craigyjp/Teensy-Hybrid-TDM-Synth/README.md

# A Hybrid 8 voice polyphonic synthesizer that utilizes the Teensy Audio Library for the DCOs, LFO's and envelopes and the analogue filters are Shruthi 4Pole Mission based.

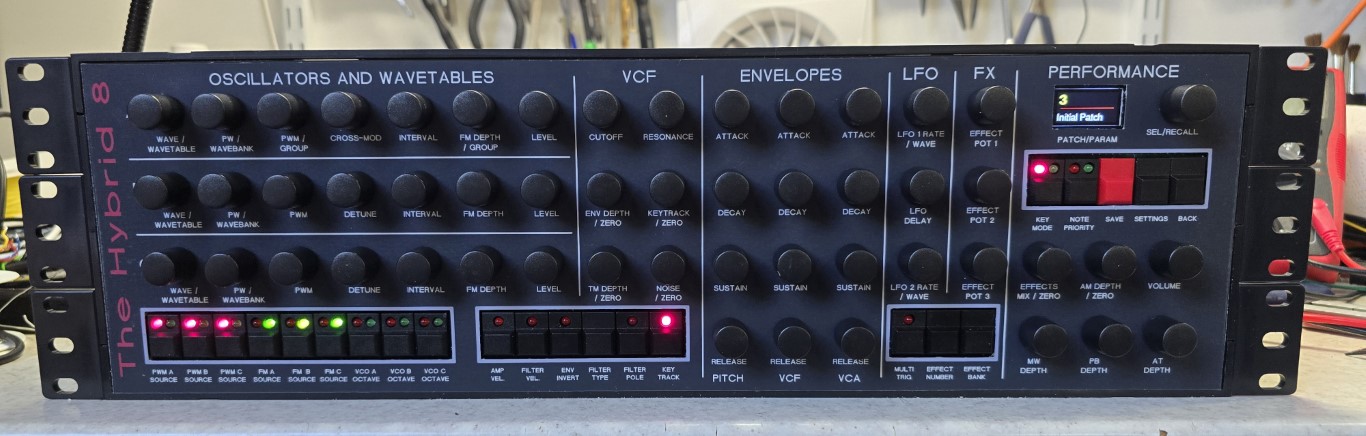
[picture p1: Photos/synth1.jpg]
Synth


I've always wanted to build an oscillator bank that is stable and flexible and has all the usual waveforms of sine, square, triangle, saw and pwm. 

Without a good autoutune the options are limited to Juno 106 style counter DCO's for a polysynth, but seeing how the Teensy Audio Library supports the CS42448 TDM device with 8 outputs. It is possible to build a DCO bank and feed each group of DCOs out of an individual output. These can then feed individual 4 pole analogue filters.

It's early days, but I have an 8 voice, 3 DCO per voice model working with 7 waveforms per DCO, saw, reverse saw, sine, square, triangle, pulse and S&H.

Each DCO has it's own PW and PWM settings and FM depth, interval. The modulation can be from LFO1, Pitch Env and Inverted Pitch Env for FM and LFO2, Pitch Env and Inverted Pitch Env for PWM. These can also be grouped so one set of controls can be used for all 3 DCOs in the voice. Interval is -12 to +12 semitones and this is effectively an octave shift up and down, plus DCOs B & C have a detune. Finally all 3 have a level control as well. There is also a pink and white noise source that can be moved from pink - 0 - white on one encoder.

On top of this if you push the wave encoder button for each VCO then you have access to over 4000 samples of acoustic and electric instruments such as piano etc.

I've made use of the encoder buttons for example, if you push the filter LFO depth encoder it will zero the value and press again it will return to the previous value, same for amplifier LFO depth.  The LFO speed encoders also double as wave selection for the LFOs, so pressing the encoder buttons toggles through the 7 LFO waves.

Also added is a hidden arpeggiator, a press and hold of the Key Mode button switches the synth between arpeggiator and normal operation. Several encoders and buttons are now in charge of the arpeggiator controls, LFO1 rate = Arp rate, LFO Delay = Arp gate time, Amp Velocity = Arp start/stop, Filter Velocity = Arp Hold, VCOB Octave = Arp Range and VCOCOctave = Arp Direction. These settings are stored in patches so you can create arp based patches.

# Features
* 8 voice polyphonic with poly 1, poly 2, mono and unison modes stored in the patch.
* Note priority in Mono and Unison modes, Botton, Top and Last.
* 3 VCOS, with sine, saw up, saw down, square, triangle, pulse (PWM) and random waves.
* PW & PWM per VCO with modulation from LFO2, pitch envelope and inverse (Grouping of parameters)
* FM per VCO with modulation from LFO2, pitch envelope and inverse (Grouping of parameters)
* Cross Modulation from VCO2 to VCO1
* Poly 1, Poly 2, Mono and Unison glide modes.
* Interval settings per VCO with detune on VCO2 & 3
* Volume level setting of each VCO
* Each VCO can be switched to access over 4000 wavetables in 63 banks.
* 4 pole Shruthi filters with pole mixing 16 variations of filter
* Filter Keytrack, filter modulation from LFO1 or LFO2, envelope inversion, filter velocity sensitivity.
* 3 envelopes with full ADSR, pitch envelope for FM and PWM modulation, filter envelope, amplifier envelope.
* VCA with modulation from LFO1 & LFO2
* Dual LFO's with 7 waveforms, Sine, Saw Up, Saw Down, square, triangle, pulse and Sample and hold.
* Delayed LFO upto 10 seconds
* FV1 effects processor with 32 effects algorithms, 3 control pots for variations and an effects mix pot.
* White and pink noise source to the filter.
* Modulation Depth, Aftertouch Depth and Pitchbend Depth controls.
* Full arpeggiator, speed, gate, direction, range and hold.
* MIDI and USB connectivity.
* Full MIDI CC control of parameters

# Things to do

* Maybe add MIDI Clock to the arpeggiator
