craigyjp/Teensy-Hybrid-TDM-Synth/Photos/20250813_210241.jpg

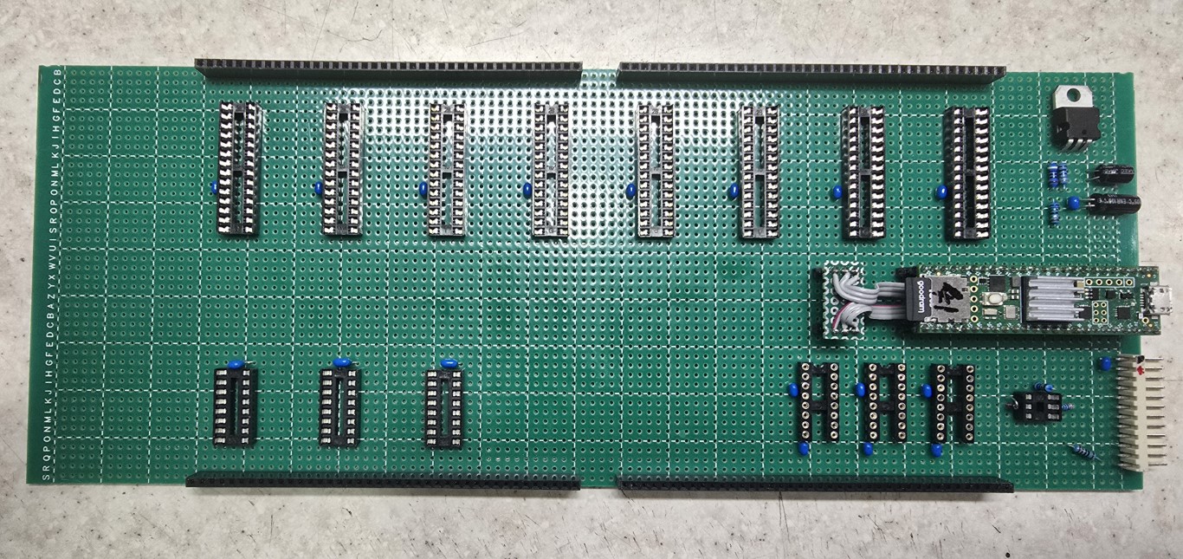
Photos/20250813_210241.jpg
