craigyjp/Teensy-Hybrid-TDM-Synth/Photos/20250813_210249.jpg

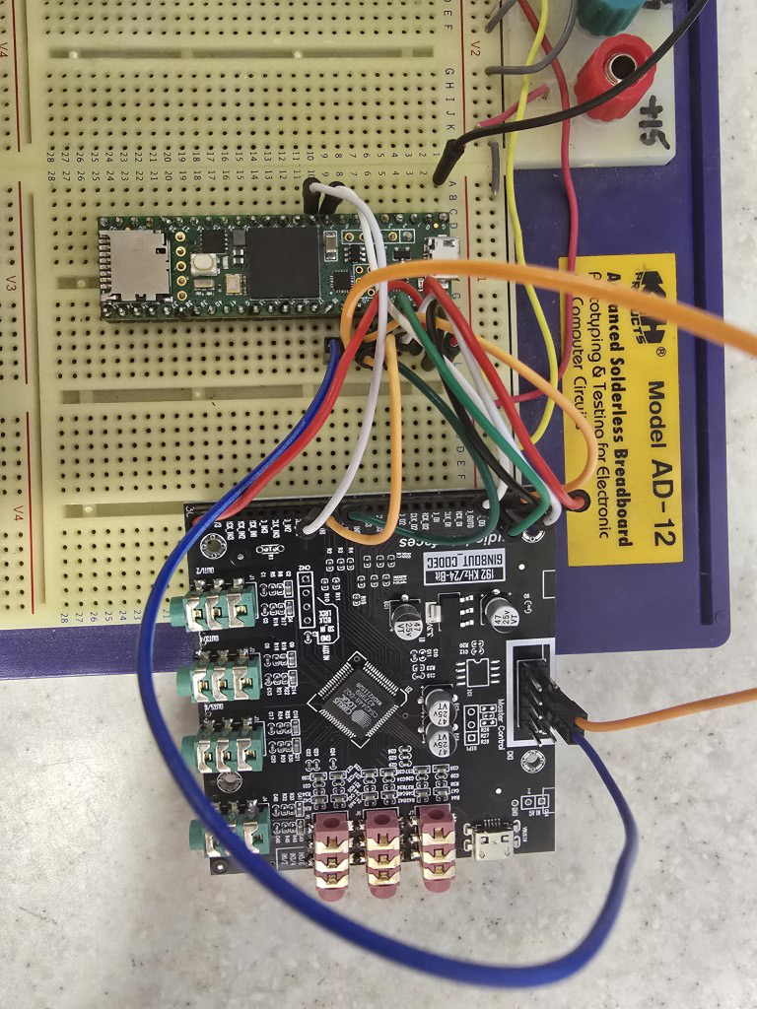
Photos/20250813_210249.jpg
