craigyjp/Teensy-Hybrid-TDM-Synth/Schematics/filter_CV_and_res.pdf

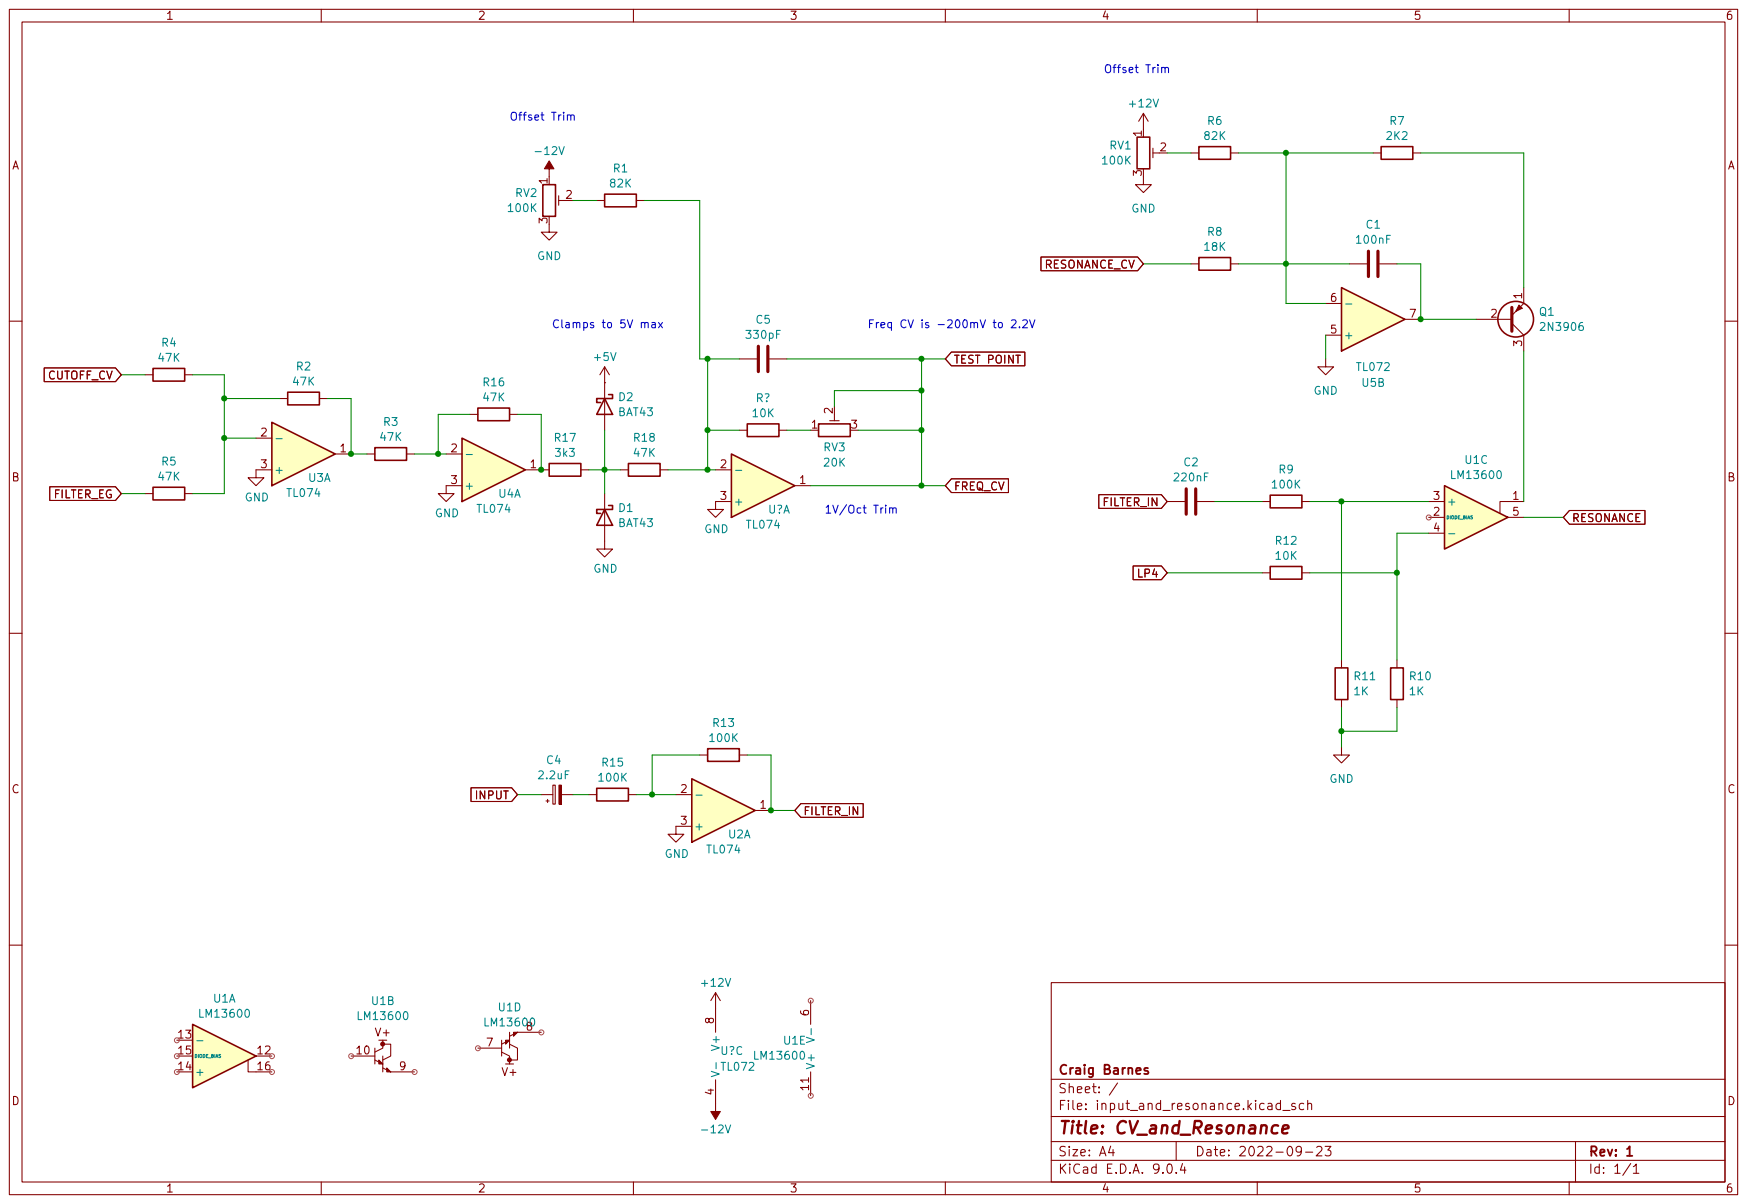
[picture p4: page 1]
