craigyjp/Teensy-Hybrid-TDM-Synth/Schematics/AS2164_core.pdf

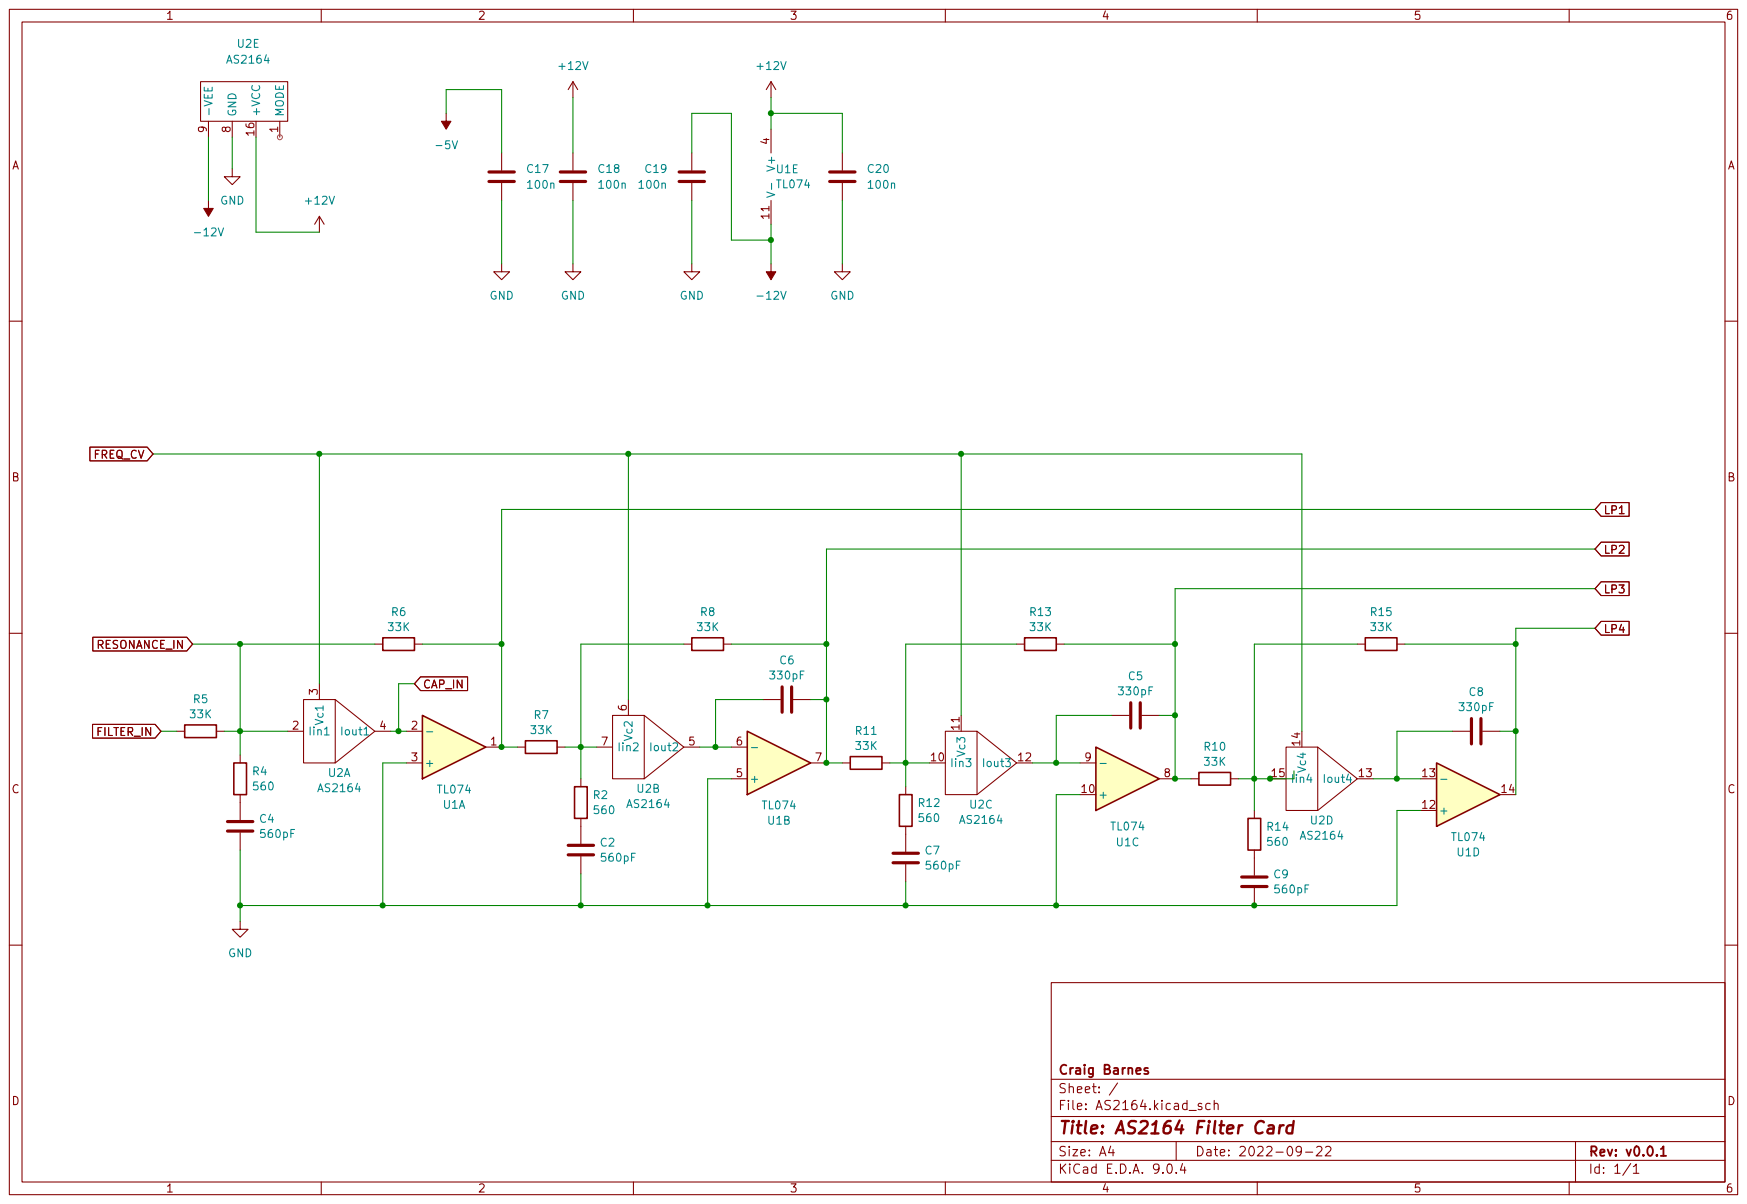
[picture p5: page 1]
