craigyjp/Teensy-Hybrid-TDM-Synth/Schematics/Filter_control_and_EG.pdf

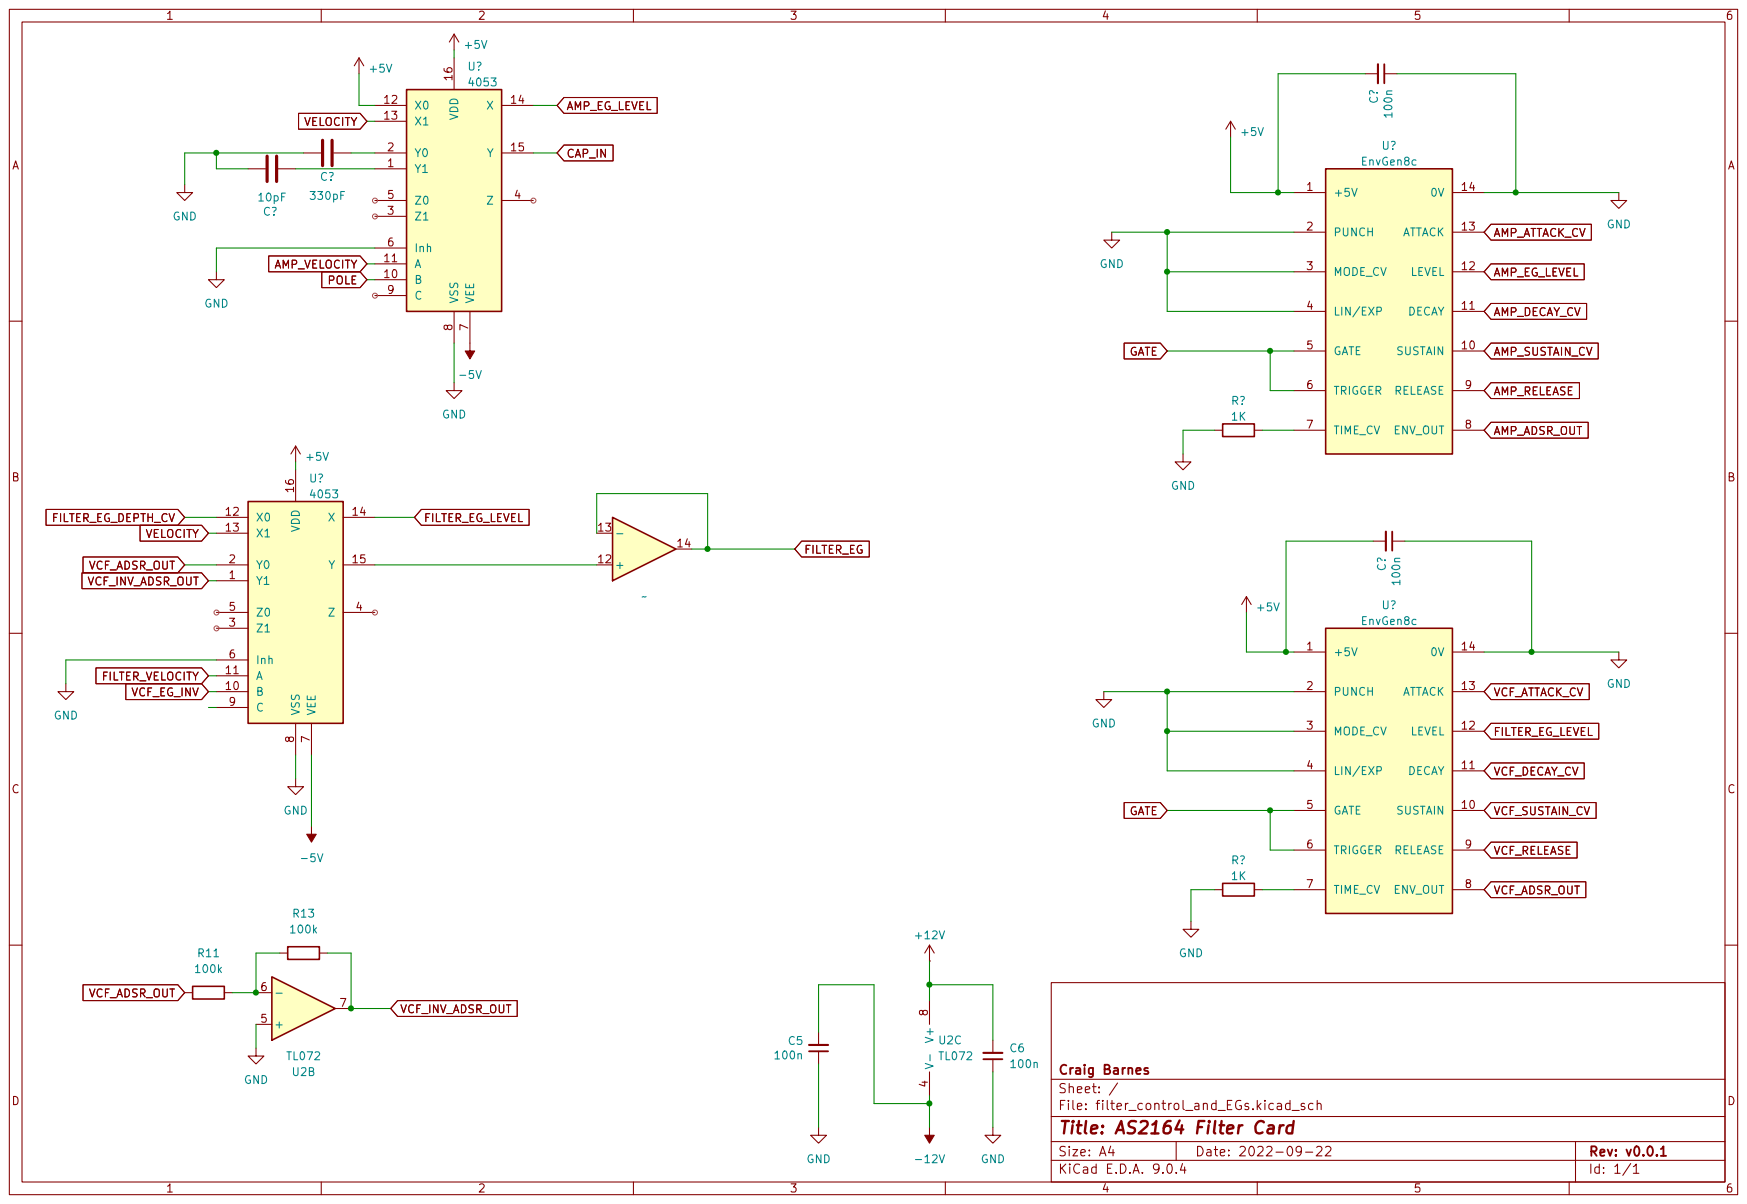
[picture p6: page 1]
