craigyjp/Teensy-Hybrid-TDM-Synth/Schematics/TDMSynth_Logic1.pdf

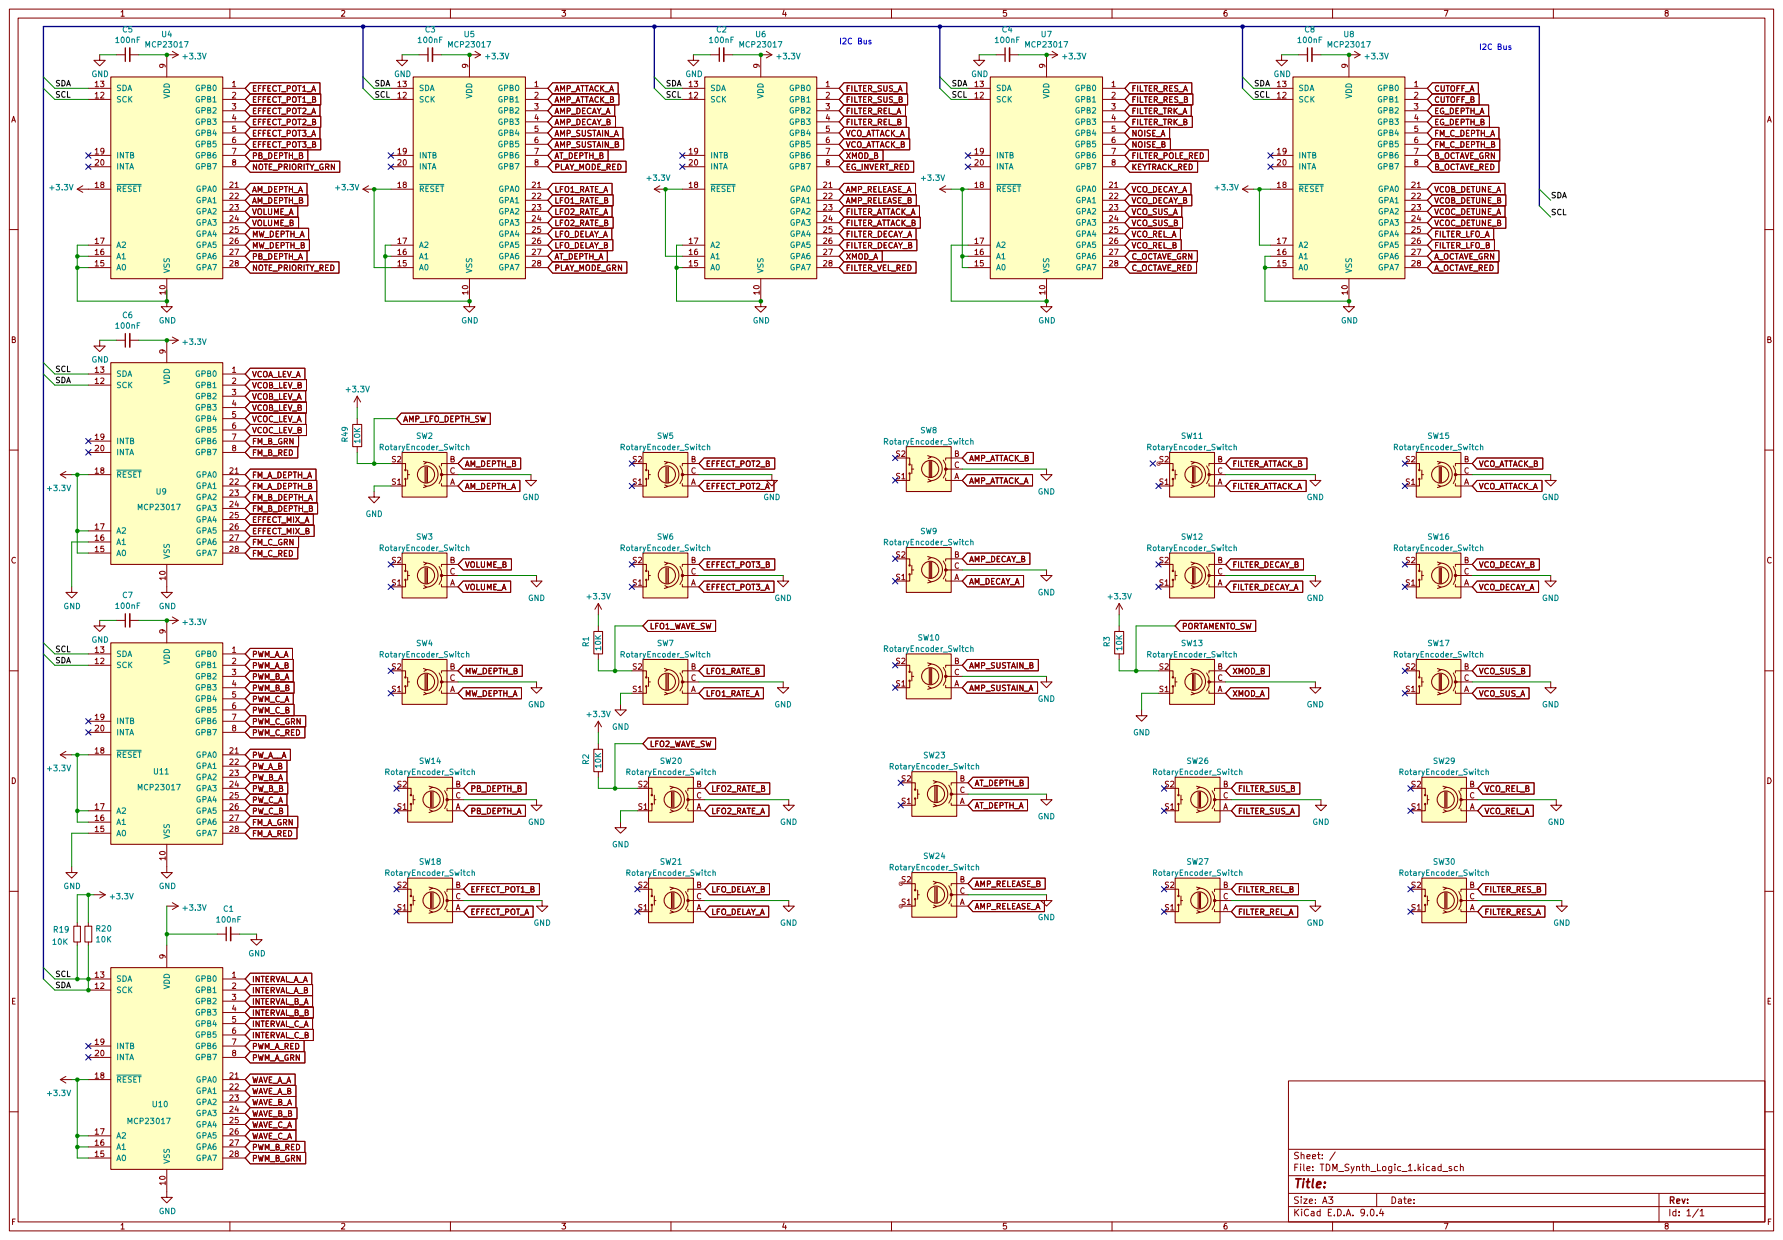
[picture p7: page 1]
