craigyjp/Teensy-Hybrid-TDM-Synth/Schematics/TDMSynth_Logic2.pdf

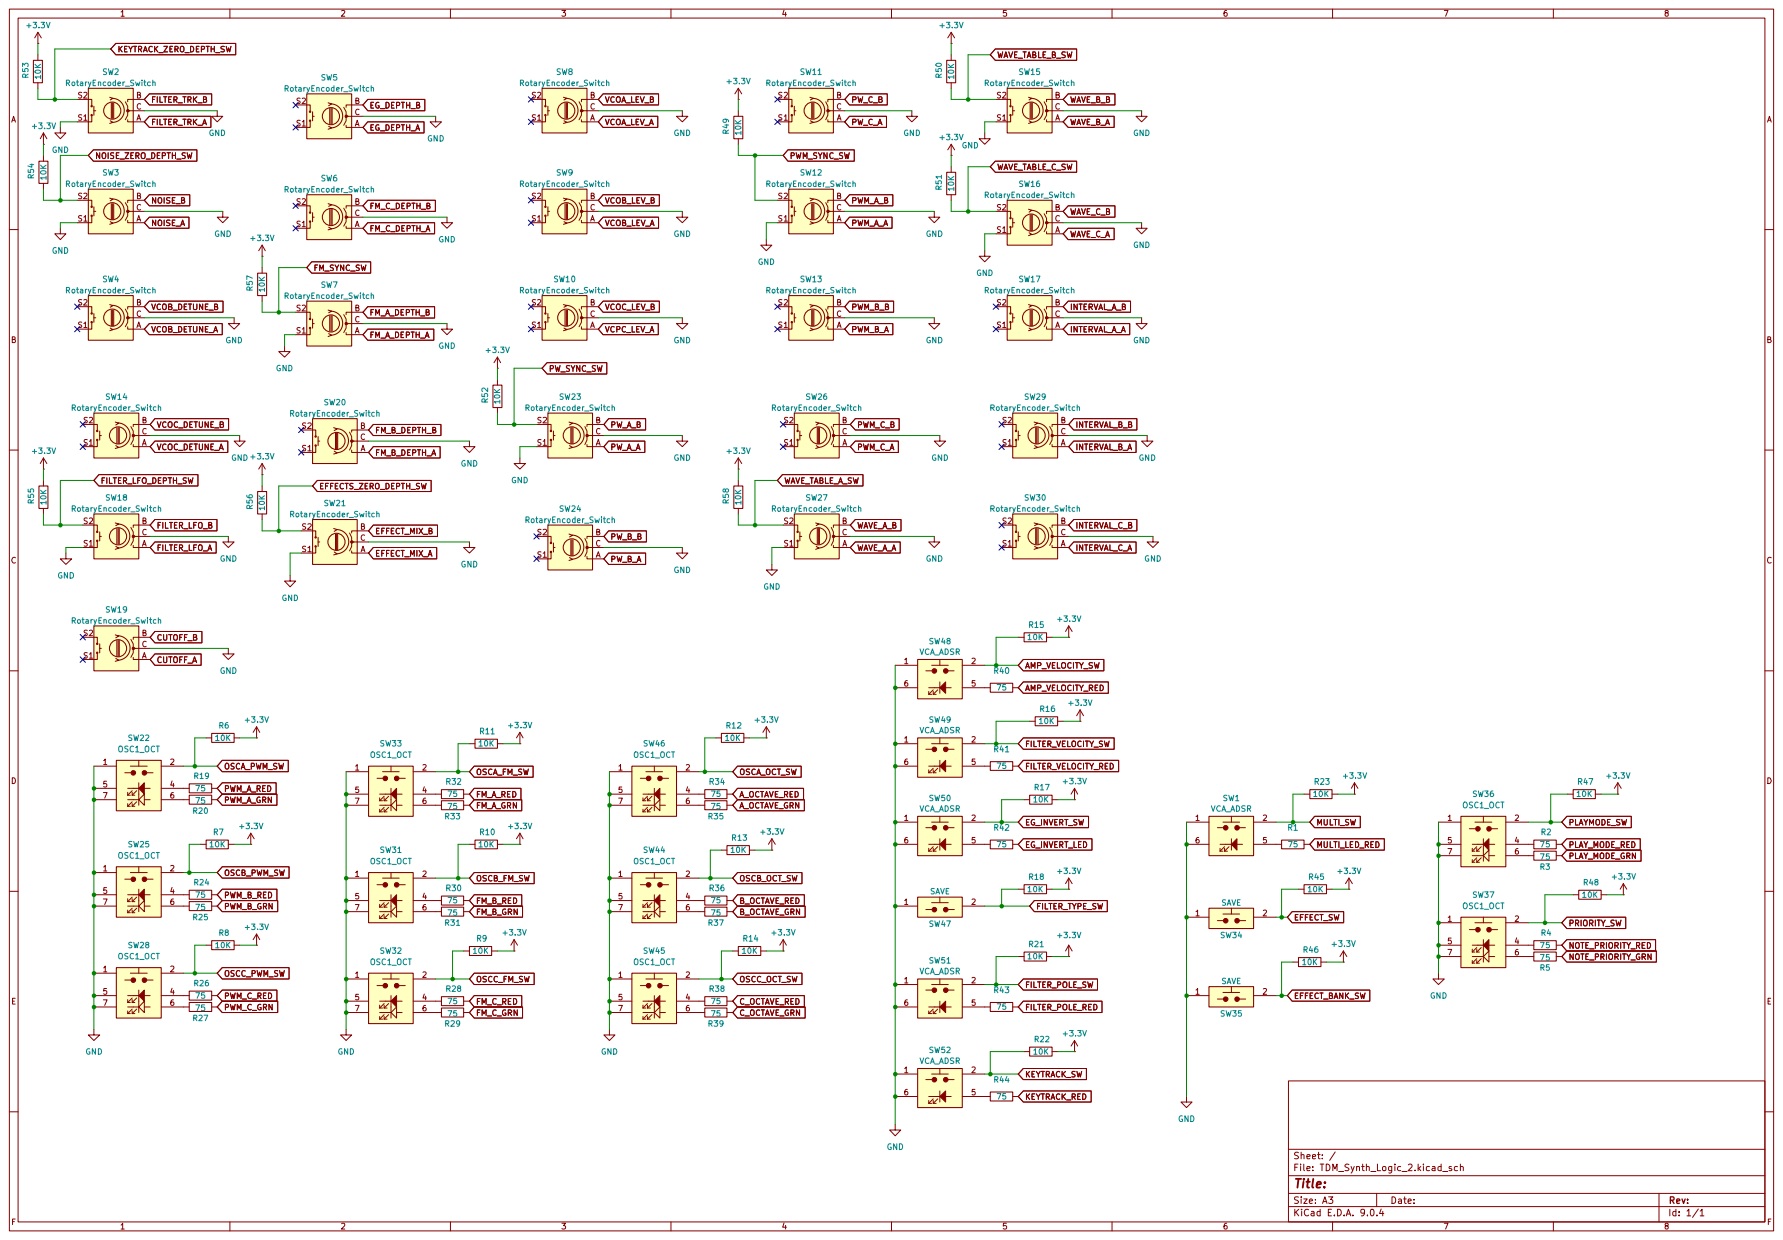
[picture p8: page 1]
