craigyjp/Teensy-Hybrid-TDM-Synth/Schematics/Teensy_board.pdf

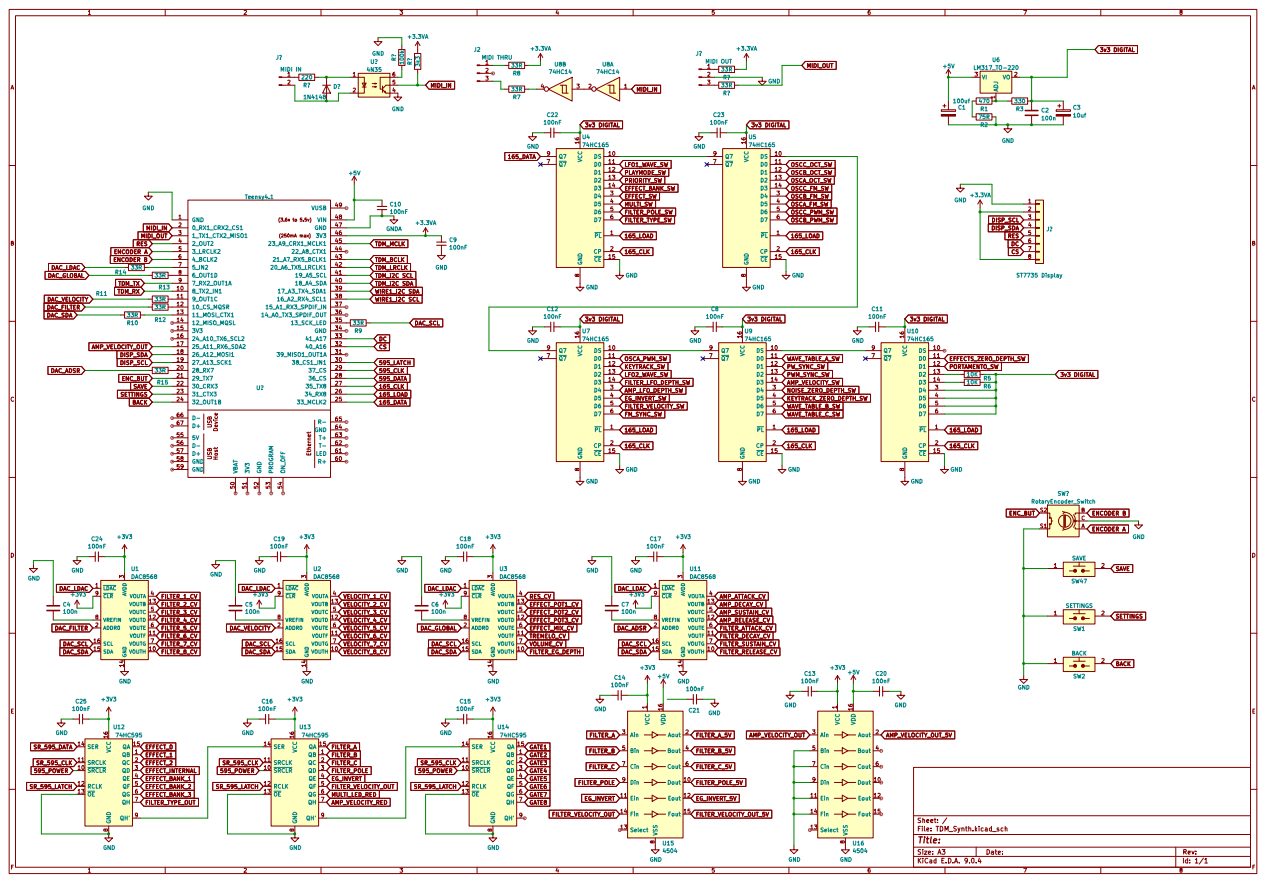
[picture p9: page 1]
