craigyjp/Teensy-Hybrid-TDM-Synth/Schematics/Final_VCA.pdf

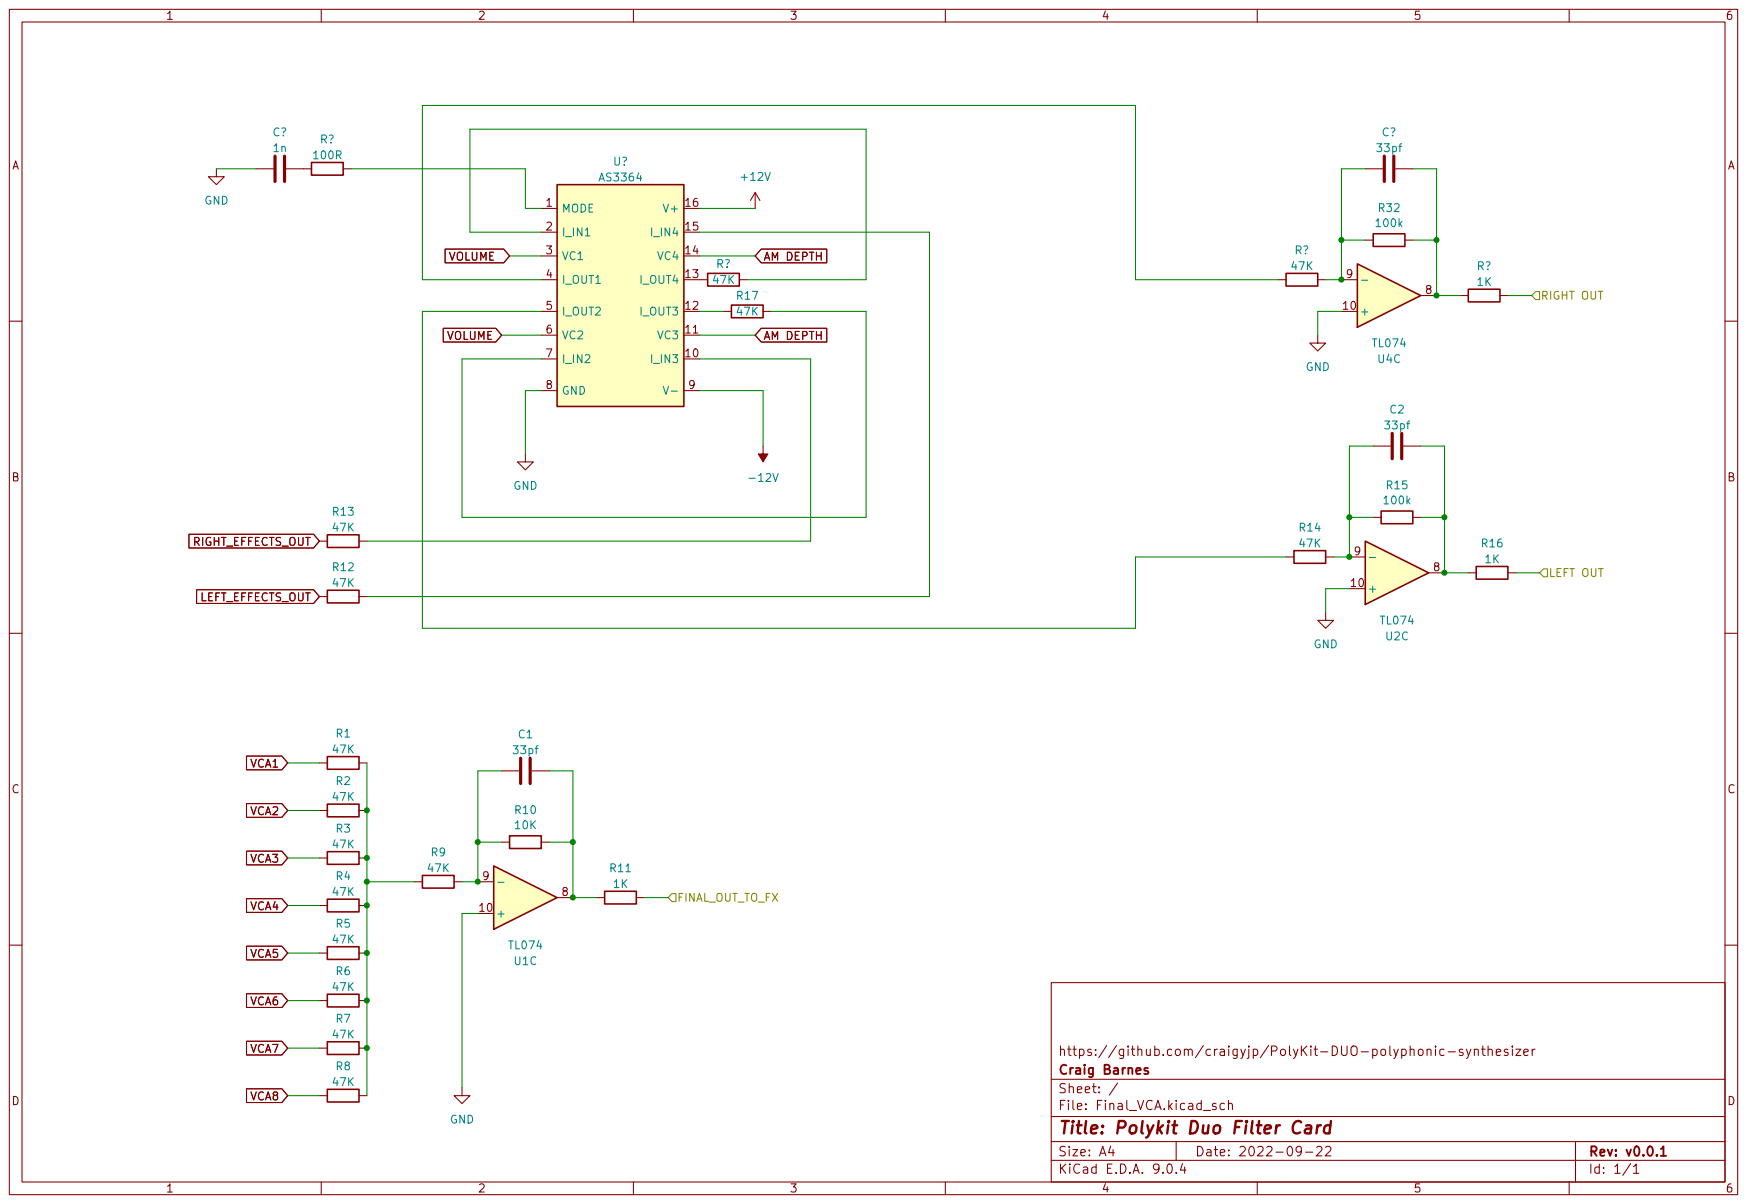
[picture p10: page 1]
