craigyjp/Teensy-Hybrid-TDM-Synth/Schematics/FV1_effects.pdf

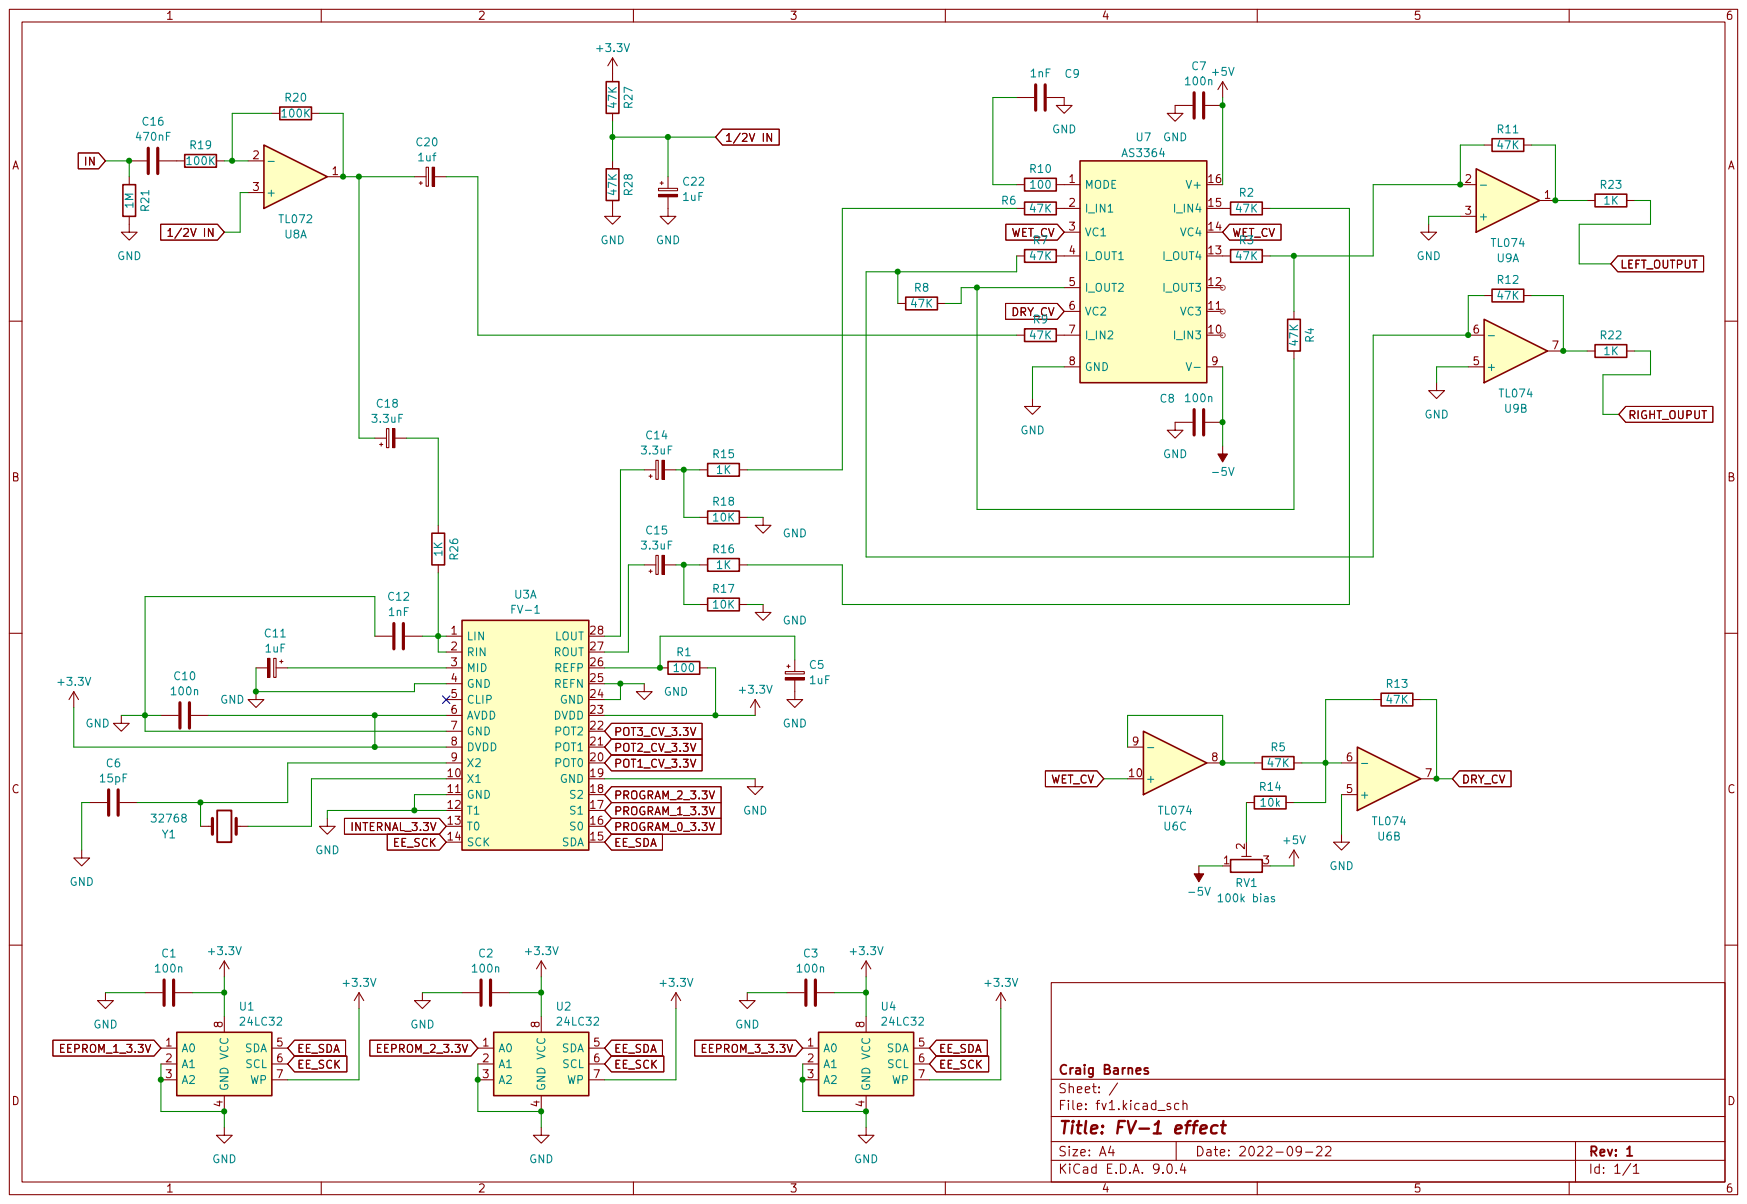
[picture p11: page 1]
