craigyjp/Teensy-Hybrid-TDM-Synth/Schematics/pole_mixer.pdf

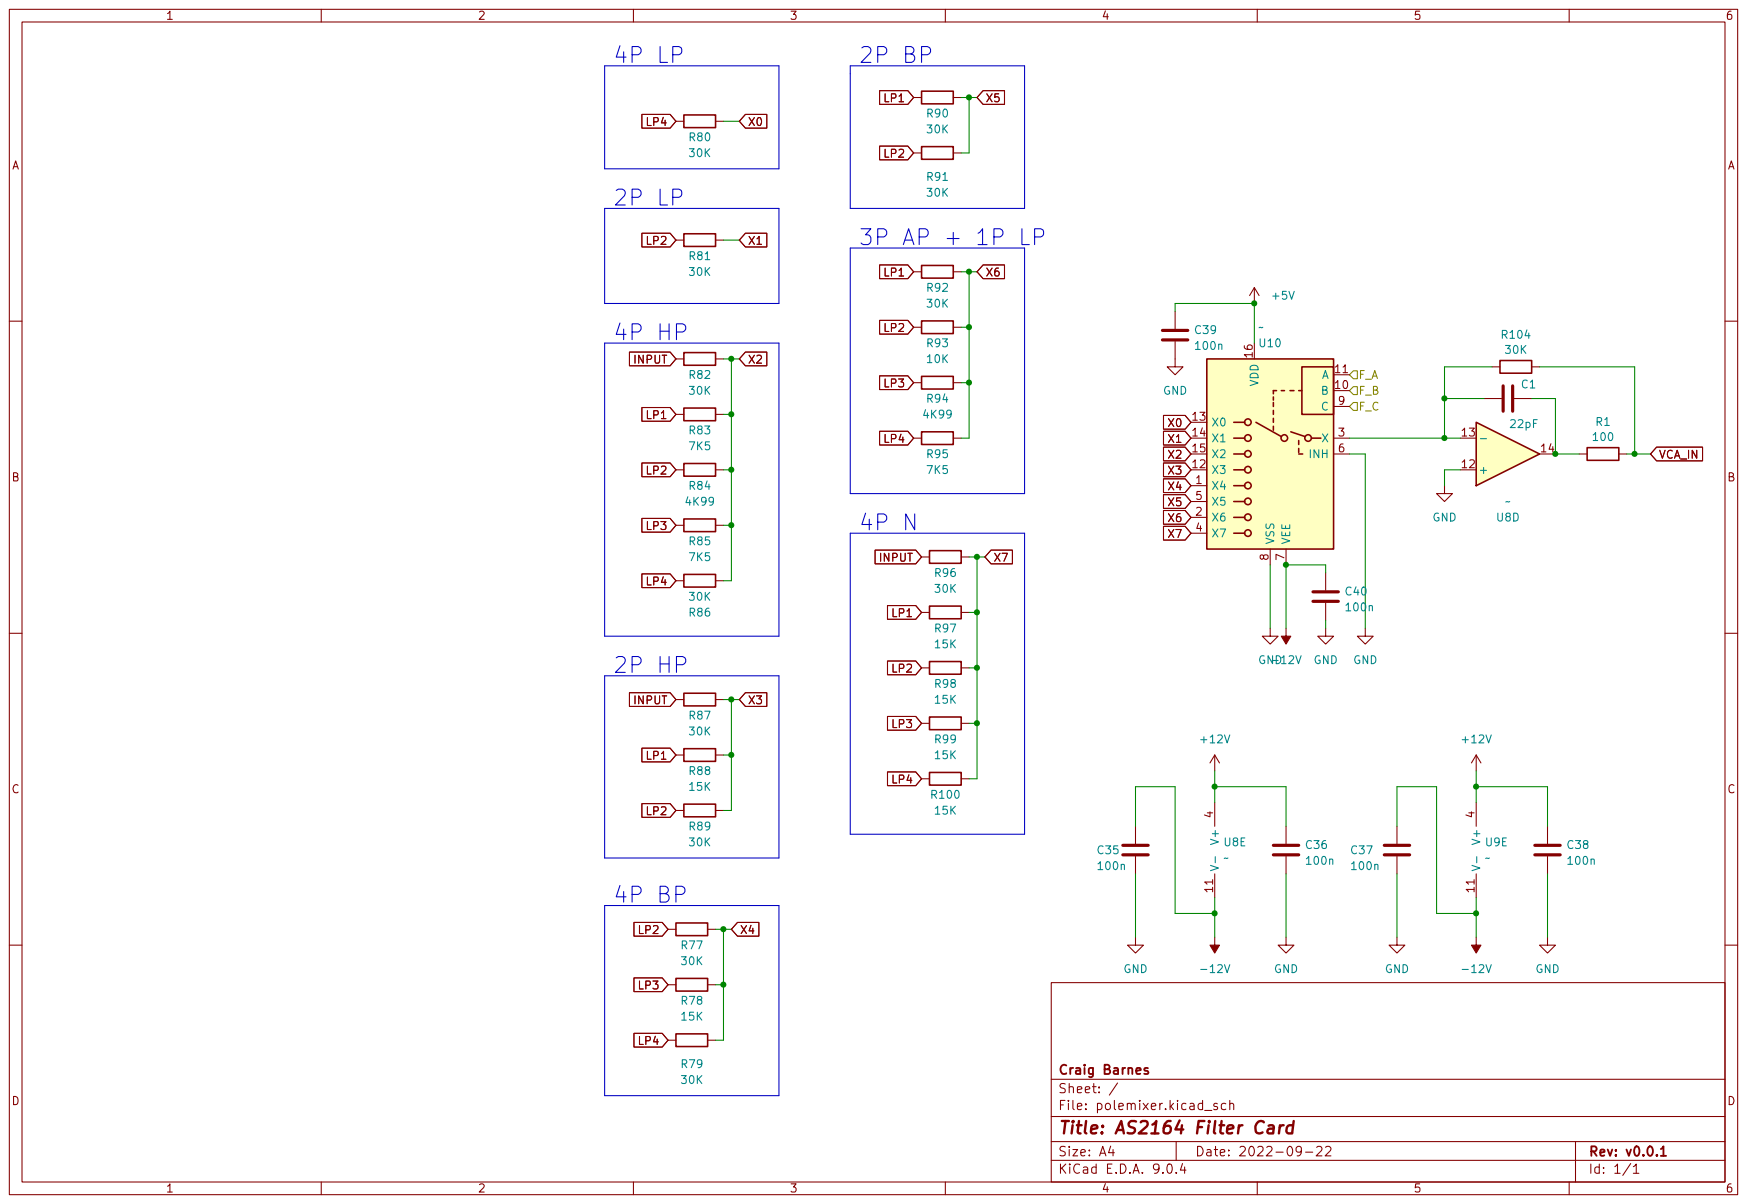
[picture p12: page 1]
