craigyjp/Teensy-Hybrid-TDM-Synth/Schematics/VCAs.pdf

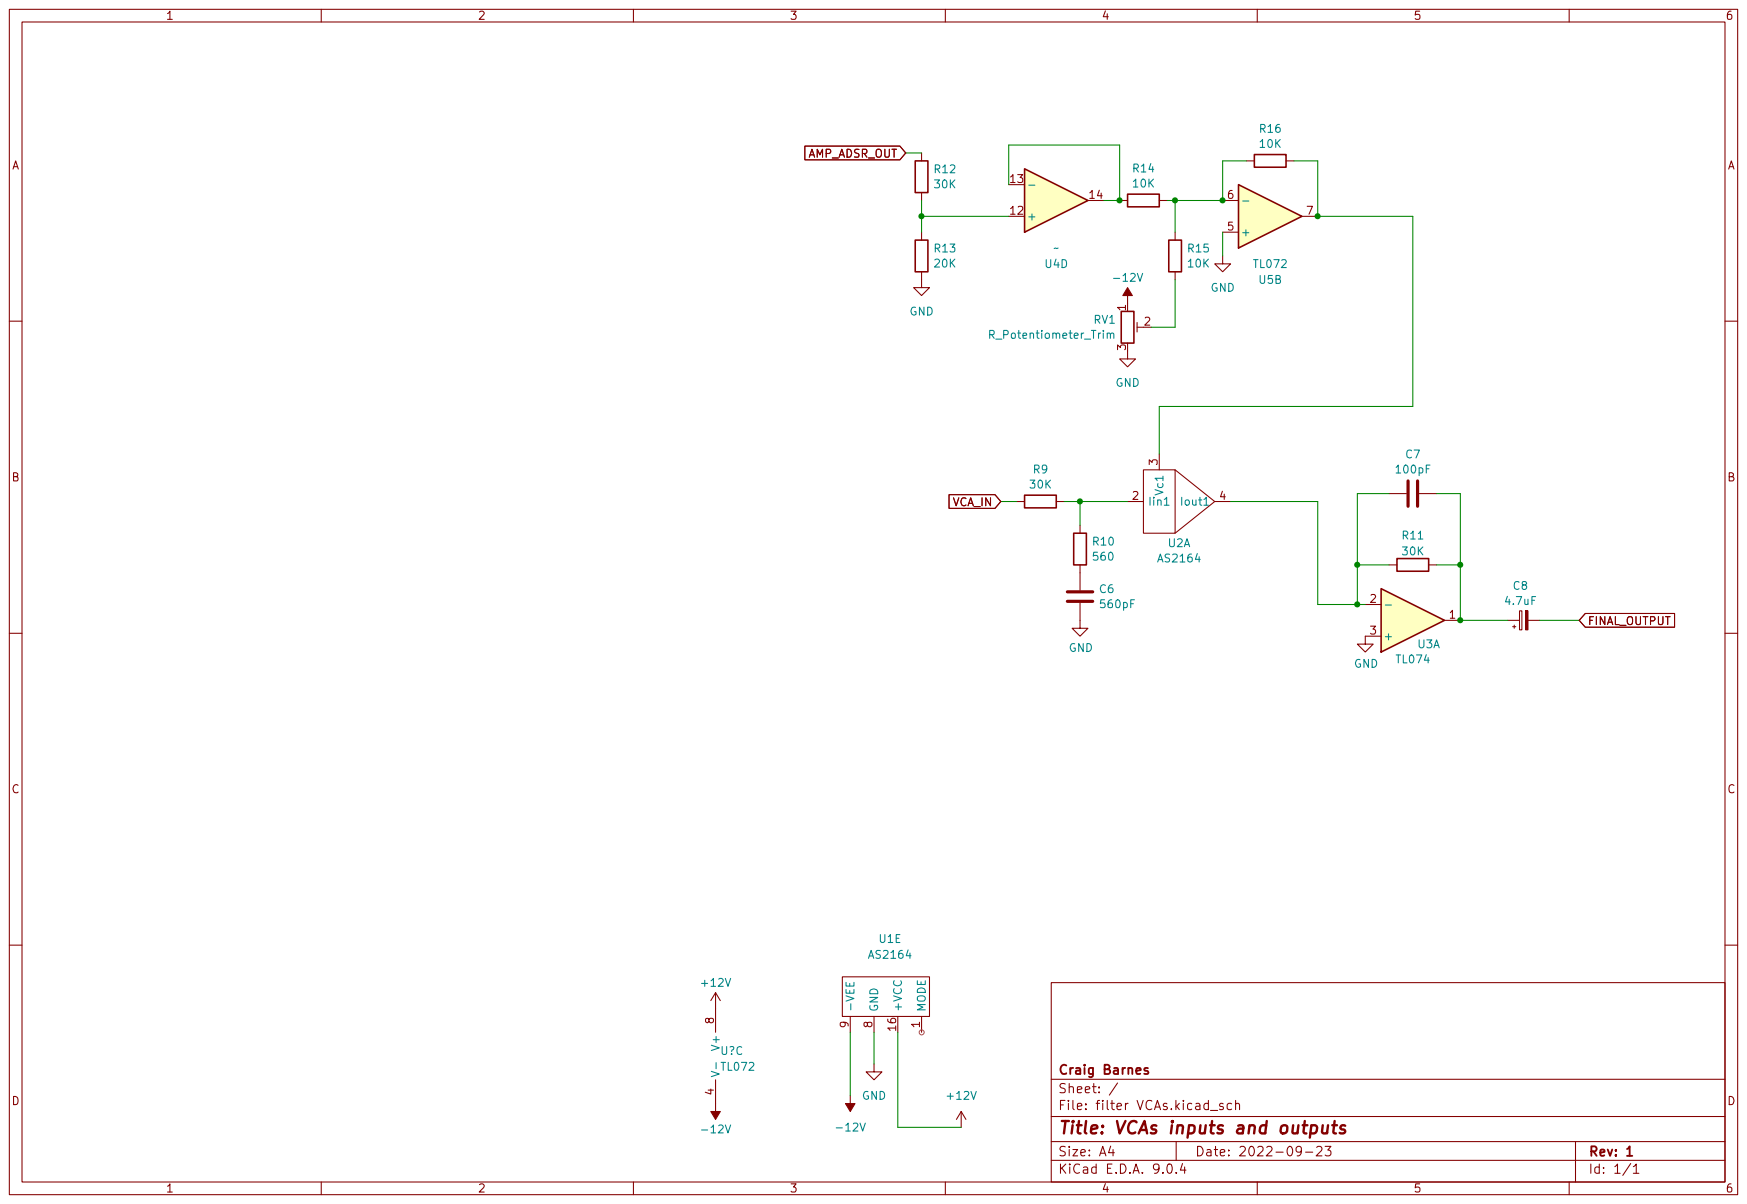
[picture p13: page 1]
