craigyjp/Teensy-Hybrid-TDM-Synth/Src/TDM_Synth.ino

#include <Audio.h>
#include <Wire.h>
#include <SPI.h>
#include <SD.h>
#include <SerialFlash.h>
#include <MIDI.h>
#include "MidiCC.h"
#include <math.h>
#include <RoxMux.h>
#include "Constants.h"
#include "AudioPatch.h"
#include "Parameters.h"
#include "PatchMgr.h"
#include "Button.h"
#include "HWControls.h"
#include "EepromMgr.h"
#include "Wavetables.h"

#define PARAMETER 0      //The main page for displaying the current patch and control (parameter) changes
#define RECALL 1         //Patches list
#define SAVE 2           //Save patch page
#define REINITIALISE 3   // Reinitialise message
#define PATCH 4          // Show current patch bypassing PARAMETER
#define PATCHNAMING 5    // Patch naming page
#define DELETE 6         //Delete patch page
#define DELETEMSG 7      //Delete patch message page
#define SETTINGS 8       //Settings page
#define SETTINGSVALUE 9  //Settings page

unsigned int state = PARAMETER;

EXTMEM int16_t wavetablePSRAM[BANKS][MAX_TABLES_PER_BANK][TABLE_SIZE];
uint16_t stagingBuffer[TABLE_SIZE];  // stays in RAM
uint16_t tablesInBank[BANKS];        // track how many tables per bank

#include "ST7735Display.h"

bool cardStatus = false;

MIDI_CREATE_INSTANCE(HardwareSerial, Serial1, MIDI);

#include "Settings.h"

/* ============================================================
   SETUP / RUNTIME
   ============================================================ */

void pollAllMCPs();

void initRotaryEncoders();

//void initButtons();

int getEncoderSpeed(int id);


void setup() {
  Serial.begin(115200);
  AudioMemory(350);  // plenty for 8 voices + queues

  SPI.begin();

  setupDisplay();
  setUpSettings();
  setupHardware();

  delay(100);

  if (cs42448.enable() && cs42448.volume(0.7)) {
    Serial.println("configured CS42448");
  } else {
    Serial.println("failed to config CS42448");
  }

  delay(100);

  cardStatus = SD.begin(BUILTIN_SDCARD);
  if (cardStatus) {
    Serial.println("SD card is connected");
    //Get patch numbers and names from SD card
    loadAllBanks();
    loadPatches();
    if (patches.size() == 0) {
      //save an initialised patch to SD card
      savePatch("1", INITPATCH);
      loadPatches();
    }
  } else {
    Serial.println("SD card is not connected or unusable");

    //reinitialiseToPanel();
    showPatchPage("No SD", "conn'd / usable");
  }

  Wire.begin();
  Wire.setClock(400000);  // Slow down I2C to 100kHz
  delay(10);

  mcp1.begin(0);
  delay(10);
  mcp2.begin(1);
  delay(10);
  mcp3.begin(2);
  delay(10);
  mcp4.begin(3);
  delay(10);
  mcp5.begin(4);
  delay(10);
  mcp6.begin(5);
  delay(10);
  mcp7.begin(6);
  delay(10);
  mcp8.begin(7);
  delay(10);

  //groupEncoders();
  initRotaryEncoders();
  //initButtons();

  setupMCPoutputs();

  // --- LFOs ---
  LFO1.begin(WAVEFORM_SINE);
  LFO1.amplitude(1.0f);
  LFO1.frequency(2.0f);

  LFO2.begin(WAVEFORM_TRIANGLE);
  LFO2.amplitude(1.0f);
  LFO2.frequency(5.0f);

  // Common DC/LFO/noise
  dc_one.amplitude(1.0f);        // gates envs
  dc_neg1.amplitude(-1.0f);      // for *inverting* envelopes
  dc_pwmAbias.amplitude(0.50f);  // center point for PW A (0..1)
  dc_pwmBbias.amplitude(0.50f);  // center point for PW B
  dc_pwmCbias.amplitude(0.50f);  // center point for PW C

  // --- Noise mix (start muted; raise if you want noise in voices) ---
  noiseMix.gain(0, 0.0f);  // white
  noiseMix.gain(1, 0.0f);  // pink
  noiseMix.gain(2, 0.0f);
  noiseMix.gain(3, 0.0f);

  noiseWhite.amplitude(1.0f);
  noisePink.amplitude(1.0f);

  // Init all per-voice bits
  for (uint8_t v = 1; v <= 8; ++v) {
    // Voice mixer: A,B,C on ch0..2, noise on ch3
    vMix[v]->gain(0, 0.8f);
    vMix[v]->gain(1, 0.8f);
    vMix[v]->gain(2, 0.8f);
    vMix[v]->gain(3, 0.0f);  // raise if you want per-voice noise

    // Pitch selector mixers: default to LFO, depth 0 (you’ll set via UI)
    zero4(*pitchA[v]);
    zero4(*pitchB[v]);
    zero4(*pitchC[v]);
    pitchA[v]->gain(0, 0.0f);  // LFO1 depth
    pitchB[v]->gain(0, 0.0f);
    pitchC[v]->gain(0, 0.0f);

    // PWM selector mixers: keep DC bias at 1.0 on ch3; others start at 0
    zero4(*pwmA[v]);
    zero4(*pwmB[v]);
    zero4(*pwmC[v]);
    pwmA[v]->gain(3, 1.0f);
    pwmB[v]->gain(3, 1.0f);
    pwmC[v]->gain(3, 1.0f);

    // DCOs: use pulse for PWM input, set base amplitudes/freqs
    dcoA[v]->begin(WAVEFORM_BANDLIMIT_SAWTOOTH);
    dcoB[v]->begin(WAVEFORM_BANDLIMIT_SAWTOOTH);
    dcoC[v]->begin(WAVEFORM_BANDLIMIT_SAWTOOTH);

    // set each voice’s *carrier* frequency elsewhere when you assign notes
    // but a safe boot value helps sanity:
    dcoA[v]->frequency(440.0f);
    dcoB[v]->frequency(440.0f);
    dcoC[v]->frequency(440.0f);

    dcoA[v]->amplitude(0.8f);
    dcoB[v]->amplitude(0.8f);
    dcoC[v]->amplitude(0.8f);
  }

  // --- Start queues you’ll read (IMPORTANT) ---
  qLFO1.begin();
  qLFO1_amp.begin();
  qLFO2.begin();
  qLFO2_amp.begin();

  pitchDirty = true;

  // USB MIDI
  usbMIDI.setHandleNoteOn(myNoteOn);
  usbMIDI.setHandleNoteOff(myNoteOff);
  usbMIDI.setHandlePitchChange(myPitchBend);
  usbMIDI.setHandleControlChange(myControlConvert);
  usbMIDI.setHandleProgramChange(myProgramChange);
  usbMIDI.setHandleAfterTouchChannel(myAfterTouch);

  MIDI.begin(MIDI_CHANNEL_OMNI);
  MIDI.setHandleNoteOn(myNoteOn);
  MIDI.setHandleNoteOff(myNoteOff);
  MIDI.setHandlePitchBend(myPitchBend);
  MIDI.setHandleControlChange(myControlConvert);
  MIDI.setHandleProgramChange(myProgramChange);
  MIDI.setHandleAfterTouchChannel(myAfterTouch);
  MIDI.turnThruOn(midi::Thru::Mode::Off);
  Serial.println("MIDI In DIN Listening");

  //Read Encoder Direction from EEPROM
  encCW = getEncoderDir();

  //Read MIDI In Channel from EEPROM
  midiChannel = getMIDIChannel();

  //Read MIDI Out Channel from EEPROM
  midiOutCh = getMIDIOutCh();

  // Read the encoders accelerate
  accelerate = getEncoderAccelerate();

  // Setup the Unison detune
  uniNotes = getUnisonNotes();
  unidetune = getUnisonDetune();
  setDetune();
  initGlide();
  arpInit();

  octoswitch.begin(PIN_DATA, PIN_LOAD, PIN_CLK);
  octoswitch.setCallback(onButtonPress);
  octoswitch.setIgnoreAfterHold(PLAYMODE_SW, true);

  srp.begin(LED_DATA, LED_LATCH, LED_CLK, LED_PWM);

  spiSend32(DAC_FILTER, int_ref_on_flexible_mode);
  delayMicroseconds(100);

  spiSend32(DAC_VELOCITY, int_ref_on_flexible_mode);
  delayMicroseconds(100);

  spiSend32(DAC_GLOBAL, int_ref_on_flexible_mode);
  delayMicroseconds(100);

  spiSend32(DAC_ADSR, int_ref_on_flexible_mode);
  delayMicroseconds(100);

  recallPatch(patchNo);
}

static inline void arpRecomputeTiming() {
  arpGate = constrain(arpGate, 0.05f, 0.95f);  // protect too-short/long gates
  arpGateUs = (uint32_t)(arpIntervalUs * arpGate);
}

void arpInit() {
  arpRecomputeTiming();
}

inline bool ARP_ACTIVE() {
  return arpEnabled && arpRunning;
}

static inline float mapDelayToGatePercent(uint8_t d) {
  // linear 5%..95% (adjust curve if you want more control at short gates)
  return 0.05f + (0.90f * (d / 127.0f));
}

// ===== Start/Stop do transport only (timers + note-offs) =====
void arpStart() {
  arpRunning = true;
  arpStepIdx = 0;
  arpTimer = 0;
  arpGateTimer = 0;
  noteIsOn = false;
  lastArpNote = -1;
}

void arpStop(bool allOff = true) {
  if (noteIsOn && lastArpNote >= 0 && allOff) {
    arpNoteOffMode = true;
    myNoteOff(midiChannel, (uint8_t)lastArpNote, 0);
    arpNoteOffMode = false;
  }
  noteIsOn = false;
  lastArpNote = -1;
  arpRunning = false;
  arpTimer = 0;
  arpGateTimer = 0;
}

// --- helper: silence current arp note but keep transport running ---
static inline void arpEnsureSilent() {
  if (noteIsOn && lastArpNote >= 0) {
    arpNoteOffMode = true;
    myNoteOff(midiChannel, (uint8_t)lastArpNote, 0);
    arpNoteOffMode = false;
  }
  noteIsOn = false;
  lastArpNote = -1;
  arpTimer = 0;  // no backlog while idle
  arpGateTimer = 0;
}

// ===== Enable/Disable affect only UI routing; disabling cleans transport =====
void arpEnable() {
  arpEnabled = true; /* do not start */
}

void arpDisable() {
  if (arpRunning) arpStop(true);
  arpEnabled = false;
  // optional: clear pool if you want a hard disable
  // arpNoteCount = 0; arpPoolDirty = true;
}

// Utility

inline void arpClearPoolAndKillSound() {
  // turn off currently sounding arp note (if any)
  if (lastArpNote >= 0) {
    arpNoteOffMode = true;
    myNoteOff(midiChannel, (uint8_t)lastArpNote, 0);
    arpNoteOffMode = false;
    lastArpNote = -1;
  }
  // clear latched set
  arpNoteCount = 0;
  arpPoolDirty = true;
  // reset phase/timers so the new chord starts cleanly
  arpStepIdx = 0;
  arpTimer = 0;
}

void arpClearPool() {
  arpNoteCount = 0;
  arpPoolDirty = true;
  lastArpNote = -1;
}

void arpSeedFromHeld() {
  arpClearPool();
  for (uint16_t n = 0; n < 128 && arpNoteCount < ARP_MAX_NOTES; ++n) {
    if (heldDown[n]) arpNotes[arpNoteCount++] = (uint8_t)n;
  }
  arpPoolDirty = true;
  arpStepIdx = 0;
}

void arpPruneToHeld() {
  if (arpNoteCount == 0) return;

  uint8_t write = 0;
  for (uint8_t read = 0; read < arpNoteCount; ++read) {
    const uint8_t n = arpNotes[read];
    if (heldDown[n]) arpNotes[write++] = n;
  }
  arpNoteCount = write;
  arpPoolDirty = true;
  arpStepIdx = 0;

  if (arpNoteCount == 0) {
    if (noteIsOn && lastArpNote >= 0) {
      arpNoteOffMode = true;
      myNoteOff(midiChannel, (uint8_t)lastArpNote, 0);
      arpNoteOffMode = false;
      noteIsOn = false;
      lastArpNote = -1;
    }
    allNotesOff();
  }
}

inline bool arpHasNotes() {
  return arpNoteCount > 0;
}

// ---------- Note pool management ----------
static void arpSortAscending(uint8_t *a, uint8_t len) {
  for (uint8_t i = 0; i + 1 < len; ++i)
    for (uint8_t j = i + 1; j < len; ++j)
      if (a[j] < a[i]) {
        uint8_t t = a[i];
        a[i] = a[j];
        a[j] = t;
      }
}

void arpAddNote(uint8_t note) {
  for (uint8_t i = 0; i < arpNoteCount; ++i)
    if (arpNotes[i] == note) return;
  if (arpNoteCount < ARP_MAX_NOTES) {
    arpNotes[arpNoteCount++] = note;
    arpPoolDirty = true;
  }
  arpStepIdx = 0;
  // If we were idle, start clean (no backlog)
  if (!arpRunning && arpEnabled) arpStart();
}

// ---------- Direction iterator ----------
static uint16_t arpCycleLen(uint8_t base) {
  if (base == 0) return 1;
  // one full octave sweep across all notes, per octave
  switch (arpDirection) {
    case 0:  // Up
    case 1:  // Down
    case 3:  // Random
      return base;
    case 2:  // UpDown (no repeated endpoints)
      return (base < 2) ? base : (2 * base - 2);
  }
  return base;
}

static uint8_t arpIndexFor(uint16_t pos, uint8_t base) {
  // pos is position within one *direction* cycle for a single octave
  switch (arpDirection) {
    case 0:  // Up
      return pos % base;
    case 1:  // Down
      return (uint8_t)(base - 1 - (pos % base));
    case 2:
      {  // UpDown bounce, avoid endpoint repeat
        if (base < 2) return 0;
        uint16_t span = (uint16_t)(2 * base - 2);
        uint16_t p = pos % span;
        return (p < base) ? p : (uint8_t)(span - p);
      }
    case 3:  // Random (index is random every step)
      return (uint8_t)random(base);
  }
  return pos % base;
}

// Shuffle-once option for Random (stable until pool changes)
// Not strictly required with index randomization; left here for future use.
static void arpMaybePreparePool() {
  if (!arpPoolDirty) return;
  if (arpNoteCount == 0) return;
  arpSortAscending(arpNotes, arpNoteCount);
  // For Random, we still keep ascending pool and randomize via index per step.
  arpPoolDirty = false;
}

// ---------- Next note (SINGLE source of truth) ----------
static int nextArpNote() {
  if (arpNoteCount == 0) return -1;

  arpMaybePreparePool();

  // Per-octave directional position
  const uint16_t baseLen = arpNoteCount;
  const uint16_t dirSpan = arpCycleLen(baseLen);
  const uint16_t posInDir = (uint16_t)(arpStepIdx % dirSpan);
  const uint8_t baseIdx = arpIndexFor(posInDir, baseLen);

  // Which octave within arpRange?
  // Advance octave after finishing one *direction* cycle.
  const uint16_t dirRound = (uint16_t)(arpStepIdx / dirSpan);
  const uint8_t oct = (arpRange == 0 ? 0 : (uint8_t)(dirRound % arpRange));

  int note = (int)arpNotes[baseIdx] + (int)(12 * oct);
  if (note < 0) note = 0;
  if (note > 127) note = 127;
  return note;
}

void arpRemoveNote(uint8_t note) {
  // remove one instance
  for (uint8_t i = 0; i < arpNoteCount; ++i) {
    if (arpNotes[i] == note) {
      for (uint8_t j = i; j + 1 < arpNoteCount; ++j) arpNotes[j] = arpNotes[j + 1];
      arpNoteCount--;
      arpPoolDirty = true;
      break;
    }
  }

  arpStepIdx = 0;  // deterministic restart of iteration

  if (arpNoteCount == 0 && !arpHold) {
    // ensure silence but keep arpRunning true (transport stays armed)
    if (noteIsOn && lastArpNote >= 0) {
      arpNoteOffMode = true;
      myNoteOff(midiChannel, (uint8_t)lastArpNote, 0);
      arpNoteOffMode = false;
      noteIsOn = false;
      lastArpNote = -1;
    }
    allNotesOff();  // synth-wide safety
    // Do NOT call arpStop() here.
  }
}

void arpStepEngine() {
  if (!ARP_ACTIVE()) {
    arpTimer = 0;  // avoid backlog while inactive
    return;
  }

  // If no notes (and not holding), keep transport running but silent, no backlog
  if (!arpHold && !arpHasNotes()) {
    arpTimer = 0;
    if (noteIsOn && lastArpNote >= 0) {
      arpNoteOffMode = true;
      myNoteOff(midiChannel, (uint8_t)lastArpNote, 0);
      arpNoteOffMode = false;
      noteIsOn = false;
      lastArpNote = -1;
    }
    return;
  }

  // Wait for step boundary
  if (arpTimer < arpIntervalUs) return;
  arpTimer -= arpIntervalUs;

  // End prior note (protect against ties/overlap)
  if (noteIsOn && lastArpNote >= 0) {
    arpNoteOffMode = true;
    myNoteOff(midiChannel, (uint8_t)lastArpNote, 0);
    arpNoteOffMode = false;
    noteIsOn = false;
    lastArpNote = -1;
  }

  // Compute next and emit
  int n = nextArpNote();  // assumes pool/dir/octave logic elsewhere
  if (n < 0) return;

  arpModeActive = true;  // guard to avoid recursion in myNoteOn
  myNoteOn(midiChannel, (uint8_t)n, 100);
  arpModeActive = false;

  lastArpNote = n;
  noteIsOn = true;
  arpGateTimer = 0;  // gate timing begins
  arpStepIdx += 1;
}


void arpGateService() {
  if (!ARP_ACTIVE()) return;
  if (!noteIsOn || lastArpNote < 0) return;
  if (arpGateTimer >= arpGateUs) {
    arpNoteOffMode = true;
    myNoteOff(midiChannel, (uint8_t)lastArpNote, 0);
    arpNoteOffMode = false;
    noteIsOn = false;
  }
}

// Optional: initialise
void initGlide() {
  for (int v = 0; v < NO_OF_VOICES; ++v) {
    voiceCurrentNote[v] = -1.0f;
    voiceTargetNote[v] = -1.0f;
    voiceGlideActive[v] = false;
    lastAssignedNote[v] = -1;
  }
}

void updateGlideFromPot(uint8_t glidePotValue, bool announce) {

  float norm = glidePotValue / 255.0f;

  float glideTime = 0.001f + powf(norm, 3.0f) * 10.0f;

  // scale dt to get musical glide
  const float baseDt = 0.002f;  // 2ms pitch update
  const float scale = 20.0f;    // tune this value
  float effectiveDt = baseDt * scale;

  glideCoeff = 1.0f - expf(-effectiveDt / glideTime);

  // --------------------------
  // Format for UI (ms / sec)
  // --------------------------
  float ms = glideTime * 1000.0f;
  String timeStr = (ms < 1000.0f)
                     ? String(ms, 1) + " mS"
                     : String(glideTime, 2) + " S";

  if (announce) {
    showCurrentParameterPage("Portamento", timeStr);
    startParameterDisplay();
  }
}



void stepGlideForVoice(int v) {
  float cur = voiceCurrentNote[v];
  float tgt = voiceTargetNote[v];

  float next = cur + (tgt - cur) * glideCoeff;
  voiceCurrentNote[v] = next;

  if (fabsf(next - tgt) < 0.001f) {
    voiceCurrentNote[v] = tgt;
    voiceGlideActive[v] = false;
  }
}

void stepAllGlides() {
  for (int v = 0; v < NO_OF_VOICES; ++v) {
    stepGlideForVoice(v);
  }
  // if (voiceGlideActive[0]) {
  //   Serial.print("GLIDE v0: cur=");
  //   Serial.print(voiceCurrentNote[0]);
  //   Serial.print("  tgt=");
  //   Serial.println(voiceTargetNote[0]);
  // }
}

void startParameterDisplay() {
  updateScreen();

  lastDisplayTriggerTime = millis();
  waitingToUpdate = true;
}

// ---------- Helpers ----------

// Convert a fractional MIDI note to frequency (Hz)
inline float noteToFreqFloat(float note) {
  return 440.0f * powf(2.0f, (note - 69.0f) / 12.0f);
}

// Convert interval (semitones) into a frequency ratio
inline float intervalToRatio(int semitones) {
  return powf(2.0f, semitones / 12.0f);
}

bool anyGlideActive() {
  for (int v = 0; v < NO_OF_VOICES; ++v)
    if (voiceGlideActive[v]) return true;
  return false;
}


// convenience: zero all 4 inputs on a mixer
inline void zero4(AudioMixer4 &m) {
  m.gain(0, 0);
  m.gain(1, 0);
  m.gain(2, 0);
  m.gain(3, 0);
}

inline float s16_to_float(int16_t s) {
  return s / 32767.0f;
}

inline float clamp01(float x) {
  return x < 0 ? 0 : (x > 1 ? 1 : x);
}

inline float freq_to_midi(float f) {
  return 69.0f + 12.0f * log2f(f / 440.0f);
}

inline float midi_to01(float n) {
  return clamp01(n / 127.0f);
}

// map voice index -> that voice's current note frequency
inline float voiceFreq(int v) {
  switch (v) {
    case 1: return noteFreqs[note1freq];
    case 2: return noteFreqs[note2freq];
    case 3: return noteFreqs[note3freq];
    case 4: return noteFreqs[note4freq];
    case 5: return noteFreqs[note5freq];
    case 6: return noteFreqs[note6freq];
    case 7: return noteFreqs[note7freq];
    default: return noteFreqs[note8freq];
  }
}

inline float ui127_to_time_ms(uint8_t val,
                              float tmin = 1.0f,
                              float tmax = 11880.0f) {
  float n = val / 127.0f;
  return tmin * powf(tmax / tmin, n);
}

inline float ui100_to_sustain(uint8_t val) {
  return constrain(val / 100.0f, 0.0f, 1.0f);
}

// Get a pointer to the Nth voice mixer (0..7)
static inline AudioMixer4 *voiceMixer(int v) {
  switch (v) {
    case 0: return &voiceMix1;
    case 1: return &voiceMix2;
    case 2: return &voiceMix3;
    case 3: return &voiceMix4;
    case 4: return &voiceMix5;
    case 5: return &voiceMix6;
    case 6: return &voiceMix7;
    default: return &voiceMix8;
  }
}

// UI -> Hz helper: 0..127 -> ~0.05..20 Hz (expo)
inline float ui127_to_exp_hz(uint8_t val,
                             float fmin = 0.05f,
                             float fmax = 20.0f) {
  float n = val / 127.0f;
  return fmin * powf(fmax / fmin, n);
}

// 0..255 UI -> 0.0..1.0 pulse width
inline float ui255_to_pw(uint8_t v) {
  float pw = v / 255.0f;
  if (pw < 0.0f) pw = 0.0f;
  if (pw > 1.0f) pw = 1.0f;
  return pw;
}

inline float ui255_to_01(uint8_t v) {
  return v / 255.0f;
}

inline uint16_t scale_to_dac(uint8_t val, float vmax) {
  float frac = val / 255.0f;                           // 0..1
  float volts = frac * vmax;                           // 0..vmax
  return (uint16_t)lroundf((volts / 5.0f) * 4095.0f);  // map to DAC code (5V full-scale)
}

inline uint16_t velocity_to_dac(int velocity) {
  if (velocity < 0) return 0;
  if (velocity > 127) velocity = 127;

  float v = velocity / 127.0f;
  v = powf(v, 0.5f);    // punchy response
  v = 0.1f + 0.9f * v;  // adds a bit of floor weight
  return (uint16_t)lroundf(v * 4095.0f);
}

void setDetune() {
  oldunidetune = unidetune;
  switch (unidetune) {
    case 0:
      detune = 1.000;
      break;
    case 1:
      detune = 1.002;
      break;
    case 2:
      detune = 1.004;
      break;
    case 3:
      detune = 1.006;
      break;
    case 4:
      detune = 1.008;
      break;
    case 5:
      detune = 1.010;
      break;
    case 6:
      detune = 1.012;
      break;
    case 7:
      detune = 1.014;
      break;
    case 8:
      detune = 1.016;
      break;
    case 9:
      detune = 1.018;
      break;
    case 10:
      detune = 1.020;
      break;
  }
  olddetune = detune;
}

void updateEEPromSettings() {

  if (oldunidetune != unidetune) {
    setDetune();
  }
}

void getDelayTime() {
  // Map 0–127 to a curved 0–1.0 range
  float norm = LFO1Delay / 127.0f;  // 0.0 to 1.0
  float curved = norm * norm;       // quadratic taper

  // Scale to 0–10 seconds (in ms)
  interval = curved * 10000.0f;  // 0 to 10000 ms

  // Avoid zero-delay glitches
  if (interval < 50) {
    interval = 50;  // minimum ~50ms
  }
}

void LFODelayHandle() {
  // LFO Delay code
  getDelayTime();

  unsigned long currentMillis = millis();
  if (multiSW && !LFODelayGo) {
    if (oldnumberOfNotes < numberOfNotes) {
      previousMillis = currentMillis;
      oldnumberOfNotes = numberOfNotes;
    }
  }
  if (numberOfNotes > 0) {
    if (currentMillis - previousMillis >= interval) {
      LFODelayGo = 1;
    } else {
      LFODelayGo = 0;
    }
  } else {
    LFODelayGo = 1;
    previousMillis = currentMillis;  //reset timer so its ready for the next time
    oldnumberOfNotes = 0;
  }
}

void myAfterTouch(byte channel, byte value) {

  wheel = value / 127.0f;    // 0.0–1.0 from MIDI CC
  depth = ATDepth / 127.0f;  // 0.0–1.0 from setting

  atFMDepth = wheel * depth * 0.5f;  // half as strong

  for (int v = 1; v <= 8; ++v) {
    pitchA[v]->gain(0, atFMDepth);
    pitchB[v]->gain(0, atFMDepth);
    pitchC[v]->gain(0, atFMDepth);
  }
}

void myProgramChange(byte channel, byte program) {
  state = PATCH;
  patchNo = program + 1;
  recallPatch(patchNo);
  Serial.print("MIDI Pgm Change:");
  Serial.println(patchNo);
  state = PARAMETER;
}

void myPitchBend(byte channel, int pitchValue) {
  float normalized = pitchValue / 8192.0f;
  float semitoneBend = normalized * PBDepth;
  bend = powf(2.0f, semitoneBend / 12.0f);
  pitchDirty = true;
}

void loadAllBanks() {
  for (int bank = 0; bank < BANKS; bank++) {
    loadBank(bank);
  }
}

void loadBank(int bank) {
  char folderPath[64];
  snprintf(folderPath, sizeof(folderPath), "/Wavetables/bank%02d", bank);

  File dir = SD.open(folderPath);
  if (!dir || !dir.isDirectory()) {
    Serial.printf("Bank folder missing: %s\n", folderPath);
    tablesInBank[bank] = 0;
    return;
  }

  //Serial.printf("Loading bank %02d...\n", bank);

  uint16_t count = 0;
  while (true) {
    File entry = dir.openNextFile();
    if (!entry) break;

    if (!entry.isDirectory()) {
      const char *name = entry.name();
      size_t len = strlen(name);
      if (len > 4 && strcasecmp(name + (len - 4), ".bin") == 0) {
        if (count < MAX_TABLES_PER_BANK) {
          loadTableFromFile(bank, count, folderPath, name);
          count++;
        } else {
          //Serial.printf("Bank %02d full, skipping %s\n", bank, name);
        }
      }
    }
    entry.close();
  }

  tablesInBank[bank] = count;
  //Serial.printf("Bank %02d loaded %u tables\n", bank, count);
  dir.close();
}

void loadTableFromFile(int bank, int index, const char *folderPath, const char *filename) {
  char filePath[128];
  snprintf(filePath, sizeof(filePath), "%s/%s", folderPath, filename);

  File f = SD.open(filePath);
  if (!f) {
    Serial.printf("Failed to open %s\n", filePath);
    return;
  }

  size_t bytesRead = f.read(stagingBuffer, TABLE_SIZE * SAMPLE_BYTES);
  f.close();

  if (bytesRead == TABLE_SIZE * SAMPLE_BYTES) {
    memcpy(wavetablePSRAM[bank][index], stagingBuffer, TABLE_SIZE * SAMPLE_BYTES);
    //Serial.printf("  Loaded %s into bank %02d, table %02d\n", filename, bank, index);
  } else {
    //Serial.printf("  Invalid size in %s (got %u bytes)\n", filename, bytesRead);
  }
}

// Build a 32-bit frame: CMD in [31:28], ADDR in [27:24], 12-bit code in [19:8], low 8 zero
static inline uint32_t dac7568_frame(uint8_t cmd, uint8_t addr, uint16_t code12) {
  return ((uint32_t)(cmd & 0x0F) << 24)
         | ((uint32_t)(addr & 0x0F) << 20)
         | ((uint32_t)(code12 & 0x0FFF) << 8);
}

static inline void spiSend32(uint8_t csPin, uint32_t w) {
  SPI.beginTransaction(SPISettings(40000000, MSBFIRST, SPI_MODE1));
  digitalWrite(csPin, LOW);
  SPI.transfer32(w);
  digitalWrite(csPin, HIGH);
  SPI.endTransaction();
}

// ---- Buffered write ----
static inline void dacWriteBuffered(uint8_t csPin, uint8_t ch, uint16_t code12) {
  const uint32_t w = dac7568_frame(0b0010, ch, code12);
  spiSend32(csPin, w);
}

void onButtonPress(uint16_t btnIndex, uint8_t btnType) {

  if (btnIndex == WAVE_TABLE_A_SW && btnType == ROX_PRESSED) {
    vcoATable = !vcoATable;
    myControlChange(midiChannel, CCvcoATable, vcoATable);
  }

  if (btnIndex == WAVE_TABLE_B_SW && btnType == ROX_PRESSED) {
    vcoBTable = !vcoBTable;
    myControlChange(midiChannel, CCvcoBTable, vcoBTable);
  }

  if (btnIndex == WAVE_TABLE_C_SW && btnType == ROX_PRESSED) {
    vcoCTable = !vcoCTable;
    myControlChange(midiChannel, CCvcoCTable, vcoCTable);
  }

  if (btnIndex == OSCA_PWM_SW && btnType == ROX_PRESSED) {
    vcoAPWMsource = vcoAPWMsource + 1;
    if (vcoAPWMsource > 3) {
      vcoAPWMsource = 0;
    }
    myControlChange(midiChannel, CCvcoAPWMsource, vcoAPWMsource);
  }

  if (btnIndex == OSCB_PWM_SW && btnType == ROX_PRESSED) {
    vcoBPWMsource = vcoBPWMsource + 1;
    if (vcoBPWMsource > 3) {
      vcoBPWMsource = 0;
    }
    myControlChange(midiChannel, CCvcoBPWMsource, vcoBPWMsource);
  }

  if (btnIndex == OSCC_PWM_SW && btnType == ROX_PRESSED) {
    vcoCPWMsource = vcoCPWMsource + 1;
    if (vcoCPWMsource > 3) {
      vcoCPWMsource = 0;
    }
    myControlChange(midiChannel, CCvcoCPWMsource, vcoCPWMsource);
  }

  if (btnIndex == OSCA_FM_SW && btnType == ROX_PRESSED) {
    vcoAFMsource = vcoAFMsource + 1;
    if (vcoAFMsource > 3) {
      vcoAFMsource = 0;
    }
    myControlChange(midiChannel, CCvcoAFMsource, vcoAFMsource);
  }

  if (btnIndex == OSCB_FM_SW && btnType == ROX_PRESSED) {
    vcoBFMsource = vcoBFMsource + 1;
    if (vcoBFMsource > 3) {
      vcoBFMsource = 0;
    }
    myControlChange(midiChannel, CCvcoBFMsource, vcoBFMsource);
  }

  if (btnIndex == OSCC_FM_SW && btnType == ROX_PRESSED) {
    vcoCFMsource = vcoCFMsource + 1;
    if (vcoCFMsource > 3) {
      vcoCFMsource = 0;
    }
    myControlChange(midiChannel, CCvcoCFMsource, vcoCFMsource);
  }

  if (btnIndex == OSCA_OCT_SW && btnType == ROX_PRESSED) {
    vcoAOctave = vcoAOctave + 1;
    if (vcoAOctave > 2) {
      vcoAOctave = 0;
    }
    myControlChange(midiChannel, CCvcoAOctave, vcoAOctave);
  }

  if (btnIndex == OSCB_OCT_SW && btnType == ROX_PRESSED) {
    if (arpEnabled) {
      arpRange = arpRange + 1;
      if (arpRange > 4) {
        arpRange = 1;
      }
      updatearpRange(1);
    } else {
      vcoBOctave = vcoBOctave + 1;
      if (vcoBOctave > 2) {
        vcoBOctave = 0;
      }
      myControlChange(midiChannel, CCvcoBOctave, vcoBOctave);
    }
  }

  if (btnIndex == OSCC_OCT_SW && btnType == ROX_PRESSED) {
    if (arpEnabled) {
      arpDirection = (arpDirection + 1) % 4;

      arpStepIdx = 0;  // restart phase on mode change
      updatearpDirection(1);
    } else {
      vcoCOctave = vcoCOctave + 1;
      if (vcoCOctave > 2) {
        vcoCOctave = 0;
      }
      myControlChange(midiChannel, CCvcoCOctave, vcoCOctave);
    }
  }

  if (btnIndex == LFO1_WAVE_SW && btnType == ROX_PRESSED) {
    LFO1Wave = LFO1Wave + 1;
    if (LFO1Wave > 6) {
      LFO1Wave = 0;
    }
    myControlChange(midiChannel, CCLFO1Wave, LFO1Wave);
  }

  if (btnIndex == LFO2_WAVE_SW && btnType == ROX_PRESSED) {
    LFO2Wave = LFO2Wave + 1;
    if (LFO2Wave > 6) {
      LFO2Wave = 0;
    }
    myControlChange(midiChannel, CCLFO2Wave, LFO2Wave);
  }

  if (btnIndex == PORTAMENTO_SW && btnType == ROX_PRESSED) {
    portamento_sw = !portamento_sw;
    if (portamento_sw) {
      showCurrentParameterPage("Portamento", "Control");
    } else {
      showCurrentParameterPage("Cross Mod", "Control");
    }
    startParameterDisplay();
    myControlChange(midiChannel, CCportamento_sw, portamento_sw);
  }

  if (btnIndex == FILTER_LFO_DEPTH_SW && btnType == ROX_PRESSED) {
    if (!filterLFODepthWasToggled) {
      // If it's already 0 and wasn't toggled, do nothing
      if (filterLFODepth == 0) return;

      // Save the current value and set to default
      lastfilterLFODepth = filterLFODepth;
      filterLFODepth = 0;
      filterLFODepthWasToggled = true;
    } else {
      // Toggle back to previous value
      filterLFODepth = lastfilterLFODepth;
      filterLFODepthWasToggled = false;
    }
    myControlChange(midiChannel, CCfilterLFODepthSW, filterLFODepth);
  }

  if (btnIndex == AMP_LFO_DEPTH_SW && btnType == ROX_PRESSED) {
    if (!ampLFODepthWasToggled) {
      // If it's already 0 and wasn't toggled, do nothing
      if (ampLFODepth == 0) return;

      // Save the current value and set to default
      lastampLFODepth = ampLFODepth;
      ampLFODepth = 0;
      ampLFODepthWasToggled = true;
    } else {
      // Toggle back to previous value
      ampLFODepth = lastampLFODepth;
      ampLFODepthWasToggled = false;
    }
    myControlChange(midiChannel, CCampLFODepthSW, ampLFODepth);
  }

  if (btnIndex == NOISE_ZERO_DEPTH_SW && btnType == ROX_PRESSED) {
    if (!noiseLevelWasToggled) {
      // If it's already 0 and wasn't toggled, do nothing
      if (noiseLevel == 0) return;

      // Save the current value and set to default
      lastnoiseLevel = noiseLevel;
      noiseLevel = 0;
      noiseLevelWasToggled = true;
    } else {
      // Toggle back to previous value
      noiseLevel = lastnoiseLevel;
      noiseLevelWasToggled = false;
    }
    myControlChange(midiChannel, CCnoiseLevelSW, noiseLevel);
  }

  if (btnIndex == KEYTRACK_ZERO_DEPTH_SW && btnType == ROX_PRESSED) {
    if (!filterKeyTrackWasToggled) {
      // If it's already 0 and wasn't toggled, do nothing
      if (filterKeyTrack == 0) return;

      // Save the current value and set to default
      lastfilterKeyTrack = filterKeyTrack;
      filterKeyTrack = 0;
      filterKeyTrackWasToggled = true;
    } else {
      // Toggle back to previous value
      filterKeyTrack = lastfilterKeyTrack;
      filterKeyTrackWasToggled = false;
    }
    myControlChange(midiChannel, CCfilterKeyTrackSW, filterKeyTrack);
  }

  if (btnIndex == EFFECTS_ZERO_DEPTH_SW && btnType == ROX_PRESSED) {
    if (!effectsMixWasToggled) {
      // If it's already 0 and wasn't toggled, do nothing
      if (effectsMix == 0) return;

      // Save the current value and set to default
      lasteffectsMix = effectsMix;
      effectsMix = 0;
      effectsMixWasToggled = true;
    } else {
      // Toggle back to previous value
      effectsMix = lasteffectsMix;
      effectsMixWasToggled = false;
    }
    myControlChange(midiChannel, CCeffectsMixSW, effectsMix);
  }

  if (btnIndex == FILTER_TYPE_SW && btnType == ROX_PRESSED) {
    filterType = filterType + 1;
    if (filterType > 7) {
      filterType = 0;
    }
    myControlChange(midiChannel, CCfilterType, filterType);
  }

  if (btnIndex == FILTER_POLE_SW && btnType == ROX_PRESSED) {
    filterPoleSW = !filterPoleSW;
    myControlChange(midiChannel, CCfilterPoleSW, filterPoleSW);
  }

  if (btnIndex == EG_INVERT_SW && btnType == ROX_PRESSED) {
    egInvertSW = !egInvertSW;
    myControlChange(midiChannel, CCegInvertSW, egInvertSW);
  }

  if (btnIndex == KEYTRACK_SW && btnType == ROX_PRESSED) {
    filterKeyTrackSW = !filterKeyTrackSW;
    myControlChange(midiChannel, CCfilterKeyTrackSW, filterKeyTrackSW);
  }

  if (btnIndex == FILTER_VELOCITY_SW && btnType == ROX_PRESSED) {
    if (arpEnabled) {
      arpHold = !arpHold;

      if (arpHold) {
        // Entering hold: next chord should replace whatever is latched now
        arpAwaitingNewChord = true;
      } else {
        arpPruneToHeld();  // this already does NOT stop transport
        if (!arpHasNotes()) {
          arpEnsureSilent();  // stay running but idle
        }
      }
      updatearpHold(1);
    } else {
      filterVelocitySW = !filterVelocitySW;
      myControlChange(midiChannel, CCfilterVelocitySW, filterVelocitySW);
    }
  }

  if (btnIndex == AMP_VELOCITY_SW && btnType == ROX_PRESSED) {
    if (arpEnabled) {
      arpRunning = !arpRunning;
      if (!arpRunning) {
        arpStop(true);
      } else {
        arpStart();
      }
      updatearpRunning(1);
    } else {
      ampVelocitySW = !ampVelocitySW;
      myControlChange(midiChannel, CCampVelocitySW, ampVelocitySW);
    }
  }

  if (btnIndex == FM_SYNC_SW && btnType == ROX_PRESSED) {
    FMSyncSW = !FMSyncSW;
    myControlChange(midiChannel, CCFMSyncSW, FMSyncSW);
  }

  if (btnIndex == PW_SYNC_SW && btnType == ROX_PRESSED) {
    PWSyncSW = !PWSyncSW;
    myControlChange(midiChannel, CCPWSyncSW, PWSyncSW);
  }

  if (btnIndex == PWM_SYNC_SW && btnType == ROX_PRESSED) {
    PWMSyncSW = !PWMSyncSW;
    myControlChange(midiChannel, CCPWMSyncSW, PWMSyncSW);
  }

  if (btnIndex == MULTI_SW && btnType == ROX_PRESSED) {
    multiSW = !multiSW;
    myControlChange(midiChannel, CCmultiSW, multiSW);
  }

  if (btnIndex == EFFECT_SW && btnType == ROX_PRESSED) {
    effectNumberSW = effectNumberSW + 1;
    if (effectNumberSW > 7) {
      effectNumberSW = 0;
    }
    myControlChange(midiChannel, CCeffectNumSW, effectNumberSW);
  }

  if (btnIndex == EFFECT_BANK_SW && btnType == ROX_PRESSED) {
    effectBankSW = effectBankSW + 1;
    if (effectBankSW > 3) {
      effectBankSW = 0;
    }
    myControlChange(midiChannel, CCeffectBankSW, effectBankSW);
  }

  if (btnIndex == PLAYMODE_SW && btnType == ROX_HELD) {
    arpEnabled = !arpEnabled;
    if (!arpEnabled) {
      arpDisable();
      showCurrentParameterPage("Arp", "Disabled");
      updatevcoBOctave(0);
      updatevcoCOctave(0);
      updateampVelocitySwitch(0);
      updatefilterVelocitySwitch(0);
    } else {
      arpEnable();
      showCurrentParameterPage("Arp", "Enabled");
      updatearpRange(0);
      updatearpDirection(0);
      updatearpRunning(0);
      updatearpHold(0);
    }
    startParameterDisplay();
  } else if (btnIndex == PLAYMODE_SW && btnType == ROX_RELEASED) {
    playModeSW = playModeSW + 1;
    if (playModeSW > 3) {
      playModeSW = 0;
    }
    myControlChange(midiChannel, CCplayModeSW, playModeSW);
  }

  if (btnIndex == PRIORITY_SW && btnType == ROX_PRESSED) {
    if (playModeSW > 1) {
      notePrioritySW = notePrioritySW + 1;
      if (notePrioritySW > 2) {
        notePrioritySW = 0;
      }
      myControlChange(midiChannel, CCnotePrioritySW, notePrioritySW);
    }
  }
}

void myControlConvert(byte channel, byte control, byte value) {
  myControlChange(channel, control, value);
}

void myControlChange(byte channel, byte control, int value) {
  switch (control) {

    case CCmodWheelinput:
      {
        wheel = value / 127.0f;    // 0.0–1.0 from MIDI CC
        depth = MWDepth / 127.0f;  // 0.0–1.0 from setting

        mwFMDepth = wheel * depth * 0.5f;  // half as strong

        for (int v = 1; v <= 8; ++v) {
          pitchA[v]->gain(0, mwFMDepth);
          pitchB[v]->gain(0, mwFMDepth);
          pitchC[v]->gain(0, mwFMDepth);
        }
      }
      break;

    case CCampLFODepth:
      ampLFODepth = map(value, 0, 127, -127, 127);
      updateampLFODepth(1);
      break;

    case CCmasterVolume:
      volumeLevel = map(value, 0, 127, 0, 255);
      updatevolumeLevel(1);
      break;

    case CCMWDepth:
      MWDepth = value;
      updateMWDepth(1);
      break;

    case CCPBDepth:
      PBDepth = map(value, 0, 127, 0, 12);
      updatePBDepth(1);
      break;

    case CCATDepth:
      ATDepth = value;
      updateATDepth(1);
      break;

    case CCeffectPot1:
      effectPot1 = map(value, 0, 127, 0, 255);
      updateeffectPot1(1);
      break;

    case CCeffectPot2:
      effectPot2 = map(value, 0, 127, 0, 255);
      updateeffectPot2(1);
      break;

    case CCeffectPot3:
      effectPot3 = map(value, 0, 127, 0, 255);
      updateeffectPot3(1);
      break;

    case CCLFO1Rate:
      LFO1Rate = value;
      updateLFO1Rate(1);
      break;

    case CCLFO2Rate:
      LFO2Rate = value;
      updateLFO2Rate(1);
      break;

    case CCLFO1Delay:
      LFO1Delay = value;
      updateLFO1Delay(1);
      break;

    case CCampAttack:
      ampAttack = value;
      updateampAttack(1);
      break;

    case CCampDecay:
      ampDecay = value;
      updateampDecay(1);
      break;

    case CCampSustain:
      ampSustain = map(value, 0, 127, 0, 100);
      updateampSustain(1);
      break;

    case CCampRelease:
      ampRelease = value;
      updateampRelease(1);
      break;

    case CCfilterAttack:
      filterAttack = value;
      updatefilterAttack(1);
      break;

    case CCfilterDecay:
      filterDecay = value;
      updatefilterDecay(1);
      break;

    case CCfilterSustain:
      filterSustain = map(value, 0, 127, 0, 100);
      updatefilterSustain(1);
      break;

    case CCfilterRelease:
      filterRelease = value;
      updatefilterRelease(1);
      break;

    case CCpitchAttack:
      pitchAttack = value;
      updatepitchAttack(1);
      break;

    case CCpitchDecay:
      pitchDecay = value;
      updatepitchDecay(1);
      break;

    case CCpitchSustain:
      pitchSustain = map(value, 0, 127, 0, 100);
      updatepitchSustain(1);
      break;

    case CCpitchRelease:
      pitchRelease = value;
      updatepitchRelease(1);
      break;

    case CCfilterResonance:
      filterResonance = map(value, 0, 127, 0, 255);
      updatefilterResonance(1);
      break;

    case CCfilterKeyTrack:
      filterKeyTrack = map(value, 0, 127, -127, 127);
      updatefilterKeyTrack(1);
      break;

    case CCnoiseLevel:
      noiseLevel = map(value, 0, 127, -127, 127);
      updatenoiseLevel(1);
      break;

    case CCfilterCutoff:
      filterCutoff = map(value, 0, 127, 0, 255);
      updatefilterCutoff(1);
      break;

    case CCfilterEGDepth:
      filterEGDepth = map(value, 0, 127, 0, 255);
      updatefilterEGDepth(1);
      break;

    case CCvcoCFMDepth:
      vcoCFMDepth = map(value, 0, 127, 0, 255);
      updatevcoCFMDepth(1);
      break;

    case CCvcoBDetune:
      vcoBDetune = value;
      updatevcoBDetune(1);
      break;

    case CCvcoCDetune:
      vcoCDetune = value;
      updatevcoCDetune(1);
      break;

    case CCfilterLFODepth:
      filterLFODepth = map(value, 0, 127, -127, 127);
      updatefilterLFODepth(1);
      break;

    case CCvcoAFMDepth:
      vcoAFMDepth = map(value, 0, 127, 0, 255);
      updatevcoAFMDepth(1);
      break;

    case CCvcoBFMDepth:
      vcoBFMDepth = map(value, 0, 127, 0, 255);
      updatevcoBFMDepth(1);
      break;

    case CCeffectsMix:
      effectsMix = map(value, 0, 127, -127, 127);
      updateeffectsMix(1);
      break;

    case CCvcoALevel:
      vcoALevel = map(value, 0, 127, 0, 255);
      updatevcoALevel(1);
      break;

    case CCvcoBLevel:
      vcoBLevel = map(value, 0, 127, 0, 255);
      updatevcoBLevel(1);
      break;

    case CCvcoCLevel:
      vcoCLevel = map(value, 0, 127, 0, 255);
      updatevcoCLevel(1);
      break;

    case CCvcoAPW:
      if (!vcoATable) {
        vcoAPW = map(value, 0, 127, 0, 255);
        updatevcoAPW(1);
      } else {
        vcoAWaveBank = map(value, 0, 127, 1, BANKS);
        vcoAWaveNumber = 1;
        showCurrentParameterPage("OscA Bank", String(Tablenames[vcoAWaveBank - 1]));
        startParameterDisplay();
        updatevcoAWave(0);
      }
      break;

    case CCvcoBPW:
      if (!vcoBTable) {
        vcoBPW = map(value, 0, 127, 0, 255);
        updatevcoBPW(1);
      } else {
        vcoBWaveBank = map(value, 0, 127, 1, BANKS);
        vcoBWaveNumber = 1;
        showCurrentParameterPage("OscB Bank", String(Tablenames[vcoBWaveBank - 1]));
        startParameterDisplay();
        updatevcoBWave(0);
      }
      break;

    case CCvcoCPW:
      if (!vcoCTable) {
        vcoCPW = map(value, 0, 127, 0, 255);
        updatevcoCPW(1);
      } else {
        vcoCWaveBank = map(value, 0, 127, 1, BANKS);
        vcoCWaveNumber = 1;
        showCurrentParameterPage("OscC Bank", String(Tablenames[vcoCWaveBank - 1]));
        startParameterDisplay();
        updatevcoCWave(0);
      }
      break;

    case CCvcoAPWM:
      vcoAPWM = map(value, 0, 127, 0, 255);
      updatevcoAPWM(1);
      break;

    case CCvcoBPWM:
      vcoBPWM = map(value, 0, 127, 0, 255);
      updatevcoBPWM(1);
      break;

    case CCvcoCPWM:
      vcoCPWM = map(value, 0, 127, 0, 255);
      updatevcoCPWM(1);
      break;

    case CCvcoAWave:
      if (!vcoATable) {
        vcoAWave = map(value, 0, 127, 0, 6);
        updatevcoAWave(1);
      } else {
        int bankIndex = vcoAWaveBank - 1;  // If your banks start at 1 instead
        int maxWaves = tablesInBank[bankIndex];
        vcoAWaveNumber = map(value, 0, 127, 1, maxWaves);
        updatevcoAWave(1);
      }
      break;

    case CCvcoBWave:
      if (!vcoBTable) {
        vcoBWave = map(value, 0, 127, 0, 6);
        updatevcoBWave(1);
      } else {
        int bankIndex = vcoBWaveBank - 1;  // If your banks start at 1 instead
        int maxWaves = tablesInBank[bankIndex];
        vcoBWaveNumber = map(value, 0, 127, 1, maxWaves);
        updatevcoBWave(1);
      }
      break;

    case CCvcoCWave:
      if (!vcoCTable) {
        vcoCWave = map(value, 0, 127, 0, 6);
        updatevcoCWave(1);
      } else {
        int bankIndex = vcoCWaveBank - 1;  // If your banks start at 1 instead
        int maxWaves = tablesInBank[bankIndex];
        vcoCWaveNumber = map(value, 0, 127, 1, maxWaves);
        updatevcoCWave(1);
      }
      break;

    case CCvcoAInterval:
      vcoAInterval = map(value, 0, 127, -12, 12);
      updatevcoAInterval(1);
      break;

    case CCvcoBInterval:
      vcoBInterval = map(value, 0, 127, -12, 12);
      updatevcoBInterval(1);
      break;

    case CCvcoCInterval:
      vcoCInterval = map(value, 0, 127, -12, 12);
      updatevcoCInterval(1);
      break;

    case CCXModDepth:
      XModDepth = map(value, 0, 127, 0, 255);
      updateXModDepth(1);
      break;

    case CCportamento:
      portamento = map(value, 0, 127, 0, 255);
      updateportamento(1);
      break;

      // Buttons

    case CCvcoATable:
      updatevcoAWave(1);
      break;

    case CCvcoBTable:
      updatevcoBWave(1);
      break;

    case CCvcoCTable:
      updatevcoCWave(1);
      break;

    case CCvcoAPWMsource:
      vcoAPWMsource = value;
      updatevcoAPWMsource(1);
      break;

    case CCvcoBPWMsource:
      vcoBPWMsource = value;
      updatevcoBPWMsource(1);
      break;

    case CCvcoCPWMsource:
      vcoCPWMsource = value;
      updatevcoCPWMsource(1);
      break;

    case CCvcoAFMsource:
      vcoAFMsource = value;
      updatevcoAFMsource(1);
      break;

    case CCvcoBFMsource:
      vcoBFMsource = value;
      updatevcoBFMsource(1);
      break;

    case CCvcoCFMsource:
      vcoCFMsource = value;
      updatevcoCFMsource(1);
      break;

    case CCvcoAOctave:
      vcoAOctave = value;
      updatevcoAOctave(1);
      break;

    case CCvcoBOctave:
      vcoBOctave = value;
      updatevcoBOctave(1);
      break;

    case CCvcoCOctave:
      vcoCOctave = value;
      updatevcoCOctave(1);
      break;

    case CCLFO1Wave:
      LFO1Wave = value;
      updateLFO1Wave(1);
      break;

    case CCLFO2Wave:
      LFO2Wave = value;
      updateLFO2Wave(1);
      break;

    case CCfilterLFODepthSW:
      updatefilterLFODepth(1);
      break;

    case CCampLFODepthSW:
      updateampLFODepth(1);
      break;

    case CCfilterEGDepthSW:
      updatefilterEGDepth(1);
      break;

    case CCnoiseLevelSW:
      updatenoiseLevel(1);
      break;

    case CCeffectsMixSW:
      updateeffectsMix(1);
      break;

    case CCeffects3SW:
      effectsPot3SW = map(value, 0, 127, 0, 1);
      updateeffectsPot3SW(1);
      break;

    case CCfilterKeyTrackZeroSW:
      updatefilterKeyTrack(1);
      break;

    case CCfilterType:
      filterType = value;
      updatefilterType(1);
      break;

    case CCfilterPoleSW:
      filterPoleSW = value;
      updatefilterPoleSwitch(1);
      break;

    case CCegInvertSW:
      egInvertSW = value;
      updateegInvertSwitch(1);
      break;

    case CCfilterKeyTrackSW:
      filterKeyTrackSW = value;
      updatefilterKeyTrackSwitch(1);
      break;

    case CCfilterVelocitySW:
      filterVelocitySW = value;
      updatefilterVelocitySwitch(1);
      break;

    case CCampVelocitySW:
      ampVelocitySW = value;
      updateampVelocitySwitch(1);
      break;

    case CCFMSyncSW:
      updateFMSyncSwitch(1);
      break;

    case CCPWSyncSW:
      updatePWSyncSwitch(1);
      break;

    case CCPWMSyncSW:
      updatePWMSyncSwitch(1);
      break;

    case CCmultiSW:
      multiSW = value;
      updatemultiSwitch(1);
      break;

    case CCeffectNumSW:
      effectNumberSW = value;
      updateeffectNumberSW(1);
      break;

    case CCeffectBankSW:
      effectBankSW = value;
      updateeffectBankSW(1);
      break;

    case CCplayModeSW:
      updateplayModeSW(1);
      break;

    case CCnotePrioritySW:
      updatenotePrioritySW(1);
      break;
  }
}

FLASHMEM void updateLFO1Rate(bool announce) {
  float hz = ui127_to_exp_hz(LFO1Rate);  // lfo1Rate: 0..127 encoder value
  LFO1.frequency(hz);                    // Teensy Audio: set LFO speed

  if (announce) {
    showCurrentParameterPage("LFO1 Rate", String(hz, 2) + " Hz");
    startParameterDisplay();
  }
}

FLASHMEM void updateLFO2Rate(bool announce) {
  float hz = ui127_to_exp_hz(LFO2Rate);  // lfo1Rate: 0..127 encoder value
  LFO2.frequency(hz);                    // Teensy Audio: set LFO speed

  if (announce) {
    showCurrentParameterPage("LFO2 Rate", String(hz, 2) + " Hz");
    startParameterDisplay();
  }
}

FLASHMEM void updateLFO1Delay(bool announce) {
  if (announce) {
    if (LFO1Delay == 0) {
      showCurrentParameterPage("LFO1 Delay", "Off");
    } else {
      showCurrentParameterPage("LFO1 Delay", LFO1Delay);
    }
    startParameterDisplay();
  }
}

FLASHMEM void updatevcoALevel(bool announce) {
  if (announce) {
    if (vcoALevel == 0) {
      showCurrentParameterPage("VCO A Level", "Off");
    } else {
      showCurrentParameterPage("VCO A Level", String(vcoALevel));
    }
    startParameterDisplay();
  }
  aLevel = vcoALevel / 255.0f;
  for (int v = 0; v < 8; v++) {
    AudioMixer4 *vm = voiceMixer(v);  // helper I gave earlier
    vm->gain(0, aLevel);
  }
}

FLASHMEM void updatevcoBLevel(bool announce) {
  if (announce) {
    if (vcoBLevel == 0) {
      showCurrentParameterPage("VCO B Level", "Off");
    } else {
      showCurrentParameterPage("VCO B Level", String(vcoBLevel));
    }
    startParameterDisplay();
  }
  bLevel = vcoBLevel / 255.0f;
  for (int v = 0; v < 8; v++) {
    AudioMixer4 *vm = voiceMixer(v);  // helper I gave earlier
    vm->gain(1, bLevel);
  }
}

FLASHMEM void updatevcoCLevel(bool announce) {
  if (announce) {
    if (vcoCLevel == 0) {
      showCurrentParameterPage("VCO C Level", "Off");
    } else {
      showCurrentParameterPage("VCO C Level", String(vcoCLevel));
    }
    startParameterDisplay();
  }
  cLevel = vcoCLevel / 255.0f;
  for (int v = 0; v < 8; v++) {
    AudioMixer4 *vm = voiceMixer(v);  // helper I gave earlier
    vm->gain(2, cLevel);
  }
}

FLASHMEM void updatepitchAttack(bool announce) {
  float ms = ui127_to_time_ms(pitchAttack);  // pitchAttack is 0..127
  if (announce) {
    showCurrentParameterPage("Pitch Attack", String(ms, 0) + " ms");
    startParameterDisplay();
  }
  // Apply to all 8 voices via your VO[] table
  for (int i = 0; i < 8; ++i) {
    VO[i].env->attack(ms);
  }
}

FLASHMEM void updatepitchDecay(bool announce) {
  float ms = ui127_to_time_ms(pitchDecay);  // pitchDecay is 0..127
  if (announce) {
    showCurrentParameterPage("Pitch Decay", String(ms, 0) + " ms");
    startParameterDisplay();
  }
  for (int i = 0; i < 8; ++i) {
    VO[i].env->decay(ms);
  }
}

FLASHMEM void updatepitchSustain(bool announce) {
  if (announce) {
    showCurrentParameterPage("Pitch Sustain", String(pitchSustain));
    startParameterDisplay();
  }
  float sus = ui100_to_sustain(pitchSustain);
  for (int v = 0; v < 8; v++) {
    VO[v].env->sustain(sus);
  }
}

FLASHMEM void updatepitchRelease(bool announce) {
  float ms = ui127_to_time_ms(pitchRelease);  // pitchRelease is 0..127
  if (announce) {
    showCurrentParameterPage("Pitch Release", String(ms, 0) + " ms");
    startParameterDisplay();
  }
  for (int i = 0; i < 8; ++i) {
    VO[i].env->release(ms);
  }
}

FLASHMEM void updatefilterAttack(bool announce) {
  float ms = ui127_to_time_ms(filterAttack);
  if (announce) {
    showCurrentParameterPage("Filter Attack", String(ms, 0) + " ms");
    startParameterDisplay();
  }
  filterattackout = (uint16_t)lroundf(filterAttack * (4095.0f / 127.0f));
  dacWriteBuffered(DAC_ADSR, DAC_E, filterattackout);
}

FLASHMEM void updatefilterDecay(bool announce) {
  float ms = ui127_to_time_ms(filterDecay);
  if (announce) {
    showCurrentParameterPage("Filter Decay", String(ms, 0) + " ms");
    startParameterDisplay();
  }
  filterdecayout = (uint16_t)lroundf(filterDecay * (4095.0f / 127.0f));
  dacWriteBuffered(DAC_ADSR, DAC_F, filterdecayout);
}

FLASHMEM void updatefilterSustain(bool announce) {
  if (announce) {
    showCurrentParameterPage("Filter Sustain", String(filterSustain));
    startParameterDisplay();
  }
  filtersustainout = (uint16_t)lroundf(filterSustain * (4095.0f / 100.0f));
  dacWriteBuffered(DAC_ADSR, DAC_G, filtersustainout);
}

FLASHMEM void updatefilterRelease(bool announce) {
  float ms = ui127_to_time_ms(filterRelease);
  if (announce) {
    showCurrentParameterPage("Filter Release", String(ms, 0) + " ms");
    startParameterDisplay();
  }
  filterreleaseout = (uint16_t)lroundf(filterRelease * (4095.0f / 127.0f));
  dacWriteBuffered(DAC_ADSR, DAC_H, filterreleaseout);
}

FLASHMEM void updateampAttack(bool announce) {
  float ms = ui127_to_time_ms(ampAttack);
  if (announce) {
    showCurrentParameterPage("Amp Attack", String(ms, 0) + " ms");
    startParameterDisplay();
  }
  ampattackout = (uint16_t)lroundf(ampAttack * (4095.0f / 127.0f));
  dacWriteBuffered(DAC_ADSR, DAC_A, ampattackout);
}

FLASHMEM void updateampDecay(bool announce) {
  float ms = ui127_to_time_ms(ampDecay);
  if (announce) {
    showCurrentParameterPage("Amp Decay", String(ms, 0) + " ms");
    startParameterDisplay();
  }
  ampdecayout = (uint16_t)lroundf(ampDecay * (4095.0f / 127.0f));
  dacWriteBuffered(DAC_ADSR, DAC_B, ampdecayout);
}

FLASHMEM void updateampSustain(bool announce) {
  if (announce) {
    showCurrentParameterPage("Amp Sustain", String(ampSustain));
    startParameterDisplay();
  }
  ampsustainout = (uint16_t)lroundf(ampSustain * (4095.0f / 100.0f));
  dacWriteBuffered(DAC_ADSR, DAC_C, ampsustainout);
}

FLASHMEM void updateampRelease(bool announce) {
  float ms = ui127_to_time_ms(ampRelease);
  if (announce) {
    showCurrentParameterPage("Amp Release", String(ms, 0) + " ms");
    startParameterDisplay();
  }
  ampreleaseout = (uint16_t)lroundf(ampRelease * (4095.0f / 127.0f));
  dacWriteBuffered(DAC_ADSR, DAC_D, ampreleaseout);
}

FLASHMEM void updateMWDepth(bool announce) {
  if (announce) {
    showCurrentParameterPage("MW Depth", String(MWDepth));
    startParameterDisplay();
  }
}

FLASHMEM void updatePBDepth(bool announce) {
  if (announce) {
    showCurrentParameterPage("PB Depth", String(PBDepth));
    startParameterDisplay();
  }
}

FLASHMEM void updateATDepth(bool announce) {
  if (announce) {
    showCurrentParameterPage("AT Depth", String(ATDepth));
    startParameterDisplay();
  }
}

FLASHMEM void updatevcoAPW(bool announce) {
  if (announce) {
    showCurrentParameterPage("VCO A PW", String(vcoAPW));
    startParameterDisplay();
  }
  aPW = ui255_to_pw(vcoAPW);
  dc_pwmAbias.amplitude(aPW);  // <- baseline PW for all A oscillators
  if (PWSyncSW) {
    dc_pwmBbias.amplitude(aPW);
    dc_pwmCbias.amplitude(aPW);
    vcoBPW = vcoAPW;
    vcoCPW = vcoAPW;
  }
}

FLASHMEM void updatevcoBPW(bool announce) {
  if (announce) {
    showCurrentParameterPage("VCO B PW", String(vcoBPW));
    startParameterDisplay();
  }
  bPW = ui255_to_pw(vcoBPW);
  dc_pwmBbias.amplitude(bPW);  // <- baseline PW for all B oscillators
}

FLASHMEM void updatevcoCPW(bool announce) {
  if (announce) {
    showCurrentParameterPage("VCO C PW", String(vcoCPW));
    startParameterDisplay();
  }
  cPW = ui255_to_pw(vcoCPW);
  dc_pwmCbias.amplitude(cPW);  // <- baseline PW for all C oscillators
}

FLASHMEM void updatevcoAPWM(bool announce) {
  if (announce) {
    showCurrentParameterPage("VCO A PWM", vcoAPWM ? String(vcoAPWM) : "Off");
    startParameterDisplay();
  }
  aPWM = ui255_to_01(vcoAPWM);
  const float lfoGain = 0.5f * aPWM;
  switch (vcoAPWMsource) {
    case 1:
      for (int v = 1; v <= VOICES; ++v) pwmA[v]->gain(0, lfoGain);  // input 0 = LFO2
      if (PWMSyncSW) {
        for (int v = 1; v <= VOICES; ++v) pwmB[v]->gain(0, lfoGain);  // input 0 = LFO2
        for (int v = 1; v <= VOICES; ++v) pwmC[v]->gain(0, lfoGain);  // input 0 = LFO2
        vcoBPWM = vcoAPWM;
        vcoCPWM = vcoAPWM;
      }
      break;

    case 2:
      for (int v = 1; v <= VOICES; ++v) pwmA[v]->gain(1, lfoGain);  // input 1 = env1
      if (PWMSyncSW) {
        for (int v = 1; v <= VOICES; ++v) pwmB[v]->gain(1, lfoGain);  // input 0 = LFO2
        for (int v = 1; v <= VOICES; ++v) pwmC[v]->gain(1, lfoGain);  // input 0 = LFO2
        vcoBPWM = vcoAPWM;
        vcoCPWM = vcoAPWM;
      }
      break;

    case 3:
      for (int v = 1; v <= VOICES; ++v) pwmA[v]->gain(2, lfoGain);  // input 2 = inv env1
      if (PWMSyncSW) {
        for (int v = 1; v <= VOICES; ++v) pwmB[v]->gain(2, lfoGain);  // input 0 = LFO2
        for (int v = 1; v <= VOICES; ++v) pwmC[v]->gain(2, lfoGain);  // input 0 = LFO2
        vcoBPWM = vcoAPWM;
        vcoCPWM = vcoAPWM;
      }
      break;
  }
}

FLASHMEM void updatevcoBPWM(bool announce) {
  if (announce) {
    showCurrentParameterPage("VCO B PWM", vcoBPWM ? String(vcoBPWM) : "Off");
    startParameterDisplay();
  }
  bPWM = ui255_to_01(vcoBPWM);
  const float lfoGain = 0.5f * bPWM;
  switch (vcoBPWMsource) {
    case 1:
      for (int v = 1; v <= VOICES; ++v) pwmB[v]->gain(0, lfoGain);  // input 0 = LFO2
      break;

    case 2:
      for (int v = 1; v <= VOICES; ++v) pwmB[v]->gain(1, lfoGain);  // input 1 = env1
      break;

    case 3:
      for (int v = 1; v <= VOICES; ++v) pwmB[v]->gain(2, lfoGain);  // input 2 = inv env1
      break;
  }
}

FLASHMEM void updatevcoCPWM(bool announce) {
  if (announce) {
    showCurrentParameterPage("VCO C PWM", vcoCPWM ? String(vcoCPWM) : "Off");
    startParameterDisplay();
  }
  cPWM = ui255_to_01(vcoCPWM);
  const float lfoGain = 0.5f * cPWM;
  switch (vcoCPWMsource) {
    case 1:
      for (int v = 1; v <= VOICES; ++v) pwmC[v]->gain(0, lfoGain);  // input 0 = LFO2
      break;

    case 2:
      for (int v = 1; v <= VOICES; ++v) pwmC[v]->gain(1, lfoGain);  // input 1 = env1
      break;

    case 3:
      for (int v = 1; v <= VOICES; ++v) pwmC[v]->gain(2, lfoGain);  // input 2 = inv env1
      break;
  }
}

FLASHMEM void updateXModDepth(bool announce) {
  if (announce) {
    showCurrentParameterPage("XMOD Depth", XModDepth ? String(XModDepth) : "Off");
    startParameterDisplay();
  }
  bXModDepth = XModDepth / 255.0f;
  for (int v = 1; v <= VOICES; ++v) pitchA[v]->gain(3, bXModDepth);  // input 3 = oscB output
}

FLASHMEM void updateportamento(bool announce) {
  // if (announce) {
  //   showCurrentParameterPage("Portamento", portamento ? String(portamento) : "Off");
  //   startParameterDisplay();
  // }
  updateGlideFromPot(portamento, announce);
}

FLASHMEM void updatevcoAInterval(bool announce) {
  if (announce) {
    showCurrentParameterPage("VCO A Int", String(vcoAInterval));
    startParameterDisplay();
  }
  pitchDirty = true;
}

FLASHMEM void updatevcoBInterval(bool announce) {
  if (announce) {
    showCurrentParameterPage("VCO B Int", String(vcoBInterval));
    startParameterDisplay();
  }
  pitchDirty = true;
}

FLASHMEM void updatevcoCInterval(bool announce) {
  if (announce) {
    showCurrentParameterPage("VCO C Int", String(vcoCInterval));
    startParameterDisplay();
  }
  pitchDirty = true;
}

FLASHMEM void updatevcoAFMDepth(bool announce) {
  if (announce) {
    if (vcoAFMDepth == 0) {
      showCurrentParameterPage("A FM Depth", "Off");
    } else {
      showCurrentParameterPage("A FM Depth", String(vcoAFMDepth));
    }
    startParameterDisplay();
  }
  aFMDepth = vcoAFMDepth / 511.0f;
  switch (vcoAFMsource) {
    case 1:
      for (int v = 1; v <= VOICES; ++v) pitchA[v]->gain(0, aFMDepth);  // input 0 = LFO1
      if (FMSyncSW) {
        for (int v = 1; v <= VOICES; ++v) pitchB[v]->gain(0, aFMDepth);  // input 0 = LFO1
        for (int v = 1; v <= VOICES; ++v) pitchC[v]->gain(0, aFMDepth);  // input 0 = LFO1
        vcoBFMDepth = vcoAFMDepth;
        vcoCFMDepth = vcoAFMDepth;
      }
      break;

    case 2:
      for (int v = 1; v <= VOICES; ++v) pitchA[v]->gain(1, aFMDepth);  // input 1 = env1
      if (FMSyncSW) {
        for (int v = 1; v <= VOICES; ++v) pitchB[v]->gain(1, aFMDepth);  // input 1 = env1
        for (int v = 1; v <= VOICES; ++v) pitchC[v]->gain(1, aFMDepth);  // input 1 = env1
        vcoBFMDepth = vcoAFMDepth;
        vcoCFMDepth = vcoAFMDepth;
      }
      break;

    case 3:
      for (int v = 1; v <= VOICES; ++v) pitchA[v]->gain(2, aFMDepth);  // input 2 = inv env1
      if (FMSyncSW) {
        for (int v = 1; v <= VOICES; ++v) pitchB[v]->gain(2, aFMDepth);  // input 2 = inv env1
        for (int v = 1; v <= VOICES; ++v) pitchC[v]->gain(2, aFMDepth);  // input 2 = inv env1
        vcoBFMDepth = vcoAFMDepth;
        vcoCFMDepth = vcoAFMDepth;
      }
      break;
  }
}

FLASHMEM void updatevcoBFMDepth(bool announce) {
  if (announce) {
    if (vcoBFMDepth == 0) {
      showCurrentParameterPage("B FM Depth", "Off");
    } else {
      showCurrentParameterPage("B FM Depth", String(vcoBFMDepth));
    }
    startParameterDisplay();
  }
  bFMDepth = vcoBFMDepth / 511.0f;
  switch (vcoBFMsource) {
    case 1:
      for (int v = 1; v <= VOICES; ++v) pitchB[v]->gain(0, bFMDepth);  // input 0 = LFO1
      break;

    case 2:
      for (int v = 1; v <= VOICES; ++v) pitchB[v]->gain(1, bFMDepth);  // input 1 = env1
      break;

    case 3:
      for (int v = 1; v <= VOICES; ++v) pitchB[v]->gain(2, bFMDepth);  // input 2 = inv env1
      break;
  }
}

FLASHMEM void updatevcoCFMDepth(bool announce) {
  if (announce) {
    if (vcoCFMDepth == 0) {
      showCurrentParameterPage("C FM Depth", "Off");
    } else {
      showCurrentParameterPage("C FM Depth", String(vcoCFMDepth));
    }
    startParameterDisplay();
  }
  cFMDepth = vcoCFMDepth / 511.0f;
  switch (vcoCFMsource) {
    case 1:
      for (int v = 1; v <= VOICES; ++v) pitchC[v]->gain(0, cFMDepth);  // input 0 = LFO1
      break;

    case 2:
      for (int v = 1; v <= VOICES; ++v) pitchC[v]->gain(1, cFMDepth);  // input 1 = env1
      break;

    case 3:
      for (int v = 1; v <= VOICES; ++v) pitchC[v]->gain(2, cFMDepth);  // input 2 = inv env1
      break;
  }
}

FLASHMEM void updatevcoBDetune(bool announce) {
  if (announce) {
    int displayVal = vcoBDetune - 64;  // Center at 0
    showCurrentParameterPage("VCO B Detune", String(displayVal));
    startParameterDisplay();
  }
  pitchDirty = true;
  bDetune = 1.0f + ((vcoBDetune - 64) / 64.0f) * 0.05f;
}

FLASHMEM void updatevcoCDetune(bool announce) {
  if (announce) {
    int displayVal = vcoCDetune - 64;  // Center at 0
    showCurrentParameterPage("VCO C Detune", String(displayVal));
    startParameterDisplay();
  }
  pitchDirty = true;
  cDetune = 1.0f + ((vcoCDetune - 64) / 64.0f) * 0.05f;
}

FLASHMEM void updatevcoAWave(bool announce) {
  if (!vcoATable) {
    if (announce) {
      switch (vcoAWave) {
        case 0:
          showCurrentParameterPage("VCO A Wave", "Sine");
          break;
        case 1:
          showCurrentParameterPage("VCO A Wave", "Saw");
          break;
        case 2:
          showCurrentParameterPage("VCO A Wave", "Reverse Saw");
          break;
        case 3:
          showCurrentParameterPage("VCO A Wave", "Square");
          break;
        case 4:
          showCurrentParameterPage("VCO A Wave", "Triangle");
          break;
        case 5:
          showCurrentParameterPage("VCO A Wave", "Pulse");
          break;
        case 6:
          showCurrentParameterPage("VCO A Wave", "S & H");
          break;
      }
      startParameterDisplay();
    }
    switch (vcoAWave) {
      case 0:
        for (int v = 1; v < 9; v++) {
          dcoA[v]->begin(WAVEFORM_SINE);
        }
        break;
      case 1:
        for (int v = 1; v < 9; v++) {
          dcoA[v]->begin(WAVEFORM_BANDLIMIT_SAWTOOTH);
        }
        break;
      case 2:
        for (int v = 1; v < 9; v++) {
          dcoA[v]->begin(WAVEFORM_BANDLIMIT_SAWTOOTH_REVERSE);
        }
        break;
      case 3:
        for (int v = 1; v < 9; v++) {
          dcoA[v]->begin(WAVEFORM_BANDLIMIT_SQUARE);
        }
        break;
      case 4:
        for (int v = 1; v < 9; v++) {
          dcoA[v]->begin(WAVEFORM_TRIANGLE_VARIABLE);
        }
        break;
      case 5:
        for (int v = 1; v < 9; v++) {
          dcoA[v]->begin(WAVEFORM_BANDLIMIT_PULSE);
        }
        break;
      case 6:
        for (int v = 1; v < 9; v++) {
          dcoA[v]->begin(WAVEFORM_SAMPLE_HOLD);
        }
        break;
    }
  } else if (vcoATable) {

    if (vcoAWaveBank < 1) {
      vcoAWaveBank = 1;
    }
    if (vcoAWaveNumber < 1) {
      vcoAWaveNumber = 1;
    }

    if (announce) {
      char displayText[32];
      snprintf(displayText, sizeof(displayText), "%s %d", Tablenames[vcoAWaveBank - 1], vcoAWaveNumber);
      showCurrentParameterPage("OscA W.Table", String(displayText));
      startParameterDisplay();
    }

    int bank = vcoAWaveBank - 1;     // folders bank00..bank62
    int table = vcoAWaveNumber - 1;  // files 00.bin..NN.bin

    int16_t *wavePtrA = wavetablePSRAM[bank][table];

    for (int v = 1; v < 9; v++) {
      dcoA[v]->begin(WAVEFORM_ARBITRARY);
      dcoA[v]->arbitraryWaveform(wavePtrA, 2000);
    }
  }
}

FLASHMEM void updatevcoBWave(bool announce) {
  if (!vcoBTable) {
    if (announce) {
      switch (vcoBWave) {
        case 0:
          showCurrentParameterPage("VCO B Wave", "Sine");
          break;
        case 1:
          showCurrentParameterPage("VCO B Wave", "Saw");
          break;
        case 2:
          showCurrentParameterPage("VCO B Wave", "Reverse Saw");
          break;
        case 3:
          showCurrentParameterPage("VCO B Wave", "Square");
          break;
        case 4:
          showCurrentParameterPage("VCO B Wave", "Triangle");
          break;
        case 5:
          showCurrentParameterPage("VCO B Wave", "Pulse");
          break;
        case 6:
          showCurrentParameterPage("VCO B Wave", "S & H");
          break;
      }
      startParameterDisplay();
    }
    switch (vcoBWave) {
      case 0:
        for (int v = 1; v < 9; v++) {
          dcoB[v]->begin(WAVEFORM_SINE);
        }
        break;
      case 1:
        for (int v = 1; v < 9; v++) {
          dcoB[v]->begin(WAVEFORM_BANDLIMIT_SAWTOOTH);
        }
        break;
      case 2:
        for (int v = 1; v < 9; v++) {
          dcoB[v]->begin(WAVEFORM_BANDLIMIT_SAWTOOTH_REVERSE);
        }
        break;
      case 3:
        for (int v = 1; v < 9; v++) {
          dcoB[v]->begin(WAVEFORM_BANDLIMIT_SQUARE);
        }
        break;
      case 4:
        for (int v = 1; v < 9; v++) {
          dcoB[v]->begin(WAVEFORM_TRIANGLE_VARIABLE);
        }
        break;
      case 5:
        for (int v = 1; v < 9; v++) {
          dcoB[v]->begin(WAVEFORM_BANDLIMIT_PULSE);
        }
        break;
      case 6:
        for (int v = 1; v < 9; v++) {
          dcoB[v]->begin(WAVEFORM_SAMPLE_HOLD);
        }
        break;
    }
  } else if (vcoBTable) {

    if (vcoBWaveBank < 1) {
      vcoBWaveBank = 1;
    }
    if (vcoBWaveNumber < 1) {
      vcoBWaveNumber = 1;
    }
    if (announce) {
      char displayText[32];
      snprintf(displayText, sizeof(displayText), "%s %d", Tablenames[vcoBWaveBank - 1], vcoBWaveNumber);
      showCurrentParameterPage("OscB W.Table", String(displayText));
      startParameterDisplay();
    }

    int bank = vcoBWaveBank - 1;     // folders bank00..bank62
    int table = vcoBWaveNumber - 1;  // files 00.bin..NN.bin

    int16_t *wavePtrB = wavetablePSRAM[bank][table];

    for (int v = 1; v < 9; v++) {
      dcoB[v]->begin(WAVEFORM_ARBITRARY);
      dcoB[v]->arbitraryWaveform(wavePtrB, 2000);
    }
  }
}

FLASHMEM void updatevcoCWave(bool announce) {
  if (!vcoCTable) {
    if (announce) {
      switch (vcoCWave) {
        case 0:
          showCurrentParameterPage("VCO C Wave", "Sine");
          break;
        case 1:
          showCurrentParameterPage("VCO C Wave", "Saw");
          break;
        case 2:
          showCurrentParameterPage("VCO C Wave", "Reverse Saw");
          break;
        case 3:
          showCurrentParameterPage("VCO C Wave", "Square");
          break;
        case 4:
          showCurrentParameterPage("VCO C Wave", "Triangle");
          break;
        case 5:
          showCurrentParameterPage("VCO C Wave", "Pulse");
          break;
        case 6:
          showCurrentParameterPage("VCO C Wave", "S & H");
          break;
      }
      startParameterDisplay();
    }
    switch (vcoCWave) {
      case 0:
        for (int v = 1; v < 9; v++) {
          dcoC[v]->begin(WAVEFORM_SINE);
        }
        break;
      case 1:
        for (int v = 1; v < 9; v++) {
          dcoC[v]->begin(WAVEFORM_BANDLIMIT_SAWTOOTH);
        }
        break;
      case 2:
        for (int v = 1; v < 9; v++) {
          dcoC[v]->begin(WAVEFORM_BANDLIMIT_SAWTOOTH_REVERSE);
        }
        break;
      case 3:
        for (int v = 1; v < 9; v++) {
          dcoC[v]->begin(WAVEFORM_BANDLIMIT_SQUARE);
        }
        break;
      case 4:
        for (int v = 1; v < 9; v++) {
          dcoC[v]->begin(WAVEFORM_TRIANGLE_VARIABLE);
        }
        break;
      case 5:
        for (int v = 1; v < 9; v++) {
          dcoC[v]->begin(WAVEFORM_BANDLIMIT_PULSE);
        }
        break;
      case 6:
        for (int v = 1; v < 9; v++) {
          dcoC[v]->begin(WAVEFORM_SAMPLE_HOLD);
        }
        break;
    }
  } else if (vcoCTable) {

    if (vcoCWaveBank < 1) {
      vcoCWaveBank = 1;
    }
    if (vcoCWaveNumber < 1) {
      vcoCWaveNumber = 1;
    }

    if (announce) {
      char displayText[32];
      snprintf(displayText, sizeof(displayText), "%s %d", Tablenames[vcoCWaveBank - 1], vcoCWaveNumber);
      showCurrentParameterPage("OscC W.Table", String(displayText));
      startParameterDisplay();
    }

    int bank = vcoCWaveBank - 1;     // folders bank00..bank62
    int table = vcoCWaveNumber - 1;  // files 00.bin..NN.bin

    int16_t *wavePtrC = wavetablePSRAM[bank][table];

    for (int v = 1; v < 9; v++) {
      dcoC[v]->begin(WAVEFORM_ARBITRARY);
      dcoC[v]->arbitraryWaveform(wavePtrC, 2000);
    }
  }
}

FLASHMEM void updatefilterCutoff(bool announce) {
  if (announce) {
    showCurrentParameterPage("VCF Cutoff", String(filterCutoff));
    startParameterDisplay();
  }
}

FLASHMEM void updatefilterResonance(bool announce) {
  if (announce) {
    showCurrentParameterPage("VCF Res", String(filterResonance));
    startParameterDisplay();
  }
  uint16_t resout = (uint16_t)lroundf(filterResonance * (4095.0f / 255.0f));
  dacWriteBuffered(DAC_GLOBAL, DAC_A, resout);
}

FLASHMEM void updatefilterEGDepth(bool announce) {
  if (announce) {
    showCurrentParameterPage("VCF EG Depth", String(filterEGDepth));
    startParameterDisplay();
  }
  uint16_t egout = (uint16_t)lroundf(filterEGDepth * (4095.0f / 255.0f));
  dacWriteBuffered(DAC_GLOBAL, DAC_H, egout);
}

FLASHMEM void updatefilterKeyTrack(bool announce) {
  if (announce) {
    if (filterKeyTrack == 0) {
      showCurrentParameterPage("Filter Keytrack", "Off");
    } else if (filterKeyTrack < 0) {
      float positive_filterKeyTrack = abs(filterKeyTrack);
      showCurrentParameterPage("Filter Keytrack", "- " + String(positive_filterKeyTrack));
    } else {
      showCurrentParameterPage("Filter Keytrack", "+ " + String(filterKeyTrack));
    }
    startParameterDisplay();
  }
}

FLASHMEM void updatefilterLFODepth(bool announce) {
  if (announce) {
    if (filterLFODepth == 0) {
      showCurrentParameterPage("LFO Depth", "Off");
    } else if (filterLFODepth < 0) {
      float positive_filterLFODepth = abs(filterLFODepth);
      showCurrentParameterPage("LFO1 Depth", String(positive_filterLFODepth));
    } else {
      showCurrentParameterPage("LFO2 Depth", String(filterLFODepth));
    }
    startParameterDisplay();
  }
}

FLASHMEM void updateeffectPot1(bool announce) {
  if (announce) {
    char buf3[30];
    switch (effectBankSW) {
      case 0:
        str_ptr = reinterpret_cast<const char *>(pgm_read_ptr(&(name03[effectNumberSW])));
        break;
      case 1:
        str_ptr = reinterpret_cast<const char *>(pgm_read_ptr(&(name13[effectNumberSW])));
        break;
      case 2:
        str_ptr = reinterpret_cast<const char *>(pgm_read_ptr(&(name23[effectNumberSW])));
        break;
      case 3:
        str_ptr = reinterpret_cast<const char *>(pgm_read_ptr(&(name33[effectNumberSW])));
        break;
    }

    // Check if the pointer is valid
    if (str_ptr != nullptr) {
      // Copy the string from program memory to RAM
      strcpy_P(buf3, str_ptr);
    } else {
      // Handle the case where the pointer is NULL (if needed)
    }
    showCurrentParameterPage(buf3, String(effectPot1));
    startParameterDisplay();
  }

  uint16_t codeP1 = scale_to_dac(effectPot1, 3.3f);  // max 3.3V
  dacWriteBuffered(DAC_GLOBAL, DAC_B, codeP1);
}

FLASHMEM void updateeffectPot2(bool announce) {
  if (announce) {
    char buf4[30];
    switch (effectBankSW) {
      case 0:
        str_ptr = reinterpret_cast<const char *>(pgm_read_ptr(&(name04[effectNumberSW])));
        break;
      case 1:
        str_ptr = reinterpret_cast<const char *>(pgm_read_ptr(&(name14[effectNumberSW])));
        break;
      case 2:
        str_ptr = reinterpret_cast<const char *>(pgm_read_ptr(&(name24[effectNumberSW])));
        break;
      case 3:
        str_ptr = reinterpret_cast<const char *>(pgm_read_ptr(&(name34[effectNumberSW])));
        break;
    }
    // Check if the pointer is valid
    if (str_ptr != nullptr) {
      // Copy the string from program memory to RAM
      strcpy_P(buf4, str_ptr);
    } else {
      // Handle the case where the pointer is NULL (if needed)
    }
    showCurrentParameterPage(buf4, String(effectPot2));
    startParameterDisplay();
  }
  uint16_t codeP2 = scale_to_dac(effectPot2, 3.3f);  // max 3.3V
  dacWriteBuffered(DAC_GLOBAL, DAC_C, codeP2);
}

FLASHMEM void updateeffectPot3(bool announce) {
  oldeffectPot3 = effectPot3;
  if (announce) {
    char buf5[30];
    switch (effectBankSW) {
      case 0:
        str_ptr = reinterpret_cast<const char *>(pgm_read_ptr(&(name05[effectNumberSW])));
        break;
      case 1:
        str_ptr = reinterpret_cast<const char *>(pgm_read_ptr(&(name15[effectNumberSW])));
        break;
      case 2:
        str_ptr = reinterpret_cast<const char *>(pgm_read_ptr(&(name25[effectNumberSW])));
        break;
      case 3:
        str_ptr = reinterpret_cast<const char *>(pgm_read_ptr(&(name35[effectNumberSW])));
        break;
    }
    // Check if the pointer is valid
    if (str_ptr != nullptr) {
      // Copy the string from program memory to RAM
      strcpy_P(buf5, str_ptr);
    } else {
      // Handle the case where the pointer is NULL (if needed)
    }
    showCurrentParameterPage(buf5, String(effectPot3));
    startParameterDisplay();
  }
  uint16_t codeP3 = scale_to_dac(effectPot3, 3.3f);  // max 3.3V
  dacWriteBuffered(DAC_GLOBAL, DAC_D, codeP3);
}

FLASHMEM void updateeffectsMix(bool announce) {
  if (announce) {
    if (effectsMix == 0) {
      showCurrentParameterPage("Effects Mix", "50/50");
    } else if (effectsMix < 0) {
      float positive_effectsMix = abs(effectsMix);
      showCurrentParameterPage("Effects Dry", String(positive_effectsMix));
    } else {
      showCurrentParameterPage("Effects Wet", String(effectsMix));
    }
    startParameterDisplay();
  }
  // Wet/Dry crossfade 0..2 V each
  float x = effectsMix / 127.0f;
  if (x < -1) x = -1;
  if (x > 1) x = 1;
  const float wet01 = 0.5f * (x + 1.0f);
  //const float dry01 = 1.0f - wet01;
  const uint16_t codeWet = code12_for_vmax(wet01, 2.0f);
  //const uint16_t codeDry = code12_for_vmax(dry01, 2.0f);
  dacWriteBuffered(DAC_GLOBAL, DAC_E, codeWet);
}

void updateeffectsPot3SW(bool announce) {
  // Ignore trigger if already mid-move
  if (fast || slow) {
    effectsPot3SW = false;  // clear trigger so it doesn't fire again
    return;
  }

  if (effectsPot3SW) {  // Triggered by footswitch press
    showCurrentParameterPage("Foot Switch", "Pressed");
    startParameterDisplay();

    if (!pot3ToggleState) {
      if (effectPot3 < 127) {
        slowpot3 = effectPot3;
        fast = true;
        slow = false;
      } else {
        fastpot3 = effectPot3;
        slow = true;
        fast = false;
      }
    } else {
      if (effectPot3 < 127) {
        fast = true;
        slow = false;
      } else {
        slow = true;
        fast = false;
      }
    }

    pot3ToggleState = !pot3ToggleState;
    effectsPot3SW = false;
  }
}

void changeSpeed() {
  if (slow) {
    effectPot3--;
    if (effectPot3 <= slowpot3) {
      slow = false;
    }
  }

  if (fast) {
    effectPot3++;
    if (effectPot3 >= fastpot3) {
      fast = false;
    }
  }

  if (oldeffectPot3 != effectPot3) {
    updateeffectPot3(1);
  }
}

FLASHMEM void updateeffectNumberSW(bool announce) {
  if (announce) {
    char buf1[30];  // first word of effect name
    switch (effectBankSW) {
      case 0:
        str_ptr = reinterpret_cast<const char *>(pgm_read_ptr(&(name01[effectNumberSW])));
        break;
      case 1:
        str_ptr = reinterpret_cast<const char *>(pgm_read_ptr(&(name11[effectNumberSW])));
        break;
      case 2:
        str_ptr = reinterpret_cast<const char *>(pgm_read_ptr(&(name21[effectNumberSW])));
        break;
      case 3:
        str_ptr = reinterpret_cast<const char *>(pgm_read_ptr(&(name31[effectNumberSW])));
        break;
    }
    // Check if the pointer is valid
    if (str_ptr != nullptr) {
      // Copy the string from program memory to RAM
      strcpy_P(buf1, str_ptr);
    } else {
      // Handle the case where the pointer is NULL (if needed)
    }
    char buf2[30];  // second word of effect name
    switch (effectBankSW) {
      case 0:
        str_ptr = reinterpret_cast<const char *>(pgm_read_ptr(&(name02[effectNumberSW])));
        break;
      case 1:
        str_ptr = reinterpret_cast<const char *>(pgm_read_ptr(&(name12[effectNumberSW])));
        break;
      case 2:
        str_ptr = reinterpret_cast<const char *>(pgm_read_ptr(&(name22[effectNumberSW])));
        break;
      case 3:
        str_ptr = reinterpret_cast<const char *>(pgm_read_ptr(&(name32[effectNumberSW])));
        break;
    }
    // Check if the pointer is valid
    if (str_ptr != nullptr) {
      strcpy_P(buf2, str_ptr);

      char fxPos[8];
      snprintf(fxPos, sizeof(fxPos), "B%u-%u", effectBankSW + 1, effectNumberSW + 1);

      int len = strlen(buf2);
      int fxLen = strlen(fxPos);

      // Ensure total line is exactly 13 characters
      int pad = 13 - fxLen - len;
      if (pad < 1) pad = 1;  // At least 1 space

      // Add padding spaces
      for (int i = 0; i < pad; i++) {
        buf2[len + i] = ' ';
      }
      buf2[len + pad] = '\0';

      // Append X-Y tag
      strcat(buf2, fxPos);
    } else {
      // Handle the case where the pointer is NULL (if needed)
    }
    showCurrentParameterPage(buf1, buf2);
    startParameterDisplay();
  }
  if (effectNumberSW == 0) {
    srp.writePin(EFFECT_0, LOW);
    srp.writePin(EFFECT_1, LOW);
    srp.writePin(EFFECT_2, LOW);
    midiCCOut(CCeffectNumSW, 0);

  } else if (effectNumberSW == 1) {
    srp.writePin(EFFECT_0, HIGH);
    srp.writePin(EFFECT_1, LOW);
    srp.writePin(EFFECT_2, LOW);
    midiCCOut(CCeffectNumSW, 1);

  } else if (effectNumberSW == 2) {
    srp.writePin(EFFECT_0, LOW);
    srp.writePin(EFFECT_1, HIGH);
    srp.writePin(EFFECT_2, LOW);
    midiCCOut(CCeffectNumSW, 2);

  } else if (effectNumberSW == 3) {
    srp.writePin(EFFECT_0, HIGH);
    srp.writePin(EFFECT_1, HIGH);
    srp.writePin(EFFECT_2, LOW);
    midiCCOut(CCeffectNumSW, 3);

  } else if (effectNumberSW == 4) {
    srp.writePin(EFFECT_0, LOW);
    srp.writePin(EFFECT_1, LOW);
    srp.writePin(EFFECT_2, HIGH);
    midiCCOut(CCeffectNumSW, 4);

  } else if (effectNumberSW == 5) {
    srp.writePin(EFFECT_0, HIGH);
    srp.writePin(EFFECT_1, LOW);
    srp.writePin(EFFECT_2, HIGH);
    midiCCOut(CCeffectNumSW, 5);

  } else if (effectNumberSW == 6) {
    srp.writePin(EFFECT_0, LOW);
    srp.writePin(EFFECT_1, HIGH);
    srp.writePin(EFFECT_2, HIGH);
    midiCCOut(CCeffectNumSW, 6);

  } else if (effectNumberSW == 7) {
    srp.writePin(EFFECT_0, HIGH);
    srp.writePin(EFFECT_1, HIGH);
    srp.writePin(EFFECT_2, HIGH);
    midiCCOut(CCeffectNumSW, 7);
  }
}

FLASHMEM void updateeffectBankSW(bool announce) {

  if (announce) {
    char buf1[30];  // first word of effect name
    switch (effectBankSW) {
      case 0:
        str_ptr = reinterpret_cast<const char *>(pgm_read_ptr(&(name01[effectNumberSW])));
        break;
      case 1:
        str_ptr = reinterpret_cast<const char *>(pgm_read_ptr(&(name11[effectNumberSW])));
        break;
      case 2:
        str_ptr = reinterpret_cast<const char *>(pgm_read_ptr(&(name21[effectNumberSW])));
        break;
      case 3:
        str_ptr = reinterpret_cast<const char *>(pgm_read_ptr(&(name31[effectNumberSW])));
        break;
    }
    // Check if the pointer is valid
    if (str_ptr != nullptr) {
      // Copy the string from program memory to RAM
      strcpy_P(buf1, str_ptr);
    } else {
      // Handle the case where the pointer is NULL (if needed)
    }
    char buf2[30];  // second word of effect name
    switch (effectBankSW) {
      case 0:
        str_ptr = reinterpret_cast<const char *>(pgm_read_ptr(&(name02[effectNumberSW])));
        break;
      case 1:
        str_ptr = reinterpret_cast<const char *>(pgm_read_ptr(&(name12[effectNumberSW])));
        break;
      case 2:
        str_ptr = reinterpret_cast<const char *>(pgm_read_ptr(&(name22[effectNumberSW])));
        break;
      case 3:
        str_ptr = reinterpret_cast<const char *>(pgm_read_ptr(&(name32[effectNumberSW])));
        break;
    }
    // Check if the pointer is valid
    if (str_ptr != nullptr) {
      strcpy_P(buf2, str_ptr);

      char fxPos[8];
      snprintf(fxPos, sizeof(fxPos), "B%u-%u", effectBankSW + 1, effectNumberSW + 1);

      int len = strlen(buf2);
      int fxLen = strlen(fxPos);

      // Ensure total line is exactly 13 characters
      int pad = 13 - fxLen - len;
      if (pad < 1) pad = 1;  // At least 1 space

      // Add padding spaces
      for (int i = 0; i < pad; i++) {
        buf2[len + i] = ' ';
      }
      buf2[len + pad] = '\0';

      // Append X-Y tag
      strcat(buf2, fxPos);
    } else {
      // Handle the case where the pointer is NULL (if needed)
    }
    showCurrentParameterPage(buf1, buf2);
    startParameterDisplay();
  }

  // Step 1: Enter external mode
  srp.writePin(EFFECT_INTERNAL, HIGH);

  // Step 2: Reset all CS lines
  srp.writePin(EFFECT_BANK_1, HIGH);
  srp.writePin(EFFECT_BANK_2, HIGH);
  srp.writePin(EFFECT_BANK_3, HIGH);
  srp.update();

  if (effectBankSW == 0) {
    // Internal ROM selected
    srp.writePin(EFFECT_INTERNAL, LOW);
    srp.update();
  } else {
    // Select only the chosen EEPROM
    if (effectBankSW == 1) srp.writePin(EFFECT_BANK_1, LOW);
    else if (effectBankSW == 2) srp.writePin(EFFECT_BANK_2, LOW);
    else if (effectBankSW == 3) srp.writePin(EFFECT_BANK_3, LOW);

    srp.update();  // or srp.latch(), or whatever your library uses
    srp.writePin(EFFECT_INTERNAL, LOW);
    srp.update();
    srp.writePin(EFFECT_INTERNAL, HIGH);
    srp.update();
  }
  // Send MIDI
  midiCCOut(CCeffectBankSW, effectBankSW);
}

FLASHMEM void updatevolumeLevel(bool announce) {
  if (announce) {
    showCurrentParameterPage("Volume", String(volumeLevel));
    startParameterDisplay();
  }

  // Limit volume CV to 0–2 V
  uint16_t codeVol = scale_to_dac(volumeLevel, 2.0f);
  dacWriteBuffered(DAC_GLOBAL, DAC_G, codeVol);
}

FLASHMEM void updatenoiseLevel(bool announce) {
  if (announce) {
    if (noiseLevel == 0) {
      showCurrentParameterPage("Noise Level", "Off");
    } else if (noiseLevel < 0) {
      float positive_noiseLevel = abs(noiseLevel);
      showCurrentParameterPage("Pink Level", String(positive_noiseLevel));
    } else {
      showCurrentParameterPage("White Level", String(noiseLevel));
    }
    startParameterDisplay();
  }
  // magnitude 0..1 from |−127..+127|
  const float mag = fabsf((float)noiseLevel) / 127.0f;

  // select source into noiseMix (0=white, 1=pink)
  // We keep source at unity and use per-voice gain as the overall level.
  noiseMix.gain(0, (noiseLevel > 0) ? 1.0f : 0.0f);  // white
  noiseMix.gain(1, (noiseLevel < 0) ? 1.0f : 0.0f);  // pink
  // (If you ever want crossfade instead of either/or, set both to
  // fractions that sum to 1, and reduce per-voice mag accordingly.)

  // push noise amount into each voice’s mixer input 3
  for (int v = 0; v < 8; v++) {
    AudioMixer4 *vm = voiceMixer(v);  // your helper that returns &voiceMixN
    vm->gain(3, mag);                 // input 3 is noise
  }
}

FLASHMEM void updateampLFODepth(bool announce) {
  if (announce) {
    if (ampLFODepth == 0) {
      showCurrentParameterPage("LFO Depth", "Off");
    } else if (ampLFODepth < 0) {
      float positive_ampLFODepth = abs(ampLFODepth);
      showCurrentParameterPage("LFO1 Depth", String(positive_ampLFODepth));
    } else {
      showCurrentParameterPage("LFO2 Depth", String(ampLFODepth));
    }
    startParameterDisplay();
  }
}

FLASHMEM void updatefilterPoleSwitch(bool announce) {
  if (filterPoleSW == 1) {
    if (announce) {
      updatefilterType(1);
    }
    midiCCOut(CCfilterPoleSW, 127);
    srp.writePin(FILTER_POLE, HIGH);
    mcp4.digitalWrite(FILTER_POLE_RED, HIGH);
  } else {
    if (announce) {
      updatefilterType(1);
    }
    midiCCOut(CCfilterPoleSW, 0);
    srp.writePin(FILTER_POLE, LOW);
    mcp4.digitalWrite(FILTER_POLE_RED, LOW);
  }
}

FLASHMEM void updateegInvertSwitch(bool announce) {
  if (egInvertSW == 1) {
    if (announce) {
      showCurrentParameterPage("EG Type", "Negative");
      startParameterDisplay();
    }
    midiCCOut(CCegInvertSW, 127);
    srp.writePin(EG_INVERT, HIGH);
    mcp3.digitalWrite(EG_INVERT_LED, HIGH);
  } else {
    if (announce) {
      showCurrentParameterPage("EG Type", "Positive");
      startParameterDisplay();
    }
    midiCCOut(CCegInvertSW, 0);
    srp.writePin(EG_INVERT, LOW);
    mcp3.digitalWrite(EG_INVERT_LED, LOW);
  }
}

FLASHMEM void updatefilterKeyTrackSwitch(bool announce) {
  if (filterKeyTrackSW == 1) {
    if (announce) {
      showCurrentParameterPage("Key Track", "On");
      startParameterDisplay();
    }
    midiCCOut(CCfilterKeyTrackSW, 127);
    mcp4.digitalWrite(KEYTRACK_RED, HIGH);
  } else {
    if (announce) {
      showCurrentParameterPage("Key Track", "Off");
      startParameterDisplay();
    }
    midiCCOut(CCfilterKeyTrackSW, 0);
    mcp4.digitalWrite(KEYTRACK_RED, LOW);
  }
}

FLASHMEM void updatefilterVelocitySwitch(bool announce) {
  if (filterVelocitySW == 1) {
    if (announce) {
      showCurrentParameterPage("VCF Velocity", "On");
      startParameterDisplay();
    }
    midiCCOut(CCfilterVelocitySW, 127);
    mcp3.digitalWrite(FILTER_VELOCITY_RED, HIGH);
    srp.writePin(FILTER_VELOCITY_OUT, HIGH);
  } else {
    if (announce) {
      showCurrentParameterPage("VCF Velocity", "Off");
      startParameterDisplay();
    }
    midiCCOut(CCfilterVelocitySW, 0);
    mcp3.digitalWrite(FILTER_VELOCITY_RED, LOW);
    srp.writePin(FILTER_VELOCITY_OUT, LOW);
  }
}

FLASHMEM void updateampVelocitySwitch(bool announce) {
  if (ampVelocitySW == 1) {
    if (announce) {
      showCurrentParameterPage("VCA Velocity", "On");
      startParameterDisplay();
    }
    midiCCOut(CCampVelocitySW, 127);
    srp.writePin(AMP_VELOCITY_RED, HIGH);
    digitalWrite(AMP_VELOCITY_OUT, HIGH);
  } else {
    if (announce) {
      showCurrentParameterPage("VCA Velocity", "Off");
      startParameterDisplay();
    }
    midiCCOut(CCampVelocitySW, 0);
    srp.writePin(AMP_VELOCITY_RED, LOW);
    digitalWrite(AMP_VELOCITY_OUT, LOW);
  }
}

FLASHMEM void updateFMSyncSwitch(bool announce) {
  if (FMSyncSW == 1) {
    showCurrentParameterPage("FM Group", "On");
  } else {
    showCurrentParameterPage("FM Group", "Off");
  }
  startParameterDisplay();
}

FLASHMEM void updatePWSyncSwitch(bool announce) {
  if (PWSyncSW == 1) {
    showCurrentParameterPage("PW Group", "On");
  } else {
    showCurrentParameterPage("PW Group", "Off");
  }
  startParameterDisplay();
}

FLASHMEM void updatePWMSyncSwitch(bool announce) {
  if (PWMSyncSW == 1) {
    showCurrentParameterPage("PWM Group", "On");
  } else {
    showCurrentParameterPage("PWM Group", "Off");
  }
  startParameterDisplay();
}

FLASHMEM void updatemultiSwitch(bool announce) {
  if (multiSW == 1) {
    if (announce) {
      showCurrentParameterPage("Retrigger", "On");
      startParameterDisplay();
    }
    srp.writePin(MULTI_LED_RED, HIGH);
  } else {
    if (announce) {
      showCurrentParameterPage("Retrigger", "Off");
      startParameterDisplay();
    }
    srp.writePin(MULTI_LED_RED, LOW);
  }
}

FLASHMEM void updatefilterType(bool announce) {
  switch (filterType) {
    case 0:
      if (filterPoleSW == 1) {
        if (announce) {
          showCurrentParameterPage("Filter Type", "3P LowPass");
        }
      } else {
        if (announce) {
          showCurrentParameterPage("Filter Type", "4P LowPass");
        }
      }
      startParameterDisplay();
      midiCCOut(CCfilterType, 0);
      srp.writePin(FILTER_A, LOW);
      srp.writePin(FILTER_B, LOW);
      srp.writePin(FILTER_C, LOW);
      break;

    case 1:
      if (filterPoleSW == 1) {
        if (announce) {
          showCurrentParameterPage("Filter Type", "1P LowPass");
        }
      } else {
        if (announce) {
          showCurrentParameterPage("Filter Type", "2P LowPass");
        }
      }
      startParameterDisplay();
      midiCCOut(CCfilterType, 1);
      srp.writePin(FILTER_A, HIGH);
      srp.writePin(FILTER_B, LOW);
      srp.writePin(FILTER_C, LOW);
      break;

    case 2:
      if (filterPoleSW == 1) {
        if (announce) {
          showCurrentParameterPage("Filter Type", "3P HP + 1P LP");
        }
      } else {
        if (announce) {
          showCurrentParameterPage("Filter Type", "4P HighPass");
        }
      }
      startParameterDisplay();
      midiCCOut(CCfilterType, 2);
      srp.writePin(FILTER_A, LOW);
      srp.writePin(FILTER_B, HIGH);
      srp.writePin(FILTER_C, LOW);
      break;

    case 3:
      if (filterPoleSW == 1) {
        if (announce) {
          showCurrentParameterPage("Filter Type", "1P HP + 1P LP");
        }
      } else {
        if (announce) {
          showCurrentParameterPage("Filter Type", "2P HighPass");
        }
      }
      startParameterDisplay();
      midiCCOut(CCfilterType, 3);
      srp.writePin(FILTER_A, HIGH);
      srp.writePin(FILTER_B, HIGH);
      srp.writePin(FILTER_C, LOW);
      break;

    case 4:
      if (filterPoleSW == 1) {
        if (announce) {
          showCurrentParameterPage("Filter Type", "2P HP + 1P LP");
        }
      } else {
        if (announce) {
          showCurrentParameterPage("Filter Type", "4P BandPass");
        }
      }
      startParameterDisplay();
      midiCCOut(CCfilterType, 4);
      srp.writePin(FILTER_A, LOW);
      srp.writePin(FILTER_B, LOW);
      srp.writePin(FILTER_C, HIGH);
      break;

    case 5:
      if (filterPoleSW == 1) {
        if (announce) {
          showCurrentParameterPage("Filter Type", "2P BP + 1P LP");
        }
      } else {
        if (announce) {
          showCurrentParameterPage("Filter Type", "2P BandPass");
        }
      }
      startParameterDisplay();
      midiCCOut(CCfilterType, 5);
      srp.writePin(FILTER_A, HIGH);
      srp.writePin(FILTER_B, LOW);
      srp.writePin(FILTER_C, HIGH);
      break;

    case 6:
      if (filterPoleSW == 1) {
        if (announce) {
          showCurrentParameterPage("Filter Type", "3P AP + 1P LP");
        }
      } else {
        if (announce) {
          showCurrentParameterPage("Filter Type", "3P AllPass");
        }
      }
      startParameterDisplay();
      midiCCOut(CCfilterType, 6);
      srp.writePin(FILTER_A, LOW);
      srp.writePin(FILTER_B, HIGH);
      srp.writePin(FILTER_C, HIGH);
      break;

    case 7:
      if (filterPoleSW == 1) {
        if (announce) {
          showCurrentParameterPage("Filter Type", "2P Notch + LP");
        }
      } else {
        if (announce) {
          showCurrentParameterPage("Filter Type", "Notch");
        }
      }
      startParameterDisplay();
      midiCCOut(CCfilterType, 7);
      srp.writePin(FILTER_A, HIGH);
      srp.writePin(FILTER_B, HIGH);
      srp.writePin(FILTER_C, HIGH);
      break;
  }
}

void midiCCOut(byte cc, byte value) {
  MIDI.sendControlChange(cc, value, midiChannel);  //MIDI DIN main out
}

static constexpr float VREF_VOLTS = 2.5f;  // 2.5 for internal ref, 5.0 for external 5V ref
static constexpr float OUT_GAIN = 2.0f;    // 1.0 if gain×1, 2.0 if you enable the DAC’s ×2 mode
// ----------------------------------------

// clamp helper
static inline float clamp01f(float x) {
  return x < 0 ? 0 : (x > 1 ? 1 : x);
}

// Map 0..1 -> 12-bit code for a requested max voltage, respecting VREF and output gain.
static inline uint16_t code12_for_vmax(float x01, float requested_vmax) {
  const float fs_volts = VREF_VOLTS * OUT_GAIN;  // actual full-scale volts
  const float vmax = (requested_vmax > fs_volts) ? fs_volts : requested_vmax;
  const float y = clamp01f(x01) * (vmax / fs_volts) * 4095.0f;
  return (uint16_t)lroundf(y);
}

// Convert 0..1 → 12-bit (matches helpers shown earlier)
static inline uint16_t to12(float x) {
  x = clamp01(x);
  return (uint16_t)(x * 4095.0f + 0.5f);
}

// Keep this helper
inline void split_bipolar_depth(int val, float &d1, float &d2) {
  if (val < 0) {
    d1 = (-val) / 127.0f;  // LFO1 depth
    d2 = 0.0f;
  } else {
    d1 = 0.0f;
    d2 = val / 127.0f;  // LFO2 depth
  }
}

inline float depth_signed_01(int val) {
  return (float)val / 127.0f;  // -127 → -1.0, +127 → +1.0
}

void updateFilterDACAll() {
  // Base cutoff from encoder (0–255 → 0..1)
  const float baseCut = filterCutoff / 255.0f;

  // Keytrack: bipolar −127..+127, only if switch is enabled
  const float ktDepth = filterKeyTrackSW ? depth_signed_01(filterKeyTrack) : 0.0f;

  // Split LFO depth (encoder −127..+127) into LFO1 (d1) and LFO2 (d2)
  float d1 = 0, d2 = 0;
  split_bipolar_depth(filterLFODepth, d1, d2);

  // Unipolar versions of both LFOs (−1..+1 → 0..1)
  const float lfo1_uni = 0.5f * g_latestLFO + 0.5f;
  const float lfo2_uni = 0.5f * g_latestLFO2 + 0.5f;

  for (int v = 1; v <= 8; ++v) {
    float cv = baseCut;

    // Keytrack: convert note freq to MIDI, then 0..1
    if (ktDepth != 0.0f) {
      const float midi = freq_to_midi(voiceFreq(v));
      cv += ktDepth * midi_to01(midi);
    }

    // LFO contribution
    if (LFODelayGo) {
      cv += d1 * lfo1_uni + d2 * lfo2_uni;
    }

    // Clamp to 0..1, scale to 12-bit DAC
    cv = clamp01(cv);
    const uint16_t code12 = (uint16_t)lroundf(cv * 4095.0f);

    // Voice → DAC channel
    const uint8_t ch = (uint8_t)(DAC_A + (v - 1));
    dacWriteBuffered(DAC_FILTER, ch, code12);
  }
}

void updateTremoloCV() {
  float d1 = 0, d2 = 0;
  split_bipolar_depth(ampLFODepth, d1, d2);

  // Unipolar versions of the two LFOs
  const float lfo1_uni = 0.5f * g_latestLFO_amp + 0.5f;   // 0..1
  const float lfo2_uni = 0.5f * g_latestLFO2_amp + 0.5f;  // 0..1

  float mod = 0.5f;  // midpoint = "no tremolo"

  if (LFODelayGo) {
    mod = (d1 * lfo1_uni) + (d2 * lfo2_uni);  // same as before
  }

  // Now cv is 0..1, centered at 0.5 when depth=0
  // Scale so that depth=0 → center = 0.5
  float cv = 0.5f + (mod - 0.5f) * (fabsf(d1) + fabsf(d2));
  cv = clamp01(cv);

  // Map 0..1 to 0..2V output
  float volts = cv * 2.0f;  // 0..2 V
  if (volts < 0) volts = 0;
  if (volts > 2.0f) volts = 2.0f;

  uint16_t code12 = (uint16_t)lroundf((volts / 5.0f) * 4095.0f);

  dacWriteBuffered(DAC_GLOBAL, DAC_F, code12);
}

FLASHMEM void updatevcoAPWMsource(bool announce) {
  switch (vcoAPWMsource) {
    case 0:  // no modulation
      if (announce) {
        showCurrentParameterPage("VCO A PWM", "Off");
        startParameterDisplay();
      }
      mcp8.digitalWrite(PWM_A_GREEN, LOW);
      mcp8.digitalWrite(PWM_A_RED, LOW);
      for (int v = 1; v <= VOICES; ++v) pwmA[v]->gain(0, 0);  // input 0 = LFO2
      for (int v = 1; v <= VOICES; ++v) pwmA[v]->gain(1, 0);  // input 0 = env1
      for (int v = 1; v <= VOICES; ++v) pwmA[v]->gain(2, 0);  // input 0 = inv env1
      break;

    case 1:  // LFO2 Modulation
      if (announce) {
        showCurrentParameterPage("VCO A PWM", "LFO2");
        startParameterDisplay();
      }
      mcp8.digitalWrite(PWM_A_GREEN, LOW);
      mcp8.digitalWrite(PWM_A_RED, HIGH);
      for (int v = 1; v <= VOICES; ++v) pwmA[v]->gain(1, 0);  // input 0 = env1
      for (int v = 1; v <= VOICES; ++v) pwmA[v]->gain(2, 0);  // input 0 = inv env1
      break;

    case 2:  // Env Modulation
      if (announce) {
        showCurrentParameterPage("VCO A PWM", "Pitch Env");
        startParameterDisplay();
      }
      mcp8.digitalWrite(PWM_A_GREEN, HIGH);
      mcp8.digitalWrite(PWM_A_RED, LOW);
      for (int v = 1; v <= VOICES; ++v) pwmA[v]->gain(0, 0);  // input 0 = LFO2
      for (int v = 1; v <= VOICES; ++v) pwmA[v]->gain(2, 0);  // input 0 = inv env1
      break;

    case 3:  // Inv Env Modulation
      if (announce) {
        showCurrentParameterPage("VCO A PWM", "Pitch Env Inv");
        startParameterDisplay();
      }
      mcp8.digitalWrite(PWM_A_GREEN, HIGH);
      mcp8.digitalWrite(PWM_A_RED, HIGH);
      for (int v = 1; v <= VOICES; ++v) pwmA[v]->gain(0, 0);  // input 0 = LFO2
      for (int v = 1; v <= VOICES; ++v) pwmA[v]->gain(1, 0);  // input 0 = env1
      break;
  }
  updatevcoAPWM(0);
}

FLASHMEM void updatevcoBPWMsource(bool announce) {
  switch (vcoBPWMsource) {
    case 0:  // no modulation
      if (announce) {
        showCurrentParameterPage("VCO B PWM", "Off");
        startParameterDisplay();
      }
      mcp8.digitalWrite(PWM_B_GREEN, LOW);
      mcp8.digitalWrite(PWM_B_RED, LOW);
      for (int v = 1; v <= VOICES; ++v) pwmB[v]->gain(0, 0);  // input 0 = LFO2
      for (int v = 1; v <= VOICES; ++v) pwmB[v]->gain(1, 0);  // input 0 = env1
      for (int v = 1; v <= VOICES; ++v) pwmB[v]->gain(2, 0);  // input 0 = inv env1
      break;

    case 1:  // LFO2 Modulation
      if (announce) {
        showCurrentParameterPage("VCO B PWM", "LFO2");
        startParameterDisplay();
      }
      mcp8.digitalWrite(PWM_B_GREEN, LOW);
      mcp8.digitalWrite(PWM_B_RED, HIGH);
      for (int v = 1; v <= VOICES; ++v) pwmB[v]->gain(1, 0);  // input 0 = env1
      for (int v = 1; v <= VOICES; ++v) pwmB[v]->gain(2, 0);  // input 0 = inv env1
      break;

    case 2:  // Env Modulation
      if (announce) {
        showCurrentParameterPage("VCO B PWM", "Pitch Env");
        startParameterDisplay();
      }
      mcp8.digitalWrite(PWM_B_GREEN, HIGH);
      mcp8.digitalWrite(PWM_B_RED, LOW);
      for (int v = 1; v <= VOICES; ++v) pwmB[v]->gain(0, 0);  // input 0 = LFO2
      for (int v = 1; v <= VOICES; ++v) pwmB[v]->gain(2, 0);  // input 0 = inv env1
      break;

    case 3:  // Inv Env Modulation
      if (announce) {
        showCurrentParameterPage("VCO B PWM", "Pitch Env Inv");
        startParameterDisplay();
      }
      mcp8.digitalWrite(PWM_B_GREEN, HIGH);
      mcp8.digitalWrite(PWM_B_RED, HIGH);
      for (int v = 1; v <= VOICES; ++v) pwmB[v]->gain(0, 0);  // input 0 = LFO2
      for (int v = 1; v <= VOICES; ++v) pwmB[v]->gain(1, 0);  // input 0 = env1
      break;
  }
  updatevcoBPWM(0);
}

FLASHMEM void updatevcoCPWMsource(bool announce) {
  switch (vcoCPWMsource) {
    case 0:  // no modulation
      if (announce) {
        showCurrentParameterPage("VCO C PWM", "Off");
        startParameterDisplay();
      }
      mcp7.digitalWrite(PWM_C_GREEN, LOW);
      mcp7.digitalWrite(PWM_C_RED, LOW);
      for (int v = 1; v <= VOICES; ++v) pwmC[v]->gain(0, 0);  // input 0 = LFO2
      for (int v = 1; v <= VOICES; ++v) pwmC[v]->gain(1, 0);  // input 0 = env1
      for (int v = 1; v <= VOICES; ++v) pwmC[v]->gain(2, 0);  // input 0 = inv env1
      break;

    case 1:  // LFO2 Modulation
      if (announce) {
        showCurrentParameterPage("VCO C PWM", "LFO2");
        startParameterDisplay();
      }
      mcp7.digitalWrite(PWM_C_GREEN, LOW);
      mcp7.digitalWrite(PWM_C_RED, HIGH);
      for (int v = 1; v <= VOICES; ++v) pwmC[v]->gain(1, 0);  // input 0 = env1
      for (int v = 1; v <= VOICES; ++v) pwmC[v]->gain(2, 0);  // input 0 = inv env1
      break;

    case 2:  // Env Modulation
      if (announce) {
        showCurrentParameterPage("VCO C PWM", "Pitch Env");
        startParameterDisplay();
      }
      mcp7.digitalWrite(PWM_C_GREEN, HIGH);
      mcp7.digitalWrite(PWM_C_RED, LOW);
      for (int v = 1; v <= VOICES; ++v) pwmC[v]->gain(0, 0);  // input 0 = LFO2
      for (int v = 1; v <= VOICES; ++v) pwmC[v]->gain(2, 0);  // input 0 = inv env1
      break;

    case 3:  // Inv Env Modulation
      if (announce) {
        showCurrentParameterPage("VCO C PWM", "Pitch Env Inv");
        startParameterDisplay();
      }
      mcp7.digitalWrite(PWM_C_GREEN, HIGH);
      mcp7.digitalWrite(PWM_C_RED, HIGH);
      for (int v = 1; v <= VOICES; ++v) pwmC[v]->gain(0, 0);  // input 0 = LFO2
      for (int v = 1; v <= VOICES; ++v) pwmC[v]->gain(1, 0);  // input 0 = env1
      break;
  }
  updatevcoCPWM(0);
}

FLASHMEM void updatevcoAFMsource(bool announce) {
  switch (vcoAFMsource) {
    case 0:  // no modulation
      if (announce) {
        showCurrentParameterPage("VCO A FM", "Off");
        startParameterDisplay();
      }
      mcp7.digitalWrite(FM_A_GREEN, LOW);
      mcp7.digitalWrite(FM_A_RED, LOW);

      for (int v = 1; v <= VOICES; ++v) pitchA[v]->gain(0, 0);  // input 0 = LFO2
      for (int v = 1; v <= VOICES; ++v) pitchA[v]->gain(1, 0);  // input 0 = env1
      for (int v = 1; v <= VOICES; ++v) pitchA[v]->gain(2, 0);  // input 0 = inv env1
      break;

    case 1:  // LFO2 Modulation
      if (announce) {
        showCurrentParameterPage("VCO A FM", "LFO1");
        startParameterDisplay();
      }
      mcp7.digitalWrite(FM_A_GREEN, LOW);
      mcp7.digitalWrite(FM_A_RED, HIGH);
      for (int v = 1; v <= VOICES; ++v) pitchA[v]->gain(1, 0);  // input 0 = env1
      for (int v = 1; v <= VOICES; ++v) pitchA[v]->gain(2, 0);  // input 0 = inv env1
      break;

    case 2:  // Env Modulation
      if (announce) {
        showCurrentParameterPage("VCO A FM", "Pitch Env");
        startParameterDisplay();
      }
      mcp7.digitalWrite(FM_A_GREEN, HIGH);
      mcp7.digitalWrite(FM_A_RED, LOW);
      for (int v = 1; v <= VOICES; ++v) pitchA[v]->gain(0, 0);  // input 0 = LFO2
      for (int v = 1; v <= VOICES; ++v) pitchA[v]->gain(2, 0);  // input 0 = inv env1
      break;

    case 3:  // Inv Env Modulation
      if (announce) {
        showCurrentParameterPage("VCO A FM", "Pitch Env Inv");
        startParameterDisplay();
      }
      mcp7.digitalWrite(FM_A_GREEN, HIGH);
      mcp7.digitalWrite(FM_A_RED, HIGH);
      for (int v = 1; v <= VOICES; ++v) pitchA[v]->gain(0, 0);  // input 0 = LFO2
      for (int v = 1; v <= VOICES; ++v) pitchA[v]->gain(1, 0);  // input 0 = env1
      break;
  }
  updatevcoAFMDepth(0);
}

FLASHMEM void updatevcoBFMsource(bool announce) {
  switch (vcoBFMsource) {
    case 0:  // no modulation
      if (announce) {
        showCurrentParameterPage("VCO B FM", "Off");
        startParameterDisplay();
      }
      mcp6.digitalWrite(FM_B_GREEN, LOW);
      mcp6.digitalWrite(FM_B_RED, LOW);
      for (int v = 1; v <= VOICES; ++v) pitchB[v]->gain(0, 0);  // input 0 = LFO2
      for (int v = 1; v <= VOICES; ++v) pitchB[v]->gain(1, 0);  // input 0 = env1
      for (int v = 1; v <= VOICES; ++v) pitchB[v]->gain(2, 0);  // input 0 = inv env1
      break;

    case 1:  // LFO2 Modulation
      if (announce) {
        showCurrentParameterPage("VCO B FM", "LFO1");
        startParameterDisplay();
      }
      mcp6.digitalWrite(FM_B_GREEN, LOW);
      mcp6.digitalWrite(FM_B_RED, HIGH);
      for (int v = 1; v <= VOICES; ++v) pitchB[v]->gain(1, 0);  // input 0 = env1
      for (int v = 1; v <= VOICES; ++v) pitchB[v]->gain(2, 0);  // input 0 = inv env1
      break;

    case 2:  // Env Modulation
      if (announce) {
        showCurrentParameterPage("VCO B FM", "Pitch Env");
        startParameterDisplay();
      }
      mcp6.digitalWrite(FM_B_GREEN, HIGH);
      mcp6.digitalWrite(FM_B_RED, LOW);
      for (int v = 1; v <= VOICES; ++v) pitchB[v]->gain(0, 0);  // input 0 = LFO2
      for (int v = 1; v <= VOICES; ++v) pitchB[v]->gain(2, 0);  // input 0 = inv env1
      break;

    case 3:  // Inv Env Modulation
      if (announce) {
        showCurrentParameterPage("VCO B FM", "Pitch Env Inv");
        startParameterDisplay();
      }
      mcp6.digitalWrite(FM_B_GREEN, HIGH);
      mcp6.digitalWrite(FM_B_RED, HIGH);
      for (int v = 1; v <= VOICES; ++v) pitchB[v]->gain(0, 0);  // input 0 = LFO2
      for (int v = 1; v <= VOICES; ++v) pitchB[v]->gain(1, 0);  // input 0 = env1
      break;
  }
  updatevcoBFMDepth(0);
}

FLASHMEM void updatevcoCFMsource(bool announce) {
  switch (vcoCFMsource) {
    case 0:  // no modulation
      if (announce) {
        showCurrentParameterPage("VCO C FM", "Off");
        startParameterDisplay();
      }
      mcp6.digitalWrite(FM_C_GREEN, LOW);
      mcp6.digitalWrite(FM_C_RED, LOW);
      for (int v = 1; v <= VOICES; ++v) pitchC[v]->gain(0, 0);  // input 0 = LFO2
      for (int v = 1; v <= VOICES; ++v) pitchC[v]->gain(1, 0);  // input 0 = env1
      for (int v = 1; v <= VOICES; ++v) pitchC[v]->gain(2, 0);  // input 0 = inv env1
      break;

    case 1:  // LFO2 Modulation
      if (announce) {
        showCurrentParameterPage("VCO C FM", "LFO1");
        startParameterDisplay();
      }
      mcp6.digitalWrite(FM_C_GREEN, LOW);
      mcp6.digitalWrite(FM_C_RED, HIGH);
      for (int v = 1; v <= VOICES; ++v) pitchC[v]->gain(1, 0);  // input 0 = env1
      for (int v = 1; v <= VOICES; ++v) pitchC[v]->gain(2, 0);  // input 0 = inv env1
      break;

    case 2:  // Env Modulation
      if (announce) {
        showCurrentParameterPage("VCO C FM", "Pitch Env");
        startParameterDisplay();
      }
      mcp6.digitalWrite(FM_C_GREEN, HIGH);
      mcp6.digitalWrite(FM_C_RED, LOW);
      for (int v = 1; v <= VOICES; ++v) pitchC[v]->gain(0, 0);  // input 0 = LFO2
      for (int v = 1; v <= VOICES; ++v) pitchC[v]->gain(2, 0);  // input 0 = inv env1
      break;

    case 3:  // Inv Env Modulation
      if (announce) {
        showCurrentParameterPage("VCO C FM", "Pitch Env Inv");
        startParameterDisplay();
      }
      mcp6.digitalWrite(FM_C_GREEN, HIGH);
      mcp6.digitalWrite(FM_C_RED, HIGH);
      for (int v = 1; v <= VOICES; ++v) pitchC[v]->gain(0, 0);  // input 0 = LFO2
      for (int v = 1; v <= VOICES; ++v) pitchC[v]->gain(1, 0);  // input 0 = env1
      break;
  }
  updatevcoCFMDepth(0);
}

FLASHMEM void updatevcoAOctave(bool announce) {
  if (announce) {
    switch (vcoAOctave) {
      case 0:
        showCurrentParameterPage("VCOA Octave", "16 Foot");
        break;
      case 1:
        showCurrentParameterPage("VCOA Octave", "8 Foot");
        break;
      case 2:
        showCurrentParameterPage("VCOA Octave", "4 Foot");
        break;
    }
    startParameterDisplay();
  }
  switch (vcoAOctave) {
    case 0:
      octave = 0.5;
      mcp5.digitalWrite(A_OCTAVE_GREEN, LOW);
      mcp5.digitalWrite(A_OCTAVE_RED, HIGH);
      break;
    case 1:
      octave = 1.0;
      mcp5.digitalWrite(A_OCTAVE_GREEN, LOW);
      mcp5.digitalWrite(A_OCTAVE_RED, LOW);
      break;
    case 2:
      octave = 2.0;
      mcp5.digitalWrite(A_OCTAVE_GREEN, HIGH);
      mcp5.digitalWrite(A_OCTAVE_RED, LOW);
      break;
  }
  pitchDirty = true;
}

FLASHMEM void updatevcoBOctave(bool announce) {
  if (announce) {
    switch (vcoBOctave) {
      case 0:
        showCurrentParameterPage("VCOB Octave", "16 Foot");
        break;
      case 1:
        showCurrentParameterPage("VCOB Octave", "8 Foot");
        break;
      case 2:
        showCurrentParameterPage("VCOB Octave", "4 Foot");
        break;
    }
    startParameterDisplay();
  }
  switch (vcoBOctave) {
    case 0:
      octaveB = 0.5;
      mcp5.digitalWrite(B_OCTAVE_GREEN, LOW);
      mcp5.digitalWrite(B_OCTAVE_RED, HIGH);
      break;
    case 1:
      octaveB = 1.0;
      mcp5.digitalWrite(B_OCTAVE_GREEN, LOW);
      mcp5.digitalWrite(B_OCTAVE_RED, LOW);
      break;
    case 2:
      octaveB = 2.0;
      mcp5.digitalWrite(B_OCTAVE_GREEN, HIGH);
      mcp5.digitalWrite(B_OCTAVE_RED, LOW);
      break;
  }
  pitchDirty = true;
}

FLASHMEM void updatevcoCOctave(bool announce) {
  if (announce) {
    switch (vcoCOctave) {
      case 0:
        showCurrentParameterPage("VCOC Octave", "16 Foot");
        break;
      case 1:
        showCurrentParameterPage("VCOC Octave", "8 Foot");
        break;
      case 2:
        showCurrentParameterPage("VCOC Octave", "4 Foot");
        break;
    }
    startParameterDisplay();
  }
  switch (vcoCOctave) {
    case 0:
      octaveC = 0.5;
      mcp4.digitalWrite(C_OCTAVE_GREEN, LOW);
      mcp4.digitalWrite(C_OCTAVE_RED, HIGH);
      break;
    case 1:
      octaveC = 1.0;
      mcp4.digitalWrite(C_OCTAVE_GREEN, LOW);
      mcp4.digitalWrite(C_OCTAVE_RED, LOW);
      break;
    case 2:
      octaveC = 2.0;
      mcp4.digitalWrite(C_OCTAVE_GREEN, HIGH);
      mcp4.digitalWrite(C_OCTAVE_RED, LOW);
      break;
  }
  pitchDirty = true;
}

FLASHMEM void updateplayModeSW(bool announce) {
  if (announce) {
    switch (playModeSW) {
      case 0:
        showCurrentParameterPage("Play Mode", "Poly 1");
        break;
      case 1:
        showCurrentParameterPage("Play Mode", "Poly 2");
        break;
      case 2:
        showCurrentParameterPage("Play Mode", "Monophonic");
        break;
      case 3:
        showCurrentParameterPage("Play Mode", "Unison");
        break;
    }
    startParameterDisplay();
  }

  // --- RESET GLIDE + NOTE STATE FOR ALL MODES ---
  for (int v = 0; v < NO_OF_VOICES; v++) {
    voiceCurrentNote[v] = -1;  // force reset on first note
    voiceTargetNote[v] = -1;
    voiceGlideActive[v] = false;
  }
  env1on = false;
  pitchDirty = true;

  memset(notes, 0, sizeof(notes));
  memset(noteOrder, 0, sizeof(noteOrder));
  orderIndx = 0;

  // --- Apply mode-specific behavior ---
  switch (playModeSW) {
    case 0:  // POLY 1
      mcp2.digitalWrite(PLAY_MODE_RED, LOW);
      mcp2.digitalWrite(PLAY_MODE_GREEN, LOW);
      mcp1.digitalWrite(NOTE_PRIORITY_RED, LOW);
      mcp1.digitalWrite(NOTE_PRIORITY_GREEN, LOW);
      for (int i = 0; i < NO_OF_VOICES; i++) {
        voiceDetune[i] = 1.000;
      }
      allNotesOff();
      break;

    case 1:  // POLY 2
      mcp2.digitalWrite(PLAY_MODE_RED, HIGH);
      mcp2.digitalWrite(PLAY_MODE_GREEN, HIGH);
      mcp1.digitalWrite(NOTE_PRIORITY_RED, LOW);
      mcp1.digitalWrite(NOTE_PRIORITY_GREEN, LOW);
      for (int i = 0; i < NO_OF_VOICES; i++) {
        voiceDetune[i] = 1.000;
      }
      allNotesOff();
      break;

    case 2:  // MONO
      mcp2.digitalWrite(PLAY_MODE_RED, HIGH);
      mcp2.digitalWrite(PLAY_MODE_GREEN, LOW);
      allNotesOff();  // stops envelopes

      monoLastNote = -1;
      monoActive = false;
      voiceGlideActive[0] = false;
      voiceCurrentNote[0] = -1.0f;
      voiceTargetNote[0] = -1.0f;
      break;

    case 3:  // UNISON
      mcp2.digitalWrite(PLAY_MODE_RED, LOW);
      mcp2.digitalWrite(PLAY_MODE_GREEN, HIGH);
      allNotesOff();
      break;
  }

  updatenotePrioritySW(0);
}

FLASHMEM void updatearpRange(bool announce) {
  if (announce) {
    // UI feedback
    char buf[8];
    sprintf(buf, "%u oct", arpRange);
    showCurrentParameterPage("Arp Range", buf);
    startParameterDisplay();
  }
  switch (arpRange) {
    case 1:
      mcp5.digitalWrite(B_OCTAVE_RED, LOW);
      mcp5.digitalWrite(B_OCTAVE_GREEN, LOW);
      break;

    case 2:
      mcp5.digitalWrite(B_OCTAVE_RED, HIGH);
      mcp5.digitalWrite(B_OCTAVE_GREEN, LOW);
      break;

    case 3:
      mcp5.digitalWrite(B_OCTAVE_RED, LOW);
      mcp5.digitalWrite(B_OCTAVE_GREEN, HIGH);
      break;

    case 4:
      mcp5.digitalWrite(B_OCTAVE_RED, HIGH);
      mcp5.digitalWrite(B_OCTAVE_GREEN, HIGH);
      break;
  }
}

FLASHMEM void updatearpDirection(bool announce) {
  if (announce) {
    const char *dirName = (arpDirection == 0) ? "Up" : (arpDirection == 1) ? "Down"
                                                     : (arpDirection == 2) ? "Up/Down"
                                                                           : "Random";
    showCurrentParameterPage("Arp Direction", dirName);
    startParameterDisplay();
  }
  switch (arpDirection) {
    case 0:
      mcp4.digitalWrite(C_OCTAVE_RED, LOW);
      mcp4.digitalWrite(C_OCTAVE_GREEN, LOW);
      break;

    case 1:
      mcp4.digitalWrite(C_OCTAVE_RED, HIGH);
      mcp4.digitalWrite(C_OCTAVE_GREEN, LOW);
      break;

    case 2:
      mcp4.digitalWrite(C_OCTAVE_RED, LOW);
      mcp4.digitalWrite(C_OCTAVE_GREEN, HIGH);
      break;

    case 3:
      mcp4.digitalWrite(C_OCTAVE_RED, HIGH);
      mcp4.digitalWrite(C_OCTAVE_GREEN, HIGH);
      break;
  }
}

FLASHMEM void updatearpRunning(bool announce) {
  if (announce) {
    if (!arpRunning) {
      showCurrentParameterPage("Arp", "Stop");
    } else {
      showCurrentParameterPage("Arp", "Start");
    }
    startParameterDisplay();
  }
  if (!arpRunning) {
    srp.writePin(AMP_VELOCITY_RED, LOW);
  } else {
    srp.writePin(AMP_VELOCITY_RED, HIGH);
  }
}

FLASHMEM void updatearpHold(bool announce) {
  if (announce) {
    showCurrentParameterPage("Arp Hold", arpHold ? "On" : "Off");
    startParameterDisplay();
  }
  switch (arpHold) {
    case 0:
      mcp3.digitalWrite(FILTER_VELOCITY_RED, LOW);
      break;

    case 1:
      mcp3.digitalWrite(FILTER_VELOCITY_RED, HIGH);
      break;
  }
}

FLASHMEM void updatearpEnabled(bool announce) {
  arpEnable();
}

FLASHMEM void updatearpRate(bool announce) {

  // linear in milliseconds, 800 ms .. 40 ms
  const float minMs = 40.0f, maxMs = 800.0f;
  const float norm = arpRate / 127.0f;
  arpTempoMs = (uint16_t)(maxMs - norm * (maxMs - minMs));
  arpIntervalUs = (uint32_t)arpTempoMs * 1000u;

  // derived
  arpGateUs = (uint32_t)(arpIntervalUs * arpGate);
  arpTimer = 0;
  arpGateTimer = 0;
  if (announce) {
    const float hz = arpHzFromIntervalUs(arpIntervalUs);
    showCurrentParameterPage("Arp Rate", fmtHz(hz));
    startParameterDisplay();
  }
}

FLASHMEM void updatearpGateTime(bool announce) {
  arpGate = 0.05f + 0.90f * (arpGateTime / 127.0f);
  arpGateUs = (uint32_t)(arpIntervalUs * arpGate);
  arpGateTimer = 0;
  if (announce) {
    showCurrentParameterPage("Arp Gate", String((int)roundf(arpGate * 100)) + "%");
    startParameterDisplay();
  }
}

FLASHMEM void updatenotePrioritySW(bool announce) {
  if (playModeSW > 1) {
    if (announce) {
      switch (notePrioritySW) {
        case 0:
          showCurrentParameterPage("Note Priority", "Bottom");
          break;
        case 1:
          showCurrentParameterPage("Note Priority", "Top");
          break;
        case 2:
          showCurrentParameterPage("Note Priority", "Last");
          break;
      }
      startParameterDisplay();
    }
    switch (notePrioritySW) {
      case 0:
        mcp1.digitalWrite(NOTE_PRIORITY_RED, HIGH);
        mcp1.digitalWrite(NOTE_PRIORITY_GREEN, LOW);
        break;
      case 1:
        mcp1.digitalWrite(NOTE_PRIORITY_RED, LOW);
        mcp1.digitalWrite(NOTE_PRIORITY_GREEN, HIGH);
        break;
      case 2:
        mcp1.digitalWrite(NOTE_PRIORITY_RED, HIGH);
        mcp1.digitalWrite(NOTE_PRIORITY_GREEN, HIGH);
        break;
    }
  }
}

FLASHMEM void updateLFO1Wave(bool announce) {
  if (announce) {
    switch (LFO1Wave) {
      case 0:
        showCurrentParameterPage("LFO1 Wave", "Sine");
        break;
      case 1:
        showCurrentParameterPage("LFO1 Wave", "Saw");
        break;
      case 2:
        showCurrentParameterPage("LFO1 Wave", "Reverse Saw");
        break;
      case 3:
        showCurrentParameterPage("LFO1 Wave", "Square");
        break;
      case 4:
        showCurrentParameterPage("LFO1 Wave", "Triangle");
        break;
      case 5:
        showCurrentParameterPage("LFO1 Wave", "Pulse");
        break;
      case 6:
        showCurrentParameterPage("LFO1 Wave", "S & H");
        break;
    }
    startParameterDisplay();
  }
  switch (LFO1Wave) {
    case 0:
      LFO1.begin(WAVEFORM_SINE);
      break;
    case 1:
      LFO1.begin(WAVEFORM_BANDLIMIT_SAWTOOTH);
      break;
    case 2:
      LFO1.begin(WAVEFORM_BANDLIMIT_SAWTOOTH_REVERSE);
      break;
    case 3:
      LFO1.begin(WAVEFORM_BANDLIMIT_SQUARE);
      break;
    case 4:
      LFO1.begin(WAVEFORM_TRIANGLE_VARIABLE);
      break;
    case 5:
      LFO1.begin(WAVEFORM_BANDLIMIT_PULSE);
      break;
    case 6:
      LFO1.begin(WAVEFORM_SAMPLE_HOLD);
      break;
  }
}

FLASHMEM void updateLFO2Wave(bool announce) {
  if (announce) {
    switch (LFO2Wave) {
      case 0:
        showCurrentParameterPage("LFO2 Wave", "Sine");
        break;
      case 1:
        showCurrentParameterPage("LFO2 Wave", "Saw");
        break;
      case 2:
        showCurrentParameterPage("LFO2 Wave", "Reverse Saw");
        break;
      case 3:
        showCurrentParameterPage("LFO2 Wave", "Square");
        break;
      case 4:
        showCurrentParameterPage("LFO2 Wave", "Triangle");
        break;
      case 5:
        showCurrentParameterPage("LFO2 Wave", "Pulse");
        break;
      case 6:
        showCurrentParameterPage("LFO2 Wave", "S & H");
        break;
    }
    startParameterDisplay();
  }
  switch (LFO2Wave) {
    case 0:
      LFO2.begin(WAVEFORM_SINE);
      break;
    case 1:
      LFO2.begin(WAVEFORM_BANDLIMIT_SAWTOOTH);
      break;
    case 2:
      LFO2.begin(WAVEFORM_BANDLIMIT_SAWTOOTH_REVERSE);
      break;
    case 3:
      LFO2.begin(WAVEFORM_BANDLIMIT_SQUARE);
      break;
    case 4:
      LFO2.begin(WAVEFORM_TRIANGLE_VARIABLE);
      break;
    case 5:
      LFO2.begin(WAVEFORM_BANDLIMIT_PULSE);
      break;
    case 6:
      LFO2.begin(WAVEFORM_SAMPLE_HOLD);
      break;
  }
}

// ---- Helpers ----
static inline float arpHzFromIntervalUs(uint32_t us) {
  if (us == 0) return 0.0f;
  return 1000000.0f / (float)us;  // Hz
}

static inline String fmtHz(float hz) {
  // 0.00–9.99 -> 2dp; >=10 -> 1dp
  char buf[16];
  if (hz < 10.0f) snprintf(buf, sizeof(buf), "%.2f Hz", hz);
  else snprintf(buf, sizeof(buf), "%.1f Hz", hz);
  return String(buf);
}
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
void loop() {

  usbMIDI.read(midiChannel);
  MIDI.read(midiChannel);

  checkEncoder();
  checkSwitches();
  pollAllMCPs();
  octoswitch.update();
  srp.update();
  LFODelayHandle();
  handleLFODepthWithDelay();
  changeSpeed();
  updateEEPromSettings();

  if (pitchDirty || anyGlideActive()) {
    if (msSincePitchUpdate > 2) {
      stepAllGlides();
      updateVoice1();
      updateVoice2();
      updateVoice3();
      updateVoice4();
      updateVoice5();
      updateVoice6();
      updateVoice7();
      updateVoice8();
      msSincePitchUpdate = 0;
      pitchDirty = anyGlideActive();  // stay dirty while gliding
    }
  }

  // === NEW: ARP ENGINE ===
  arpGateService();
  arpStepEngine();


  // --- LFO1 (bipolar) ---
  if (qLFO1.available()) {
    int16_t *b = qLFO1.readBuffer();
    g_latestLFO = s16_to_float(b[127]);  // last sample of the block
    qLFO1.freeBuffer();
  }

  // --- LFO1_amp (bipolar) ---
  if (qLFO1_amp.available()) {
    int16_t *b = qLFO1_amp.readBuffer();
    g_latestLFO_amp = s16_to_float(b[127]);  // last sample of the block
    qLFO1_amp.freeBuffer();
  }

  if (qLFO2.available()) {
    int16_t *b = qLFO2.readBuffer();
    g_latestLFO2 = s16_to_float(b[127]);  // last sample of the block
    qLFO2.freeBuffer();
  }

  if (qLFO2_amp.available()) {  // only if you added the amp tap
    int16_t *b = qLFO2_amp.readBuffer();
    g_latestLFO2_amp = s16_to_float(b[127]);  // last sample of the block
    qLFO2_amp.freeBuffer();
  }

  updateFilterDACAll();
  updateTremoloCV();

  if (waitingToUpdate && (millis() - lastDisplayTriggerTime >= displayTimeout)) {
    updateScreen();  // retrigger
    waitingToUpdate = false;
  }
}
