craigyjp/Teensy-Hybrid-TDM-Synth/(commit log)

2025-09-08 Envelopes and LFOs sent to DACs
    Additional queues have been added for LFO1 and LFO2, both the filter and amplifiers can be modulated by either.
2025-09-08 Added multiple LFO waves, white & pink noise is working
    [HWControls.h, MidiCC.h, Parameters.h, TDM_Synth.ino]
2025-09-11 Added keytrack and octave switching, +/- EG Depth
2025-09-11 Fixed bug on Wave C selection
    [Constants.h, MidiCC.h, Parameters.h, TDM_Synth.ino]
2025-09-11 Added Sync to FM, PW and PWM
2025-09-11 Added noise center off push encoder
    [HWControls.h, MidiCC.h, Parameters.h, TDM_Synth.ino]
2025-09-13 Fixed parameter locks for buttons
    [Parameters.h, TDM_Synth.ino]
2025-09-14 Added effects buttons
2025-10-11 Added wavetables to each VCO (Switchable)
2025-10-15 Added poly/mono/unison switch and priority
2025-10-15 fixed no sound at cold start
    [TDM_Synth.ino]
2025-10-16 Fixed MidiCC control for cutoff and res as a test
    [Constants.h, EepromMgr.h, HWControls.h, MidiCC.h, Parameters.h, ST7735Display.h, Settings.h]
2025-10-16 over wrote wrong repo
    [Constants.h, EepromMgr.h, HWControls.h, MidiCC.h, Parameters.h, ST7735Display.h, Settings.h]
2025-10-17 Add delayed LFO to pitch, filter, amp
2025-10-17 Add features section to README
    Added a features section detailing the capabilities of the synthesizer, including voice modes, waveforms, filters, modulation options, and connectivity.
2025-10-17 Add noise source to filter in README
2025-10-17 Added a more natural velocity output
2025-10-17 Added effectsMix center button and labelling
2025-10-18 Added switches to CC control
2025-10-18 Fixing logic around delayed LFO and FMSync
    [Parameters.h, ST7735Display.h, TDM_Synth.ino]
2025-10-18 Added preliminary schematics
2025-10-22 Fixed slow encoders
2025-10-22 Removed Teensy threads
2025-10-24 Updated encoder and button labels
2025-12-12 Added more LEDs for arpeggiator
